Brmanzo/esp-computer-vision/docs/showcase_poster.pdf

## Network Quantization

- Weights start as floating points, then progressive QAT gradually reduces precision as low as ternary (2-bit).
- Learned weights captured as integers and exported to verilog ROM files for simulation and synthesis.
- During training, each neural network layer dynamically learns the optimal clipping range (2b
) and scale (1/(2shift)).
- In hardware, the scale and shifted range are exported as Verilog Parameters for each layer.

Parameterized Clipping Activation (PACT) [2]

Unified Progressive [Weight] Quantization (UPQ) [1]

- Pixels arrive once-per-cycle in row-major-order, streaming into the line buffers.
- The kernel window combines current and past rows, sliding across the input image.
- Low-precision quantization packs multiple parallel channels per BRAM memory.

This project introduces a novel software-hardware codesign environment that interfaces an FPGA with a microcontroller to enable real-time, edge-based computer vision without relying on cloud infrastructure. Within this environment, Convolutional Neural Networks (CNNs) are trained in PyTorch with quantized parameters, and seamlessly transformed into an equivalent Verilog implementation. This parameterized streaming architecture fully utilizes the FPGA's limited compute resources (LCs, DSPs, BRAMs) to perform inference on a binarized live input feed from the microcontroller. Finally, design time is drastically reduced by profiling each module's hardware overhead, generating all valid network topologies, and ranking them based on highly accurate performance predictions.

## Introduction

# FPGA-Based CNN Accelerator

## Bradley Manzo

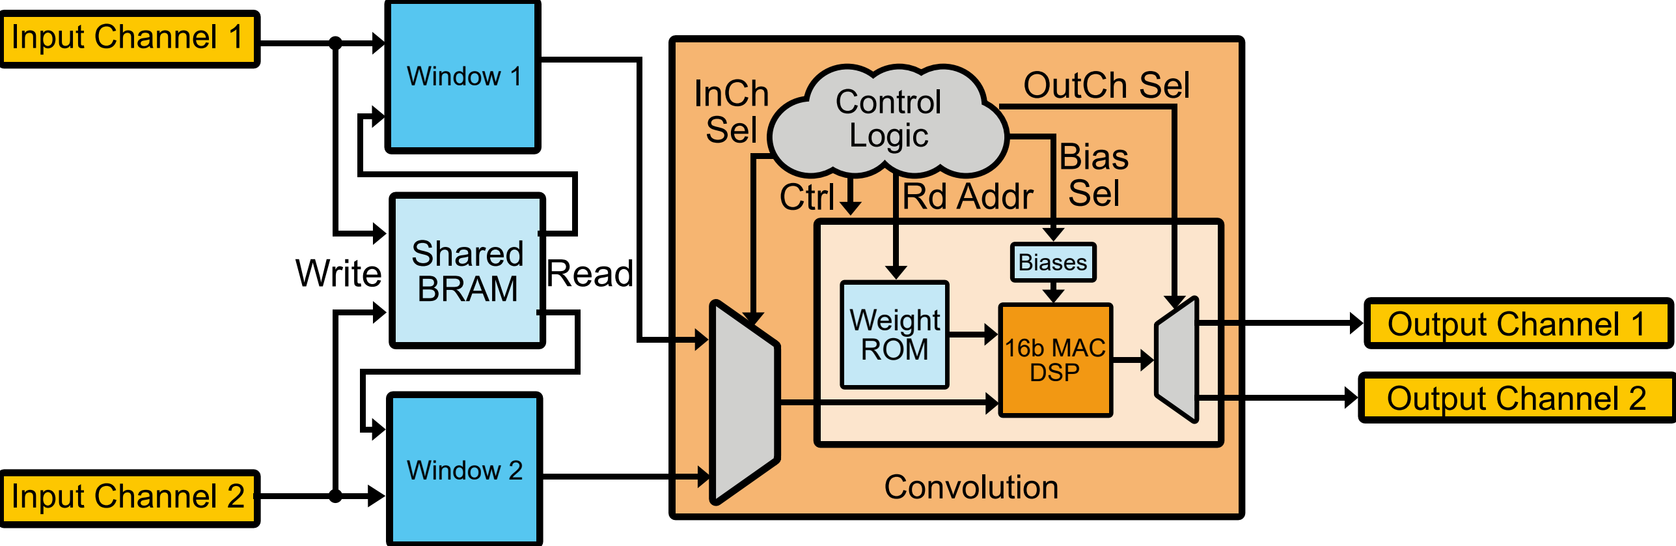
[picture p1: figure]
Convolution; InCh Sel; Biases; Weight; ROM; 16b MAC; DSP; Rd Addr; Bias Sel; OutCh Sel; Ctrl; Control Logic; Output Channel 2; Output Channel 1; Shared BRAM; Window 2; Window 1; Input Channel 2; Write; Read; Input Channel 1

- Convolution layers compute dot products between the sliding window and weights.
- Combinational mode offers single-cycle latency, optimal for lower input bandwidth.
- Sequential mode trades DSP blocks and added latency to save Logic Cells (LC).
- Pooling layer data movement is identical, but performs a max instead of dot product..

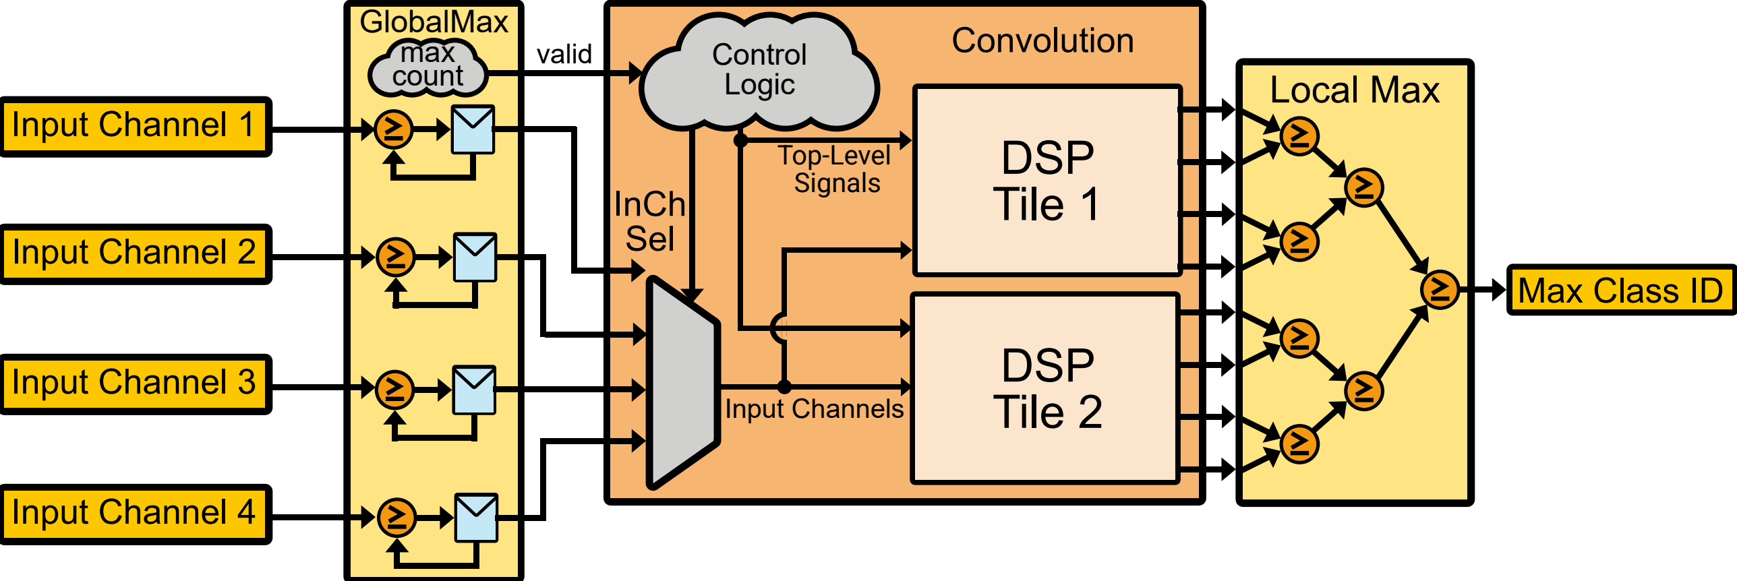
[picture p2: figure]
Convolution; InCh Sel; DSP Tile 2; DSP Tile 1; Top-Level Signals; Input Channels; Control Logic; max count; valid; GlobalMax; Local Max; Max Class ID; Input Channel 4; Input Channel 3; Input Channel 2; Input Channel 1

- Classifier layer connects sequential global max with 1x1 convolution and local max.
- Latency can be reduced by dividing the workload over multiple DSPs.

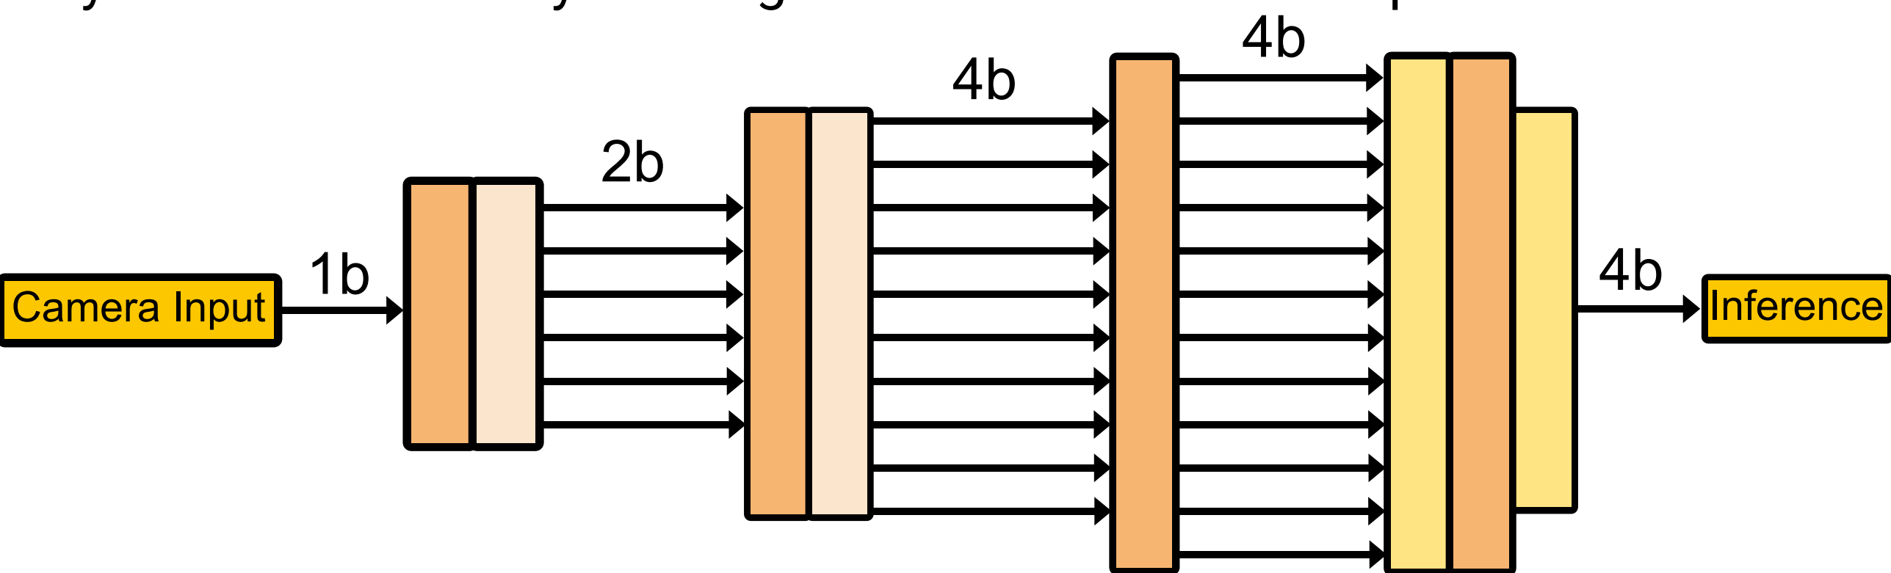
[picture p3: figure]
Camera Input 1b; Inference

- PyTorch network mapped to Verilog, confirming it fits within FPGA hardware budget.
- [1] J. H. Lee et al., "Unifying block-wise PTQ and distillation-based QAT...", arXiv:2506.09104, 2025. [2] J. Choi et al., "PACT: Parameterized Clipping Activation for Quantized Neural Networks", arXiv:1805.06085, 2018.

13 Input Pixel

Kernel Window
1 | 2 | 3
6 | 7 | 8
11 | 12 | 13

1 2 3 4 5
6 7 8 9 10
11 12 13 14 15
16 17 18 19 20
21 22 23 24 25

Input Image

8 | 9 | 10 | 11 12
3 | 4 | 5 | 6 | 7

Line Buffers

## System Architecture

Logic Cells

Layer
301 | 301
1 | 1
0 | 0 | 1 | 0 | 1
5 | 3 | 10 | 1
1
666 | 672 | 1114 | 822 | 4330/4806 21/29 3/8
Block RAMs
DSPs
C0 | P0 | C1 | P1 | C2 | Classifier | Total

## Results

## Design-Space Exploration

Convolution LUT4 and FF Usage vs DSP Allocation

Allocated DSPs

Flip-Flop Utilization

Allocated DSPs
- Synthesized each module over all parameter combinations.
- Trained regression models to predict FF and LUT4 costs.
- Developed a constrained DFS to generate all real networks. .
- Trained resulting networks on the MNIST dataset.
- Architectures that fully utilize logic cells perform better.
- Ternary activations allow for deeper networks, but gradients vanish, with accuracy peaking at networks with three layers.

By integrating this network sweep and accuracy prediction within an automated toolchain, designers can rapidly deploy the globally optimal architecture for accuracy and throughput. Benchmarking using the MNIST dataset yields real quantized accuracy of 95% and 72 fps. This exact accuracy was rigorously verified through cycle-accurate simulations, validated physically on the FPGA, and fully integrated for lowpower edge inference via the ESP32c3 and Arducam frontend.

Network Depth (Layers)

Throughput (FPS)

Natural Log of Accuracy)

Total Logic Cell (LC) Cost

LC Headroom (- 9% error)

Ternary Datapath Percentage

- Regression model then
trained to predict accuracy from network architecture.
- Designers can select from top networks for throughput.
