Brmanzo/esp-computer-vision/nn/sweep/bitstream_results.txt

 idx  pred_lut4  act_lut4  lut4_err  pred_ff  act_ff   ff_err  pred_lc  act_lc   lc_err  status            arch
────────────────────────────────────────────────────────────────────────────────────────────────────────────────────────────────────────────────────────────────────────────────────
   0       1480         —       —        621         —      —       1738         —      —    aborted           [1737 LC  784.9 fps]  conv( 2ch 2b      +p)  →  conv( 4ch 2b w8 d1+p)
   1       1515         —       —        665         —      —       1859         —      —    aborted           [1858 LC  527.8 fps]  conv( 2ch 2b      +p)  →  conv( 6ch 2b w8 d1+p)
   2       1763         —       —        708         —      —       1977         —      —    aborted           [1976 LC  784.9 fps]  conv( 2ch 3b      +p)  →  conv( 4ch 3b w8 d1+p)
   3       1547         —       —        709         —      —       1980         —      —    aborted           [1979 LC  397.6 fps]  conv( 2ch 2b      +p)  →  conv( 8ch 2b w8 d1+p)
   4       1564         —       —        731         —      —       2040         —      —    aborted           [2039 LC  353.9 fps]  conv( 2ch 2b      +p)  →  conv( 9ch 2b w8 d1+p)
   5       1579         —       —        753         —      —       2100         —      —    aborted           [2099 LC  318.9 fps]  conv( 2ch 2b      +p)  →  conv(10ch 2b w8 d1+p)
   6       1776         —       —        754         —      —       2103         —      —    aborted           [2102 LC  273.3 fps]  conv( 4ch 2b      +p)  →  conv( 6ch 2b w8 d1+p)
   7       1832         —       —        766         —      —       2136         —      —    aborted           [2132 LC  527.8 fps]  conv( 2ch 3b      +p)  →  conv( 6ch 3b w8 d1+p)
   8       1907         —       —        787         —      —       2194         —      —    aborted           [2193 LC  784.9 fps]  conv( 2ch 4b      +p)  →  conv( 4ch 4b w8 d1+p)
   9       1614         —       —        797         —      —       2221         —      —    aborted           [2220 LC  266.2 fps]  conv( 2ch 2b      +p)  →  conv(12ch 2b w8 d1+p)
  10       1811         —       —        798         —      —       2224         —      —    aborted           [2223 LC  205.5 fps]  conv( 4ch 2b      +p)  →  conv( 8ch 2b w8 d1+p)
  11       1829         —       —        820         —      —       2284         —      —    aborted           [2283 LC  182.8 fps]  conv( 4ch 2b      +p)  →  conv( 9ch 2b w8 d1+p)
  12       1901      2265    +16.1%      824       964   +14.5%     2295      2266    -1.3%  ok                [2291 LC  397.6 fps]  conv( 2ch 3b      +p)  →  conv( 8ch 3b w8 d1+p)
  13       1846         —       —        842         —      —       2345         —      —    aborted           [2344 LC  164.6 fps]  conv( 4ch 2b      +p)  →  conv(10ch 2b w8 d1+p)
  14       1935      2341    +17.3%      854       993   +14.0%     2377      2342    -1.5%  ok                [2374 LC  353.9 fps]  conv( 2ch 3b      +p)  →  conv( 9ch 3b w8 d1+p)
  15       1989      2409    +17.4%      863      1024   +15.7%     2402      2410    +0.3%  ok                [2401 LC  527.8 fps]  conv( 2ch 4b      +p)  →  conv( 6ch 4b w8 d1+p)
  16       2140      2449    +12.6%      863      1044   +17.3%     2402      2450    +2.0%  ok                [2404 LC  784.9 fps]  conv( 2ch 5b      +p)  →  conv( 4ch 5b w8 d1+p)
  17       1970      2443    +19.4%      883      1019   +13.3%     2457      2444    -0.5%  ok                [2453 LC  318.9 fps]  conv( 2ch 3b      +p)  →  conv(10ch 3b w8 d1+p)
  18       1994         —       —        886         —      —       2465         —      —    aborted           [2464 LC  784.9 fps]  conv( 2ch 2b      +p)  →  conv( 4ch 2b w8 d1+p)  →  conv( 6ch 2b w8 d1+p)
  19       1883         —       —        886         —      —       2465         —      —    aborted           [2464 LC  137.3 fps]  conv( 4ch 2b      +p)  →  conv(12ch 2b w8 d1+p)
  20       2076         —       —        886         —      —       2465         —      —    aborted           [2464 LC  138.5 fps]  conv( 6ch 2b      +p)  →  conv( 8ch 2b w8 d1+p)
  21       2289      2498     +8.4%      893      1086   +17.8%     2484      2499    +0.6%  ok                [2481 LC  273.3 fps]  conv( 4ch 3b      +p)  →  conv( 6ch 3b w8 d1+p)
  22       2096         —       —        908         —      —       2525         —      —    aborted           [2524 LC  123.2 fps]  conv( 6ch 2b      +p)  →  conv( 9ch 2b w8 d1+p)
  23       2029         —       —        930         —      —       2586         —      —    aborted           [2585 LC  784.9 fps]  conv( 2ch 2b      +p)  →  conv( 4ch 2b w8 d1+p)  →  conv( 8ch 2b w8 d1+p)
  24       2113         —       —        930         —      —       2586         —      —    aborted           [2585 LC  110.9 fps]  conv( 6ch 2b      +p)  →  conv(10ch 2b w8 d1+p)
  25       2069      2560    +19.2%      939      1098   +14.5%     2611      2561    -1.9%  ok                [2610 LC  397.6 fps]  conv( 2ch 4b      +p)  →  conv( 8ch 4b w8 d1+p)
  26       2039      2512    +18.8%      941      1074   +12.4%     2616      2513    -4.1%  ok                [2612 LC  266.2 fps]  conv( 2ch 3b      +p)  →  conv(12ch 3b w8 d1+p)
  27       2358      2638    +10.6%      950      1144   +17.0%     2641      2639    -0.0%  ok                [2640 LC  205.5 fps]  conv( 4ch 3b      +p)  →  conv( 8ch 3b w8 d1+p)
  28       2047         —       —        952         —      —       2646         —      —    aborted           [2645 LC  731.0 fps]  conv( 2ch 2b      +p)  →  conv( 4ch 2b w8 d1+p)  →  conv( 9ch 2b w8 d1+p)
  29       2253         —       —        955         —      —       2654         —      —    aborted           [2656 LC  527.8 fps]  conv( 2ch 5b      +p)  →  conv( 6ch 5b w8 d1+p)
  30       2064         —       —        974         —      —       2706         —      —    aborted           [2705 LC  658.3 fps]  conv( 2ch 2b      +p)  →  conv( 4ch 2b w8 d1+p)  →  conv(10ch 2b w8 d1+p)
  31       2153         —       —        974         —      —       2706         —      —    aborted           [2705 LC   92.5 fps]  conv( 6ch 2b      +p)  →  conv(12ch 2b w8 d1+p)
  32       2112      2656    +20.5%      977      1136   +14.0%     2715      2657    -2.2%  ok                [2714 LC  353.9 fps]  conv( 2ch 4b      +p)  →  conv( 9ch 4b w8 d1+p)
  33       2391      2707    +11.7%      980      1171   +16.3%     2723      2708    -0.5%  ok                [2722 LC  182.8 fps]  conv( 4ch 3b      +p)  →  conv( 9ch 3b w8 d1+p)
  34       2362         —       —        997         —      —       2770         —      —    aborted           [2769 LC   92.9 fps]  conv( 8ch 2b      +p)  →  conv( 9ch 2b w8 d1+p)
  35       2426      2771    +12.5%     1009      1198   +15.8%     2802      2772    -1.1%  ok                [2801 LC  164.6 fps]  conv( 4ch 3b      +p)  →  conv(10ch 3b w8 d1+p)
  36       2153      2756    +21.9%     1015      1171   +13.3%     2819      2757    -2.2%  ok                [2818 LC  318.9 fps]  conv( 2ch 4b      +p)  →  conv(10ch 4b w8 d1+p)
  37       2157         —       —       1016         —      —       2822         —      —    aborted           [2821 LC  527.8 fps]  conv( 2ch 2b      +p)  →  conv( 6ch 2b w8 d1+p)  →  conv( 8ch 2b w8 d1+p)
  38       2101         —       —       1018         —      —       2827         —      —    aborted           [2826 LC  549.1 fps]  conv( 2ch 2b      +p)  →  conv( 4ch 2b w8 d1+p)  →  conv(12ch 2b w8 d1+p)
  39       2380         —       —       1019         —      —       2830         —      —    aborted           [2829 LC   83.6 fps]  conv( 8ch 2b      +p)  →  conv(10ch 2b w8 d1+p)
  40       2560         —       —       1027         —      —       2852         —      —    aborted           [2851 LC  273.3 fps]  conv( 4ch 4b      +p)  →  conv( 6ch 4b w8 d1+p)
  41       2177         —       —       1038         —      —       2882         —      —    aborted           [2881 LC  492.8 fps]  conv( 2ch 2b      +p)  →  conv( 6ch 2b w8 d1+p)  →  conv( 9ch 2b w8 d1+p)
  42       2364      2845    +16.9%     1048      1228   +14.7%     2909      2846    -2.2%  ok                [2911 LC  397.6 fps]  conv( 2ch 5b      +p)  →  conv( 8ch 5b w8 d1+p)
  43       2194         —       —       1060         —      —       2942         —      —    aborted           [2941 LC  443.7 fps]  conv( 2ch 2b      +p)  →  conv( 6ch 2b w8 d1+p)  →  conv(10ch 2b w8 d1+p)
  44       2469      3155    +21.7%     1063      1410   +24.6%     2951      3156    +6.5%  ok                [2947 LC  784.9 fps]  conv( 2ch 3b      +p)  →  conv( 4ch 3b w8 d1+p)  →  conv( 6ch 3b w8 d1+p)
  45       2423         —       —       1063         —      —       2951         —      —    aborted           [2950 LC   69.7 fps]  conv( 8ch 2b      +p)  →  conv(12ch 2b w8 d1+p)
  46       2513         —       —       1063         —      —       2951         —      —    aborted           [2950 LC   74.5 fps]  conv( 9ch 2b      +p)  →  conv(10ch 2b w8 d1+p)
  47       2494         —       —       1067         —      —       2962         —      —    aborted           [2961 LC  137.3 fps]  conv( 4ch 3b      +p)  →  conv(12ch 3b w8 d1+p)
  48       2813      2970     +5.3%     1077      1315   +18.1%     2989      2971    -0.6%  ok                [2988 LC  138.5 fps]  conv( 6ch 3b      +p)  →  conv( 8ch 3b w8 d1+p)
  49       2233      2840    +21.4%     1091      1243   +12.2%     3027      2841    -6.5%  ok                [3026 LC  266.2 fps]  conv( 2ch 4b      +p)  →  conv(12ch 4b w8 d1+p)
  50       2419         —       —       1094         —      —       3036         —      —    aborted           [3037 LC  353.9 fps]  conv( 2ch 5b      +p)  →  conv( 9ch 5b w8 d1+p)
  51       2642      3014    +12.3%     1103      1331   +17.1%     3060      3015    -1.5%  ok                [3059 LC  205.5 fps]  conv( 4ch 4b      +p)  →  conv( 8ch 4b w8 d1+p)
  52       2234         —       —       1104         —      —       3063         —      —    aborted           [3062 LC  369.9 fps]  conv( 2ch 2b      +p)  →  conv( 6ch 2b w8 d1+p)  →  conv(12ch 2b w8 d1+p)
  53       2418         —       —       1105         —      —       3066         —      —    aborted           [3065 LC  273.3 fps]  conv( 4ch 2b      +p)  →  conv( 6ch 2b w8 d1+p)  →  conv( 8ch 2b w8 d1+p)
  54       2847      3074     +7.4%     1107      1346   +17.8%     3071      3075    +0.1%  ok                [3070 LC  123.2 fps]  conv( 6ch 3b      +p)  →  conv( 9ch 3b w8 d1+p)
  55       2557         —       —       1107         —      —       3071         —      —    aborted           [3070 LC   62.1 fps]  conv( 9ch 2b      +p)  →  conv(12ch 2b w8 d1+p)
  56       2538         —       —       1120         —      —       3107         —      —    aborted           [3106 LC  784.9 fps]  conv( 2ch 3b      +p)  →  conv( 4ch 3b w8 d1+p)  →  conv( 8ch 3b w8 d1+p)
  57       2304         —       —       1124         —      —       3118         —      —    aborted           [3117 LC  371.6 fps]  conv( 2ch 2b      +p)  →  conv( 8ch 2b w8 d1+p)  →  conv( 9ch 2b w8 d1+p)
  58       2438         —       —       1127         —      —       3126         —      —    aborted           [3125 LC  273.3 fps]  conv( 4ch 2b      +p)  →  conv( 6ch 2b w8 d1+p)  →  conv( 9ch 2b w8 d1+p)
  59       2881      3150     +8.5%     1136      1376   +17.4%     3151      3151    +0.0%  ok                [3150 LC  110.9 fps]  conv( 6ch 3b      +p)  →  conv(10ch 3b w8 d1+p)
  60       2476      3061    +19.1%     1140      1326   +14.0%     3162      3062    -3.2%  ok                [3163 LC  318.9 fps]  conv( 2ch 5b      +p)  →  conv(10ch 5b w8 d1+p)
  61       2686      3165    +15.1%     1141      1371   +16.8%     3164      3166    +0.1%  ok                [3163 LC  182.8 fps]  conv( 4ch 4b      +p)  →  conv( 9ch 4b w8 d1+p)
  62       2322         —       —       1146         —      —       3178         —      —    aborted           [3177 LC  334.6 fps]  conv( 2ch 2b      +p)  →  conv( 8ch 2b w8 d1+p)  →  conv(10ch 2b w8 d1+p)
  63       2455         —       —       1149         —      —       3186         —      —    aborted           [3185 LC  273.3 fps]  conv( 4ch 2b      +p)  →  conv( 6ch 2b w8 d1+p)  →  conv(10ch 2b w8 d1+p)
  64       2571      3168    +18.8%     1150      1405   +18.1%     3189      3169    -0.6%  ok                [3188 LC  731.0 fps]  conv( 2ch 3b      +p)  →  conv( 4ch 3b w8 d1+p)  →  conv( 9ch 3b w8 d1+p)
  65       2691         —       —       1151         —      —       3192         —      —    aborted           [3191 LC   56.0 fps]  conv(10ch 2b      +p)  →  conv(12ch 2b w8 d1+p)
  66       3020      3291     +8.2%     1158      1429   +19.0%     3211      3292    +2.5%  ok                [3213 LC  273.3 fps]  conv( 4ch 5b      +p)  →  conv( 6ch 5b w8 d1+p)
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
 300       3304      4809    +31.3%     1712      2374   +27.9%     4730      4810    +1.7%  ok                [4729 LC  297.9 fps]  conv( 2ch 2b      +p)  →  conv( 9ch 2b w8 d1+p)  →  conv(10ch 2b w8 d1+p)  →  conv(12ch 2b w8 d1+p)
 301       3648      4700    +22.4%     1713      2178   +21.3%     4733      4700    -0.7%  ok                [4732 LC  273.3 fps]  conv( 4ch 4b      +p)  →  conv( 6ch 4b w8 d1+p)  →  conv(10ch 4b w8 d1+p)
 302       3435      4536    +24.3%     1715      2269   +24.4%     4738      4537    -4.4%  ok                [4737 LC  205.5 fps]  conv( 4ch 2b      +p)  →  conv( 8ch 2b w8 d1+p)  →  conv( 9ch 2b w8 d1+p)  →  conv(12ch 2b w8 d1+p)
 303       3758      4919    +23.6%     1719      2301   +25.3%     4749      4920    +3.5%  ok                [4748 LC  182.8 fps]  conv( 4ch 4b      +p)  →  conv( 9ch 4b w8 d1+p)  →  conv(12ch 4b w8 d1  )
 304       3699      4768    +22.4%     1718      2285   +24.8%     4747      4769    +0.5%  ok                [4748 LC  138.5 fps]  conv( 6ch 2b      +p)  →  conv( 8ch 5b w8 d1+p)  →  conv(10ch 5b w8 d1  )
────────────────────────────────────────────────────────────────────────────────────────────────────────────────────────────────────────────────────────────────────────────────────
LC Error Stats:  Min: -9.2%  |  Max: +9.1%  |  Avg: +1.7%  |  StdDev: 3.4%
