Brmanzo/esp-computer-vision/profiling/nn_acc_pred/profiles/results.txt

 idx  float_acc  hw_acc  arch
──────────────────────────────────────────────────────────────────────────────────────────────────────────────
   0    aborted          [1757 LC  805.6 fps]  conv( 2ch 2b w4   +p)  →  conv( 4ch 2b w8 d1+p)
   1    aborted          [1877 LC  527.8 fps]  conv( 2ch 2b w4   +p)  →  conv( 6ch 2b w8 d1+p)
   2     0.2893  0.2400  [1883 LC  805.6 fps]  conv( 2ch 2b w4   +p)  →  conv( 4ch 3b w8 d1+p)
   3    aborted          [1984 LC  805.6 fps]  conv( 2ch 3b w4   +p)  →  conv( 4ch 3b w8 d1+p)
   4    aborted          [1987 LC  805.6 fps]  conv( 2ch 2b w4   +p)  →  conv( 4ch 4b w8 d1+p)
   5    aborted          [1998 LC  402.8 fps]  conv( 2ch 2b w4   +p)  →  conv( 8ch 2b w8 d1+p)
   6     0.3193  0.3000  [2042 LC  527.8 fps]  conv( 2ch 2b w4   +p)  →  conv( 6ch 3b w8 d1+p)
   7    aborted          [2058 LC  356.0 fps]  conv( 2ch 2b w4   +p)  →  conv( 9ch 2b w8 d1+p)
   8    aborted          [2086 LC  805.6 fps]  conv( 2ch 2b w4   +p)  →  conv( 4ch 5b w8 d1+p)
   9    aborted          [2088 LC  805.6 fps]  conv( 2ch 3b w4   +p)  →  conv( 4ch 4b w8 d1+p)
  10    aborted          [2119 LC  318.9 fps]  conv( 2ch 2b w4   +p)  →  conv(10ch 2b w8 d1+p)
  11    aborted          [2119 LC  273.3 fps]  conv( 4ch 2b w4   +p)  →  conv( 6ch 2b w8 d1+p)
  12    aborted          [2143 LC  527.8 fps]  conv( 2ch 3b w4   +p)  →  conv( 6ch 3b w8 d1+p)
  13    aborted          [2187 LC  805.6 fps]  conv( 2ch 3b w4   +p)  →  conv( 4ch 5b w8 d1+p)
  14     0.2538  0.2700  [2193 LC  805.6 fps]  conv( 2ch 4b      +p)  →  conv( 4ch 4b w8 d1+p)
  15    aborted          [2195 LC  527.8 fps]  conv( 2ch 2b w4   +p)  →  conv( 6ch 4b w8 d1+p)
  16    aborted          [2201 LC  402.8 fps]  conv( 2ch 2b w4   +p)  →  conv( 8ch 3b w8 d1+p)
  17    aborted          [2239 LC  268.5 fps]  conv( 2ch 2b w4   +p)  →  conv(12ch 2b w8 d1+p)
  18    aborted          [2239 LC  206.8 fps]  conv( 4ch 2b w4   +p)  →  conv( 8ch 2b w8 d1+p)
  19     0.4610  0.4900  [2283 LC  356.0 fps]  conv( 2ch 2b w4   +p)  →  conv( 9ch 3b w8 d1+p)
  20    aborted          [2283 LC  273.3 fps]  conv( 4ch 2b w4   +p)  →  conv( 6ch 3b w8 d1+p)
  21     0.3829  0.4500  [2291 LC  805.6 fps]  conv( 2ch 4b      +p)  →  conv( 4ch 5b w8 d1+p)
  22    aborted          [2297 LC  527.8 fps]  conv( 2ch 3b w4   +p)  →  conv( 6ch 4b w8 d1+p)
  23    aborted          [2300 LC  184.4 fps]  conv( 4ch 2b w4   +p)  →  conv( 9ch 2b w8 d1+p)
  24     0.4168  0.2600  [2302 LC  402.8 fps]  conv( 2ch 3b w4   +p)  →  conv( 8ch 3b w8 d1+p)
  25    aborted          [2338 LC  527.8 fps]  conv( 2ch 2b w4   +p)  →  conv( 6ch 5b w8 d1+p)
  26    aborted          [2360 LC  164.6 fps]  conv( 4ch 2b w4   +p)  →  conv(10ch 2b w8 d1+p)
  27    aborted          [2363 LC  318.9 fps]  conv( 2ch 2b w4   +p)  →  conv(10ch 3b w8 d1+p)
  28     0.4122  0.2800  [2385 LC  356.0 fps]  conv( 2ch 3b w4   +p)  →  conv( 9ch 3b w8 d1+p)
  29    aborted          [2398 LC  805.6 fps]  conv( 2ch 5b w4   +p)  →  conv( 4ch 5b w8 d1+p)
  30     0.4391  0.4500  [2401 LC  527.8 fps]  conv( 2ch 4b      +p)  →  conv( 6ch 4b w8 d1+p)
  31    aborted          [2404 LC  402.8 fps]  conv( 2ch 2b w4   +p)  →  conv( 8ch 4b w8 d1+p)
  32    aborted          [2437 LC  273.3 fps]  conv( 4ch 2b w4   +p)  →  conv( 6ch 4b w8 d1+p)
  33     0.3642  0.4000  [2439 LC  527.8 fps]  conv( 2ch 3b w4   +p)  →  conv( 6ch 5b w8 d1+p)
  34    aborted          [2442 LC  206.8 fps]  conv( 4ch 2b w4   +p)  →  conv( 8ch 3b w8 d1+p)
  35     0.5342  0.3900  [2464 LC  318.9 fps]  conv( 2ch 3b w4   +p)  →  conv(10ch 3b w8 d1+p)
  36    aborted          [2481 LC  137.9 fps]  conv( 4ch 2b w4   +p)  →  conv(12ch 2b w8 d1+p)
  37    aborted          [2483 LC  805.6 fps]  conv( 2ch 2b w4   +p)  →  conv( 4ch 2b w8 d1+p)  →  conv( 6ch 2b w8 d1+p)
  38    aborted          [2483 LC  139.1 fps]  conv( 6ch 2b w4   +p)  →  conv( 8ch 2b w8 d1+p)
  39    aborted          [2489 LC  273.3 fps]  conv( 4ch 3b w4   +p)  →  conv( 6ch 3b w8 d1+p)
  40    aborted          [2505 LC  402.8 fps]  conv( 2ch 3b w4   +p)  →  conv( 8ch 4b w8 d1+p)
  41     0.4571  0.4400  [2508 LC  356.0 fps]  conv( 2ch 2b w4   +p)  →  conv( 9ch 4b w8 d1+p)
  42     0.4903  0.5200  [2522 LC  268.5 fps]  conv( 2ch 2b w4   +p)  →  conv(12ch 3b w8 d1+p)
  43     0.4840  0.4800  [2524 LC  184.4 fps]  conv( 4ch 2b w4   +p)  →  conv( 9ch 3b w8 d1+p)
  44     0.4470  0.5100  [2544 LC  527.8 fps]  conv( 2ch 4b      +p)  →  conv( 6ch 5b w8 d1+p)
  45    aborted          [2544 LC  123.4 fps]  conv( 6ch 2b w4   +p)  →  conv( 9ch 2b w8 d1+p)
  46     0.4012  0.4500  [2579 LC  273.3 fps]  conv( 4ch 2b w4   +p)  →  conv( 6ch 5b w8 d1+p)
  47    aborted          [2593 LC  402.8 fps]  conv( 2ch 2b w4   +p)  →  conv( 8ch 5b w8 d1+p)
  48    aborted          [2604 LC  805.6 fps]  conv( 2ch 2b w4   +p)  →  conv( 4ch 2b w8 d1+p)  →  conv( 8ch 2b w8 d1+p)
  49    aborted          [2604 LC  164.6 fps]  conv( 4ch 2b w4   +p)  →  conv(10ch 3b w8 d1+p)
  50    aborted          [2604 LC  110.9 fps]  conv( 6ch 2b w4   +p)  →  conv(10ch 2b w8 d1+p)
  51     0.4569  0.3200  [2610 LC  356.0 fps]  conv( 2ch 3b w4   +p)  →  conv( 9ch 4b w8 d1+p)
  52     0.4196  0.2300  [2610 LC  402.8 fps]  conv( 2ch 4b      +p)  →  conv( 8ch 4b w8 d1+p)
  53    aborted          [2612 LC  318.9 fps]  conv( 2ch 2b w4   +p)  →  conv(10ch 4b w8 d1+p)
  54     0.5791  0.3800  [2623 LC  268.5 fps]  conv( 2ch 3b w4   +p)  →  conv(12ch 3b w8 d1+p)
  55     0.4798  0.4900  [2642 LC  273.3 fps]  conv( 4ch 3b w4   +p)  →  conv( 6ch 4b w8 d1+p)
  56     0.4815  0.4100  [2645 LC  206.8 fps]  conv( 4ch 2b w4   +p)  →  conv( 8ch 4b w8 d1+p)
  57     0.4180  0.4600  [2648 LC  805.6 fps]  conv( 2ch 2b w4   +p)  →  conv( 4ch 2b w8 d1+p)  →  conv( 6ch 3b w8 d1+p)
  58     0.5269  0.2100  [2648 LC  206.8 fps]  conv( 4ch 3b w4   +p)  →  conv( 8ch 3b w8 d1+p)
  59    aborted          [2651 LC  527.8 fps]  conv( 2ch 5b w4   +p)  →  conv( 6ch 5b w8 d1+p)
  60    aborted          [2664 LC  765.3 fps]  conv( 2ch 2b w4   +p)  →  conv( 4ch 2b w8 d1+p)  →  conv( 9ch 2b w8 d1+p)
  61     0.4308  0.3600  [2686 LC  139.1 fps]  conv( 6ch 2b w4   +p)  →  conv( 8ch 3b w8 d1+p)
  62    aborted          [2695 LC  402.8 fps]  conv( 2ch 3b w4   +p)  →  conv( 8ch 5b w8 d1+p)
  63    aborted          [2714 LC  318.9 fps]  conv( 2ch 3b w4   +p)  →  conv(10ch 4b w8 d1+p)
  64     0.4616  0.4400  [2714 LC  356.0 fps]  conv( 2ch 4b      +p)  →  conv( 9ch 4b w8 d1+p)
  65     0.3885  0.3400  [2719 LC  356.0 fps]  conv( 2ch 2b w4   +p)  →  conv( 9ch 5b w8 d1+p)
  66    aborted          [2725 LC  665.5 fps]  conv( 2ch 2b w4   +p)  →  conv( 4ch 2b w8 d1+p)  →  conv(10ch 2b w8 d1+p)
  67    aborted          [2725 LC   92.8 fps]  conv( 6ch 2b w4   +p)  →  conv(12ch 2b w8 d1+p)
  68     0.4901  0.4400  [2730 LC  184.4 fps]  conv( 4ch 3b w4   +p)  →  conv( 9ch 3b w8 d1+p)
  69     0.4954  0.4400  [2749 LC  184.4 fps]  conv( 4ch 2b w4   +p)  →  conv( 9ch 4b w8 d1+p)
  70     0.5626  0.5500  [2763 LC  137.9 fps]  conv( 4ch 2b w4   +p)  →  conv(12ch 3b w8 d1+p)
  71     0.5431  0.5900  [2769 LC  123.4 fps]  conv( 6ch 2b w4   +p)  →  conv( 9ch 3b w8 d1+p)
  72     0.4508  0.4000  [2785 LC  273.3 fps]  conv( 4ch 3b w4   +p)  →  conv( 6ch 5b w8 d1+p)
  73    aborted          [2788 LC   93.3 fps]  conv( 8ch 2b w4   +p)  →  conv( 9ch 2b w8 d1+p)
  74     0.4399  0.3800  [2799 LC  402.8 fps]  conv( 2ch 4b      +p)  →  conv( 8ch 5b w8 d1+p)
  75     0.4473  0.4800  [2801 LC  805.6 fps]  conv( 2ch 2b w4   +p)  →  conv( 4ch 2b w8 d1+p)  →  conv( 6ch 4b w8 d1+p)
  76     0.5028  0.4300  [2807 LC  805.6 fps]  conv( 2ch 2b w4   +p)  →  conv( 4ch 2b w8 d1+p)  →  conv( 8ch 3b w8 d1+p)
  77    aborted          [2810 LC  164.6 fps]  conv( 4ch 3b w4   +p)  →  conv(10ch 3b w8 d1+p)
  78     0.5492  0.6300  [2818 LC  318.9 fps]  conv( 2ch 4b      +p)  →  conv(10ch 4b w8 d1+p)
  79     0.4500  0.4900  [2821 LC  268.5 fps]  conv( 2ch 2b w4   +p)  →  conv(12ch 4b w8 d1+p)
  80    aborted          [2821 LC  356.0 fps]  conv( 2ch 3b w4   +p)  →  conv( 9ch 5b w8 d1+p)
  81     0.4018  0.4300  [2834 LC  206.8 fps]  conv( 4ch 2b w4   +p)  →  conv( 8ch 5b w8 d1+p)
  82    aborted          [2840 LC  527.8 fps]  conv( 2ch 2b w4   +p)  →  conv( 6ch 2b w8 d1+p)  →  conv( 8ch 2b w8 d1+p)
  83    aborted          [2845 LC  566.9 fps]  conv( 2ch 2b w4   +p)  →  conv( 4ch 2b w8 d1+p)  →  conv(12ch 2b w8 d1+p)
  84     0.4169  0.4900  [2845 LC  318.9 fps]  conv( 2ch 2b w4   +p)  →  conv(10ch 5b w8 d1+p)
  85    aborted          [2848 LC  110.9 fps]  conv( 6ch 2b w4   +p)  →  conv(10ch 3b w8 d1+p)
  86    aborted          [2848 LC   83.6 fps]  conv( 8ch 2b w4   +p)  →  conv(10ch 2b w8 d1+p)
  87     0.5563  0.5200  [2851 LC  206.8 fps]  conv( 4ch 3b w4   +p)  →  conv( 8ch 4b w8 d1+p)
  88     0.3628  0.4400  [2851 LC  273.3 fps]  conv( 4ch 4b      +p)  →  conv( 6ch 4b w8 d1+p)
  89     0.5027  0.5000  [2854 LC  805.6 fps]  conv( 2ch 2b w4   +p)  →  conv( 4ch 3b w8 d1+p)  →  conv( 6ch 3b w8 d1+p)
  90     0.5438  0.5300  [2854 LC  164.6 fps]  conv( 4ch 2b w4   +p)  →  conv(10ch 4b w8 d1+p)
  91     0.5047  0.5200  [2889 LC  765.3 fps]  conv( 2ch 2b w4   +p)  →  conv( 4ch 2b w8 d1+p)  →  conv( 9ch 3b w8 d1+p)
  92    aborted          [2889 LC  139.1 fps]  conv( 6ch 2b w4   +p)  →  conv( 8ch 4b w8 d1+p)
  93    aborted          [2900 LC  493.7 fps]  conv( 2ch 2b w4   +p)  →  conv( 6ch 2b w8 d1+p)  →  conv( 9ch 2b w8 d1+p)
  94     0.5119  0.1400  [2906 LC  402.8 fps]  conv( 2ch 5b w4   +p)  →  conv( 8ch 5b w8 d1+p)
  95     0.5923  0.4400  [2922 LC  268.5 fps]  conv( 2ch 3b w4   +p)  →  conv(12ch 4b w8 d1+p)
  96    aborted          [2925 LC  356.0 fps]  conv( 2ch 4b      +p)  →  conv( 9ch 5b w8 d1+p)
  97     0.4080  0.4600  [2944 LC  805.6 fps]  conv( 2ch 2b w4   +p)  →  conv( 4ch 2b w8 d1+p)  →  conv( 6ch 5b w8 d1+p)
  98     0.5103  0.5400  [2947 LC  318.9 fps]  conv( 2ch 3b w4   +p)  →  conv(10ch 5b w8 d1+p)
  99     0.5952  0.5200  [2955 LC  805.6 fps]  conv( 2ch 3b w4   +p)  →  conv( 4ch 3b w8 d1+p)  →  conv( 6ch 3b w8 d1+p)
 100     0.6692  0.6000  [2955 LC  184.4 fps]  conv( 4ch 3b w4   +p)  →  conv( 9ch 4b w8 d1+p)
 101    aborted          [2961 LC  450.2 fps]  conv( 2ch 2b w4   +p)  →  conv( 6ch 2b w8 d1+p)  →  conv(10ch 2b w8 d1+p)
 102     0.5177  0.5400  [2961 LC  184.4 fps]  conv( 4ch 2b w4   +p)  →  conv( 9ch 5b w8 d1+p)
 103     0.4947  0.6200  [2969 LC  665.5 fps]  conv( 2ch 2b w4   +p)  →  conv( 4ch 2b w8 d1+p)  →  conv(10ch 3b w8 d1+p)
 104     0.6437  0.5100  [2969 LC  137.9 fps]  conv( 4ch 3b w4   +p)  →  conv(12ch 3b w8 d1+p)
 105    aborted          [2969 LC   69.9 fps]  conv( 8ch 2b w4   +p)  →  conv(12ch 2b w8 d1+p)
 106    aborted          [2969 LC   74.7 fps]  conv( 9ch 2b w4   +p)  →  conv(10ch 2b w8 d1+p)
 107    aborted          [2993 LC  273.3 fps]  conv( 4ch 4b      +p)  →  conv( 6ch 5b w8 d1+p)
 108    aborted          [2993 LC  123.4 fps]  conv( 6ch 2b w4   +p)  →  conv( 9ch 4b w8 d1+p)
 109     0.5585  0.4600  [2996 LC  139.1 fps]  conv( 6ch 3b w4   +p)  →  conv( 8ch 3b w8 d1+p)
 110    aborted          [3007 LC  805.6 fps]  conv( 2ch 2b w4   +p)  →  conv( 4ch 3b w8 d1+p)  →  conv( 6ch 4b w8 d1+p)
 111     0.4866  0.5300  [3007 LC   92.8 fps]  conv( 6ch 2b w4   +p)  →  conv(12ch 3b w8 d1+p)
 112     0.5096  0.5300  [3010 LC  805.6 fps]  conv( 2ch 2b w4   +p)  →  conv( 4ch 2b w8 d1+p)  →  conv( 8ch 4b w8 d1+p)
 113     0.6495  0.5100  [3013 LC  805.6 fps]  conv( 2ch 2b w4   +p)  →  conv( 4ch 3b w8 d1+p)  →  conv( 8ch 3b w8 d1+p)
 114     0.5619  0.6700  [3013 LC   93.3 fps]  conv( 8ch 2b w4   +p)  →  conv( 9ch 3b w8 d1+p)
 115     0.6271  0.5500  [3026 LC  268.5 fps]  conv( 2ch 4b      +p)  →  conv(12ch 4b w8 d1+p)
 116     0.3952  0.3700  [3032 LC  356.0 fps]  conv( 2ch 5b w4   +p)  →  conv( 9ch 5b w8 d1+p)
 117     0.4979  0.5300  [3040 LC  206.8 fps]  conv( 4ch 3b w4   +p)  →  conv( 8ch 5b w8 d1+p)
 118     0.4946  0.5800  [3043 LC  527.8 fps]  conv( 2ch 2b w4   +p)  →  conv( 6ch 2b w8 d1+p)  →  conv( 8ch 3b w8 d1+p)
 119     0.4954  0.4100  [3051 LC  318.9 fps]  conv( 2ch 4b      +p)  →  conv(10ch 5b w8 d1+p)
 120     0.6283  0.6200  [3059 LC  164.6 fps]  conv( 4ch 3b w4   +p)  →  conv(10ch 4b w8 d1+p)
 121     0.4709  0.1400  [3059 LC  206.8 fps]  conv( 4ch 4b      +p)  →  conv( 8ch 4b w8 d1+p)
 122    aborted          [3062 LC  137.9 fps]  conv( 4ch 2b w4   +p)  →  conv(12ch 4b w8 d1+p)
 123     0.5575  0.5400  [3078 LC  139.1 fps]  conv( 6ch 2b w4   +p)  →  conv( 8ch 5b w8 d1+p)
 124     0.5809  0.4200  [3078 LC  123.4 fps]  conv( 6ch 3b w4   +p)  →  conv( 9ch 3b w8 d1+p)
 125    aborted          [3081 LC  373.3 fps]  conv( 2ch 2b w4   +p)  →  conv( 6ch 2b w8 d1+p)  →  conv(12ch 2b w8 d1+p)
 126    aborted          [3081 LC  273.3 fps]  conv( 4ch 2b w4   +p)  →  conv( 6ch 2b w8 d1+p)  →  conv( 8ch 2b w8 d1+p)
 127     0.5886  0.6100  [3087 LC  164.6 fps]  conv( 4ch 2b w4   +p)  →  conv(10ch 5b w8 d1+p)
 128    aborted          [3089 LC   62.2 fps]  conv( 9ch 2b w4   +p)  →  conv(12ch 2b w8 d1+p)
 129     0.5603  0.5700  [3092 LC   83.6 fps]  conv( 8ch 2b w4   +p)  →  conv(10ch 3b w8 d1+p)
 130     0.6613  0.5500  [3095 LC  765.3 fps]  conv( 2ch 2b w4   +p)  →  conv( 4ch 3b w8 d1+p)  →  conv( 9ch 3b w8 d1+p)
 131     0.5081  0.5800  [3098 LC  268.5 fps]  conv( 2ch 2b w4   +p)  →  conv(12ch 5b w8 d1+p)
 132     0.4512  0.4700  [3098 LC  110.9 fps]  conv( 6ch 2b w4   +p)  →  conv(10ch 4b w8 d1+p)
 133     0.6978  0.4400  [3109 LC  805.6 fps]  conv( 2ch 3b w4   +p)  →  conv( 4ch 3b w8 d1+p)  →  conv( 6ch 4b w8 d1+p)
 134     0.5104  0.6000  [3114 LC  765.3 fps]  conv( 2ch 2b w4   +p)  →  conv( 4ch 2b w8 d1+p)  →  conv( 9ch 4b w8 d1+p)
 135     0.6951  0.5500  [3114 LC  805.6 fps]  conv( 2ch 3b w4   +p)  →  conv( 4ch 3b w8 d1+p)  →  conv( 8ch 3b w8 d1+p)
 136     0.5866  0.5500  [3125 LC  493.7 fps]  conv( 2ch 2b w4   +p)  →  conv( 6ch 2b w8 d1+p)  →  conv( 9ch 3b w8 d1+p)
 137     0.5817  0.6200  [3128 LC  566.9 fps]  conv( 2ch 2b w4   +p)  →  conv( 4ch 2b w8 d1+p)  →  conv(12ch 3b w8 d1+p)
 138    aborted          [3136 LC  373.3 fps]  conv( 2ch 2b w4   +p)  →  conv( 8ch 2b w8 d1+p)  →  conv( 9ch 2b w8 d1+p)
 139    aborted          [3141 LC  273.3 fps]  conv( 4ch 2b w4   +p)  →  conv( 6ch 2b w8 d1+p)  →  conv( 9ch 2b w8 d1+p)
 140     0.6446  0.6400  [3150 LC  805.6 fps]  conv( 2ch 2b w4   +p)  →  conv( 4ch 3b w8 d1+p)  →  conv( 6ch 5b w8 d1+p)
 141    aborted          [3158 LC  318.9 fps]  conv( 2ch 5b w4   +p)  →  conv(10ch 5b w8 d1+p)
 142     0.6197  0.5400  [3158 LC  110.9 fps]  conv( 6ch 3b w4   +p)  →  conv(10ch 3b w8 d1+p)
 143     0.6207  0.6100  [3163 LC  184.4 fps]  conv( 4ch 4b      +p)  →  conv( 9ch 4b w8 d1+p)
 144    aborted          [3166 LC  184.4 fps]  conv( 4ch 3b w4   +p)  →  conv( 9ch 5b w8 d1+p)
 145     0.6453  0.6000  [3174 LC  665.5 fps]  conv( 2ch 2b w4   +p)  →  conv( 4ch 3b w8 d1+p)  →  conv(10ch 3b w8 d1+p)
 146    aborted          [3196 LC  340.1 fps]  conv( 2ch 2b w4   +p)  →  conv( 8ch 2b w8 d1+p)  →  conv(10ch 2b w8 d1+p)
 147     0.6252  0.3000  [3196 LC  765.3 fps]  conv( 2ch 3b w4   +p)  →  conv( 4ch 3b w8 d1+p)  →  conv( 9ch 3b w8 d1+p)
 148     0.2104  0.2300  [3199 LC  805.6 fps]  conv( 2ch 2b w4   +p)  →  conv( 4ch 2b w8 d1+p)  →  conv( 8ch 5b w8 d1+p)
 149     0.6218  0.5400  [3199 LC  268.5 fps]  conv( 2ch 3b w4   +p)  →  conv(12ch 5b w8 d1+p)
 150     0.5583  0.5700  [3199 LC  139.1 fps]  conv( 6ch 3b w4   +p)  →  conv( 8ch 4b w8 d1+p)
 151    aborted          [3202 LC  273.3 fps]  conv( 4ch 2b w4   +p)  →  conv( 6ch 2b w8 d1+p)  →  conv(10ch 2b w8 d1+p)
 152     0.6529  0.6800  [3205 LC  450.2 fps]  conv( 2ch 2b w4   +p)  →  conv( 6ch 2b w8 d1+p)  →  conv(10ch 3b w8 d1+p)
 153     0.4963  0.2400  [3205 LC  273.3 fps]  conv( 4ch 5b w4   +p)  →  conv( 6ch 5b w8 d1+p)
 154     0.5837  0.6000  [3205 LC  123.4 fps]  conv( 6ch 2b w4   +p)  →  conv( 9ch 5b w8 d1+p)
 155    aborted          [3210 LC   56.1 fps]  conv(10ch 2b w4   +p)  →  conv(12ch 2b w8 d1+p)
 156     0.4995  0.5800  [3213 LC   74.7 fps]  conv( 9ch 2b w4   +p)  →  conv(10ch 3b w8 d1+p)
 157     0.6193  0.5700  [3216 LC  805.6 fps]  conv( 2ch 2b w4   +p)  →  conv( 4ch 3b w8 d1+p)  →  conv( 8ch 4b w8 d1+p)
 158     0.6060  0.6200  [3216 LC  805.6 fps]  conv( 2ch 2b w4   +p)  →  conv( 4ch 4b w8 d1+p)  →  conv( 6ch 4b w8 d1+p)
 159    aborted          [3218 LC  665.5 fps]  conv( 2ch 2b w4   +p)  →  conv( 4ch 2b w8 d1+p)  →  conv(10ch 4b w8 d1+p)
 160     0.6340  0.6900  [3237 LC   93.3 fps]  conv( 8ch 2b w4   +p)  →  conv( 9ch 4b w8 d1+p)
 161     0.5158  0.5900  [3246 LC  527.8 fps]  conv( 2ch 2b w4   +p)  →  conv( 6ch 2b w8 d1+p)  →  conv( 8ch 4b w8 d1+p)
 162     0.5147  0.3700  [3248 LC  206.8 fps]  conv( 4ch 4b      +p)  →  conv( 8ch 5b w8 d1+p)
 163     0.6223  0.4600  [3251 LC  805.6 fps]  conv( 2ch 3b w4   +p)  →  conv( 4ch 3b w8 d1+p)  →  conv( 6ch 5b w8 d1+p)
 164     0.5010  0.4200  [3251 LC   69.9 fps]  conv( 8ch 2b w4   +p)  →  conv(12ch 3b w8 d1+p)
 165     0.6365  0.4900  [3268 LC  137.9 fps]  conv( 4ch 3b w4   +p)  →  conv(12ch 4b w8 d1+p)
 166     0.6994  0.7000  [3268 LC  164.6 fps]  conv( 4ch 4b      +p)  →  conv(10ch 4b w8 d1+p)
 167     0.7120  0.5700  [3276 LC  665.5 fps]  conv( 2ch 3b w4   +p)  →  conv( 4ch 3b w8 d1+p)  →  conv(10ch 3b w8 d1+p)
 168     0.4693  0.5200  [3284 LC  273.3 fps]  conv( 4ch 2b w4   +p)  →  conv( 6ch 2b w8 d1+p)  →  conv( 8ch 3b w8 d1+p)
 169     0.5738  0.2800  [3292 LC  164.6 fps]  conv( 4ch 3b w4   +p)  →  conv(10ch 5b w8 d1+p)
 170    aborted          [3303 LC  268.5 fps]  conv( 2ch 4b      +p)  →  conv(12ch 5b w8 d1+p)
 171     0.6902  0.7200  [3303 LC  123.4 fps]  conv( 6ch 3b w4   +p)  →  conv( 9ch 4b w8 d1+p)
 172     0.4740  0.4700  [3306 LC   92.8 fps]  conv( 6ch 2b w4   +p)  →  conv(12ch 4b w8 d1+p)
 173    aborted          [3314 LC  300.1 fps]  conv( 2ch 2b w4   +p)  →  conv( 9ch 2b w8 d1+p)  →  conv(10ch 2b w8 d1+p)
 174    aborted          [3317 LC  283.4 fps]  conv( 2ch 2b w4   +p)  →  conv( 8ch 2b w8 d1+p)  →  conv(12ch 2b w8 d1+p)
 175    aborted          [3317 LC  805.6 fps]  conv( 2ch 3b w4   +p)  →  conv( 4ch 3b w8 d1+p)  →  conv( 8ch 4b w8 d1+p)
 176     0.6125  0.4400  [3317 LC  805.6 fps]  conv( 2ch 3b w4   +p)  →  conv( 4ch 4b w8 d1+p)  →  conv( 6ch 4b w8 d1+p)
 177     0.6231  0.4500  [3317 LC   92.8 fps]  conv( 6ch 3b w4   +p)  →  conv(12ch 3b w8 d1+p)
 178     0.6126  0.6500  [3320 LC  765.3 fps]  conv( 2ch 2b w4   +p)  →  conv( 4ch 3b w8 d1+p)  →  conv( 9ch 4b w8 d1+p)
 179    aborted          [3322 LC  273.3 fps]  conv( 4ch 2b w4   +p)  →  conv( 6ch 2b w8 d1+p)  →  conv(12ch 2b w8 d1+p)
 180     0.4624  0.5000  [3325 LC  765.3 fps]  conv( 2ch 2b w4   +p)  →  conv( 4ch 2b w8 d1+p)  →  conv( 9ch 5b w8 d1+p)
 181    aborted          [3331 LC  110.9 fps]  conv( 6ch 2b w4   +p)  →  conv(10ch 5b w8 d1+p)
 182     0.6333  0.5600  [3333 LC  566.9 fps]  conv( 2ch 2b w4   +p)  →  conv( 4ch 3b w8 d1+p)  →  conv(12ch 3b w8 d1+p)
 183     0.4834  0.5100  [3339 LC  137.9 fps]  conv( 4ch 2b w4   +p)  →  conv(12ch 5b w8 d1+p)
 184    aborted          [3342 LC   83.6 fps]  conv( 8ch 2b w4   +p)  →  conv(10ch 4b w8 d1+p)
 185     0.5585  0.6100  [3350 LC  493.7 fps]  conv( 2ch 2b w4   +p)  →  conv( 6ch 2b w8 d1+p)  →  conv( 9ch 4b w8 d1+p)
 186     0.7149  0.6500  [3353 LC  527.8 fps]  conv( 2ch 2b w4   +p)  →  conv( 6ch 3b w8 d1+p)  →  conv( 8ch 3b w8 d1+p)
 187    aborted          [3358 LC  805.6 fps]  conv( 2ch 2b w4   +p)  →  conv( 4ch 4b w8 d1+p)  →  conv( 6ch 5b w8 d1+p)
 188     0.6322  0.6100  [3361 LC  373.3 fps]  conv( 2ch 2b w4   +p)  →  conv( 8ch 2b w8 d1+p)  →  conv( 9ch 3b w8 d1+p)
 189     0.6085  0.5700  [3364 LC  373.3 fps]  conv( 2ch 2b w4   +p)  →  conv( 6ch 2b w8 d1+p)  →  conv(12ch 3b w8 d1+p)
 190     0.5041  0.5600  [3366 LC  273.3 fps]  conv( 4ch 2b w4   +p)  →  conv( 6ch 2b w8 d1+p)  →  conv( 9ch 3b w8 d1+p)
 191     0.5462  0.4600  [3372 LC   62.2 fps]  conv( 9ch 2b w4   +p)  →  conv(12ch 3b w8 d1+p)
 192     0.5381  0.5900  [3375 LC  184.4 fps]  conv( 4ch 4b      +p)  →  conv( 9ch 5b w8 d1+p)
 193    aborted          [3377 LC  206.8 fps]  conv( 4ch 2b w4   +p)  →  conv( 8ch 2b w8 d1+p)  →  conv( 9ch 2b w8 d1+p)
 194     0.5663  0.5400  [3388 LC  139.1 fps]  conv( 6ch 3b w4   +p)  →  conv( 8ch 5b w8 d1+p)
 195     0.6507  0.6100  [3405 LC  805.6 fps]  conv( 2ch 2b w4   +p)  →  conv( 4ch 3b w8 d1+p)  →  conv( 8ch 5b w8 d1+p)
 196     0.6515  0.6100  [3407 LC  110.9 fps]  conv( 6ch 3b w4   +p)  →  conv(10ch 4b w8 d1+p)
 197    aborted          [3410 LC  268.5 fps]  conv( 2ch 5b w4   +p)  →  conv(12ch 5b w8 d1+p)
 198     0.7068  0.6000  [3421 LC  765.3 fps]  conv( 2ch 3b w4   +p)  →  conv( 4ch 3b w8 d1+p)  →  conv( 9ch 4b w8 d1+p)
 199     0.6510  0.6600  [3421 LC  805.6 fps]  conv( 2ch 4b      +p)  →  conv( 4ch 4b w8 d1+p)  →  conv( 6ch 4b w8 d1+p)
 200     0.7789  0.7700  [3424 LC  665.5 fps]  conv( 2ch 2b w4   +p)  →  conv( 4ch 3b w8 d1+p)  →  conv(10ch 4b w8 d1+p)
 201     0.5998  0.6100  [3424 LC  805.6 fps]  conv( 2ch 2b w4   +p)  →  conv( 4ch 4b w8 d1+p)  →  conv( 8ch 4b w8 d1+p)
 202     0.6000  0.6400  [3427 LC  566.9 fps]  conv( 2ch 2b w4   +p)  →  conv( 4ch 2b w8 d1+p)  →  conv(12ch 4b w8 d1+p)
 203     0.6036  0.4200  [3427 LC   93.3 fps]  conv( 8ch 3b w4   +p)  →  conv( 9ch 3b w8 d1+p)
 204     0.6236  0.6700  [3435 LC  527.8 fps]  conv( 2ch 2b w4   +p)  →  conv( 6ch 2b w8 d1+p)  →  conv( 8ch 5b w8 d1+p)
 205     0.7129  0.7000  [3435 LC  493.7 fps]  conv( 2ch 2b w4   +p)  →  conv( 6ch 3b w8 d1+p)  →  conv( 9ch 3b w8 d1+p)
 206    aborted          [3435 LC  250.9 fps]  conv( 2ch 2b w4   +p)  →  conv( 9ch 2b w8 d1+p)  →  conv(12ch 2b w8 d1+p)
 207     0.7207  0.6900  [3435 LC  566.9 fps]  conv( 2ch 3b w4   +p)  →  conv( 4ch 3b w8 d1+p)  →  conv(12ch 3b w8 d1+p)
 208    aborted          [3438 LC  206.8 fps]  conv( 4ch 2b w4   +p)  →  conv( 8ch 2b w8 d1+p)  →  conv(10ch 2b w8 d1+p)
 209     0.6442  0.6400  [3440 LC  340.1 fps]  conv( 2ch 2b w4   +p)  →  conv( 8ch 2b w8 d1+p)  →  conv(10ch 3b w8 d1+p)
 210    aborted          [3446 LC  805.6 fps]  conv( 2ch 2b w4   +p)  →  conv( 4ch 2b w8 d1+p)  →  conv( 6ch 2b w8 d1+p)  →  conv( 8ch 2b w8 d1+p)
 211     0.6410  0.6300  [3446 LC  273.3 fps]  conv( 4ch 2b w4   +p)  →  conv( 6ch 2b w8 d1+p)  →  conv(10ch 3b w8 d1+p)
 212     0.5106  0.5400  [3449 LC   93.3 fps]  conv( 8ch 2b w4   +p)  →  conv( 9ch 5b w8 d1+p)
 213     0.5433  0.5600  [3451 LC  665.5 fps]  conv( 2ch 2b w4   +p)  →  conv( 4ch 2b w8 d1+p)  →  conv(10ch 5b w8 d1+p)
 214     0.5334  0.5200  [3454 LC  450.2 fps]  conv( 2ch 2b w4   +p)  →  conv( 6ch 2b w8 d1+p)  →  conv(10ch 4b w8 d1+p)
 215     0.7514  0.5600  [3454 LC  527.8 fps]  conv( 2ch 3b w4   +p)  →  conv( 6ch 3b w8 d1+p)  →  conv( 8ch 3b w8 d1+p)
 216    aborted          [3460 LC  805.6 fps]  conv( 2ch 3b w4   +p)  →  conv( 4ch 4b w8 d1+p)  →  conv( 6ch 5b w8 d1+p)
 217     0.4671  0.4500  [3460 LC  206.8 fps]  conv( 4ch 5b w4   +p)  →  conv( 8ch 5b w8 d1+p)
 218     0.4920  0.5400  [3462 LC   74.7 fps]  conv( 9ch 2b w4   +p)  →  conv(10ch 4b w8 d1+p)
 219     0.6820  0.6200  [3476 LC  137.9 fps]  conv( 4ch 4b      +p)  →  conv(12ch 4b w8 d1+p)
 220     0.6098  0.7100  [3487 LC  273.3 fps]  conv( 4ch 2b w4   +p)  →  conv( 6ch 2b w8 d1+p)  →  conv( 8ch 4b w8 d1+p)
 221     0.5284  0.5400  [3492 LC   56.1 fps]  conv(10ch 2b w4   +p)  →  conv(12ch 3b w8 d1+p)
 222     0.6154  0.6100  [3501 LC  164.6 fps]  conv( 4ch 4b      +p)  →  conv(10ch 5b w8 d1+p)
 223     0.3982  0.3300  [3506 LC  805.6 fps]  conv( 2ch 2b w4   +p)  →  conv( 4ch 2b w8 d1+p)  →  conv( 6ch 2b w8 d1+p)  →  conv( 9ch 2b w8 d1+p)
 224     0.6459  0.6700  [3506 LC  805.6 fps]  conv( 2ch 3b w4   +p)  →  conv( 4ch 3b w8 d1+p)  →  conv( 8ch 5b w8 d1+p)
 225     0.6076  0.6200  [3506 LC   83.6 fps]  conv( 8ch 3b w4   +p)  →  conv(10ch 3b w8 d1+p)
 226     0.5860  0.5800  [3512 LC  139.1 fps]  conv( 6ch 4b      +p)  →  conv( 8ch 4b w8 d1+p)
 227     0.7507  0.7800  [3514 LC  450.2 fps]  conv( 2ch 2b w4   +p)  →  conv( 6ch 3b w8 d1+p)  →  conv(10ch 3b w8 d1+p)
 228     0.7376  0.6300  [3514 LC  123.4 fps]  conv( 6ch 3b w4   +p)  →  conv( 9ch 5b w8 d1+p)
 229     0.7616  0.6500  [3525 LC  665.5 fps]  conv( 2ch 3b w4   +p)  →  conv( 4ch 3b w8 d1+p)  →  conv(10ch 4b w8 d1+p)
 230     0.7125  0.6700  [3525 LC  805.6 fps]  conv( 2ch 3b w4   +p)  →  conv( 4ch 4b w8 d1+p)  →  conv( 8ch 4b w8 d1+p)
 231     0.6454  0.7700  [3528 LC  765.3 fps]  conv( 2ch 2b w4   +p)  →  conv( 4ch 4b w8 d1+p)  →  conv( 9ch 4b w8 d1+p)
 232     0.6996  0.6000  [3531 LC  765.3 fps]  conv( 2ch 2b w4   +p)  →  conv( 4ch 3b w8 d1+p)  →  conv( 9ch 5b w8 d1+p)
 233     0.7237  0.3900  [3536 LC  493.7 fps]  conv( 2ch 3b w4   +p)  →  conv( 6ch 3b w8 d1+p)  →  conv( 9ch 3b w8 d1+p)
 234     0.7018  0.5400  [3545 LC  137.9 fps]  conv( 4ch 3b w4   +p)  →  conv(12ch 5b w8 d1+p)
 235    aborted          [3550 LC   69.9 fps]  conv( 8ch 2b w4   +p)  →  conv(12ch 4b w8 d1+p)
 236    aborted          [3553 LC  225.1 fps]  conv( 2ch 2b w4   +p)  →  conv(10ch 2b w8 d1+p)  →  conv(12ch 2b w8 d1+p)
 237     0.6871  0.6800  [3556 LC  527.8 fps]  conv( 2ch 2b w4   +p)  →  conv( 6ch 3b w8 d1+p)  →  conv( 8ch 4b w8 d1+p)
 238    aborted          [3556 LC  184.4 fps]  conv( 4ch 2b w4   +p)  →  conv( 9ch 2b w8 d1+p)  →  conv(10ch 2b w8 d1+p)
 239     0.6232  0.6500  [3558 LC  300.1 fps]  conv( 2ch 2b w4   +p)  →  conv( 9ch 2b w8 d1+p)  →  conv(10ch 3b w8 d1+p)
 240    aborted          [3558 LC  206.8 fps]  conv( 4ch 2b w4   +p)  →  conv( 8ch 2b w8 d1+p)  →  conv(12ch 2b w8 d1+p)
 241     0.5469  0.6500  [3561 LC  493.7 fps]  conv( 2ch 2b w4   +p)  →  conv( 6ch 2b w8 d1+p)  →  conv( 9ch 5b w8 d1+p)
 242     0.5132  0.4800  [3564 LC  805.6 fps]  conv( 2ch 4b      +p)  →  conv( 4ch 4b w8 d1+p)  →  conv( 6ch 5b w8 d1+p)
 243    aborted          [3567 LC  805.6 fps]  conv( 2ch 2b w4   +p)  →  conv( 4ch 2b w8 d1+p)  →  conv( 6ch 2b w8 d1+p)  →  conv(10ch 2b w8 d1+p)
 244     0.6157  0.6400  [3569 LC  805.6 fps]  conv( 2ch 2b w4   +p)  →  conv( 4ch 5b w8 d1+p)  →  conv( 6ch 5b w8 d1+p)
 245     0.4929  0.4500  [3575 LC   83.6 fps]  conv( 8ch 2b w4   +p)  →  conv(10ch 5b w8 d1+p)
 246     0.6021  0.6100  [3583 LC   92.8 fps]  conv( 6ch 2b w4   +p)  →  conv(12ch 5b w8 d1+p)
 247     0.6260  0.6200  [3586 LC  373.3 fps]  conv( 2ch 2b w4   +p)  →  conv( 8ch 2b w8 d1+p)  →  conv( 9ch 4b w8 d1+p)
 248     0.5204  0.5500  [3586 LC  184.4 fps]  conv( 4ch 5b w4   +p)  →  conv( 9ch 5b w8 d1+p)
 249     0.5259  0.5900  [3591 LC  273.3 fps]  conv( 4ch 2b w4   +p)  →  conv( 6ch 2b w8 d1+p)  →  conv( 9ch 4b w8 d1+p)
 250     0.7032  0.6600  [3594 LC  273.3 fps]  conv( 4ch 2b w4   +p)  →  conv( 6ch 3b w8 d1+p)  →  conv( 8ch 3b w8 d1+p)
 251     0.6892  0.7200  [3599 LC  283.4 fps]  conv( 2ch 2b w4   +p)  →  conv( 8ch 2b w8 d1+p)  →  conv(12ch 3b w8 d1+p)
 252     0.6555  0.7300  [3602 LC  206.8 fps]  conv( 4ch 2b w4   +p)  →  conv( 8ch 2b w8 d1+p)  →  conv( 9ch 3b w8 d1+p)
 253     0.6943  0.7600  [3605 LC  273.3 fps]  conv( 4ch 2b w4   +p)  →  conv( 6ch 2b w8 d1+p)  →  conv(12ch 3b w8 d1+p)
 254     0.5749  0.5600  [3613 LC  805.6 fps]  conv( 2ch 2b w4   +p)  →  conv( 4ch 4b w8 d1+p)  →  conv( 8ch 5b w8 d1+p)
 255     0.7749  0.5800  [3616 LC  450.2 fps]  conv( 2ch 3b w4   +p)  →  conv( 6ch 3b w8 d1+p)  →  conv(10ch 3b w8 d1+p)
 256     0.6701  0.6600  [3616 LC   92.8 fps]  conv( 6ch 3b w4   +p)  →  conv(12ch 4b w8 d1+p)
 257     0.5890  0.6000  [3616 LC  123.4 fps]  conv( 6ch 4b      +p)  →  conv( 9ch 4b w8 d1+p)
 258    aborted          [3621 LC  139.1 fps]  conv( 6ch 2b w4   +p)  →  conv( 8ch 2b w8 d1+p)  →  conv( 9ch 2b w8 d1+p)
 259     0.6818  0.5700  [3630 LC  765.3 fps]  conv( 2ch 3b w4   +p)  →  conv( 4ch 4b w8 d1+p)  →  conv( 9ch 4b w8 d1+p)
 260     0.6972  0.5900  [3630 LC  805.6 fps]  conv( 2ch 4b      +p)  →  conv( 4ch 4b w8 d1+p)  →  conv( 8ch 4b w8 d1+p)
 261     0.6984  0.6500  [3632 LC  566.9 fps]  conv( 2ch 2b w4   +p)  →  conv( 4ch 3b w8 d1+p)  →  conv(12ch 4b w8 d1+p)
 262     0.7484  0.7500  [3632 LC  665.5 fps]  conv( 2ch 2b w4   +p)  →  conv( 4ch 4b w8 d1+p)  →  conv(10ch 4b w8 d1+p)
 263     0.6208  0.5200  [3632 LC  765.3 fps]  conv( 2ch 3b w4   +p)  →  conv( 4ch 3b w8 d1+p)  →  conv( 9ch 5b w8 d1+p)
 264     0.6362  0.6600  [3641 LC  110.9 fps]  conv( 6ch 3b w4   +p)  →  conv(10ch 5b w8 d1+p)
 265     0.4140  0.4700  [3649 LC  805.6 fps]  conv( 2ch 2b w4   +p)  →  conv( 4ch 2b w8 d1+p)  →  conv( 6ch 2b w8 d1+p)  →  conv( 8ch 3b w8 d1+p)
 266     0.7126  0.6600  [3652 LC   93.3 fps]  conv( 8ch 3b w4   +p)  →  conv( 9ch 4b w8 d1+p)
 267     0.6835  0.7000  [3657 LC  665.5 fps]  conv( 2ch 2b w4   +p)  →  conv( 4ch 3b w8 d1+p)  →  conv(10ch 5b w8 d1+p)
 268     0.6827  0.6300  [3657 LC  527.8 fps]  conv( 2ch 3b w4   +p)  →  conv( 6ch 3b w8 d1+p)  →  conv( 8ch 4b w8 d1+p)
 269     0.6529  0.6000  [3660 LC  493.7 fps]  conv( 2ch 2b w4   +p)  →  conv( 6ch 3b w8 d1+p)  →  conv( 9ch 4b w8 d1+p)
 270     0.6619  0.7100  [3663 LC  373.3 fps]  conv( 2ch 2b w4   +p)  →  conv( 6ch 2b w8 d1+p)  →  conv(12ch 4b w8 d1+p)
 271     0.7264  0.6100  [3665 LC   69.9 fps]  conv( 8ch 3b w4   +p)  →  conv(12ch 3b w8 d1+p)
 272     0.6479  0.5800  [3671 LC  805.6 fps]  conv( 2ch 3b w4   +p)  →  conv( 4ch 5b w8 d1+p)  →  conv( 6ch 5b w8 d1+p)
 273     0.6598  0.7300  [3671 LC   62.2 fps]  conv( 9ch 2b w4   +p)  →  conv(12ch 4b w8 d1+p)
 274     0.7462  0.6500  [3673 LC  373.3 fps]  conv( 2ch 2b w4   +p)  →  conv( 6ch 3b w8 d1+p)  →  conv(12ch 3b w8 d1+p)
 275     0.5723  0.5700  [3676 LC  273.3 fps]  conv( 4ch 2b w4   +p)  →  conv( 6ch 2b w8 d1+p)  →  conv( 8ch 5b w8 d1+p)
 276     0.7260  0.7700  [3676 LC  273.3 fps]  conv( 4ch 2b w4   +p)  →  conv( 6ch 3b w8 d1+p)  →  conv( 9ch 3b w8 d1+p)
 277    aborted          [3676 LC  184.4 fps]  conv( 4ch 2b w4   +p)  →  conv( 9ch 2b w8 d1+p)  →  conv(12ch 2b w8 d1+p)
 278     0.6112  0.4800  [3679 LC   74.7 fps]  conv( 9ch 3b w4   +p)  →  conv(10ch 3b w8 d1+p)
 279     0.6736  0.6800  [3682 LC  206.8 fps]  conv( 4ch 2b w4   +p)  →  conv( 8ch 2b w8 d1+p)  →  conv(10ch 3b w8 d1+p)
 280    aborted          [3682 LC  139.1 fps]  conv( 6ch 2b w4   +p)  →  conv( 8ch 2b w8 d1+p)  →  conv(10ch 2b w8 d1+p)
 281    aborted          [3687 LC  805.6 fps]  conv( 2ch 2b w4   +p)  →  conv( 4ch 2b w8 d1+p)  →  conv( 6ch 2b w8 d1+p)  →  conv(12ch 2b w8 d1+p)
 282     0.6104  0.7000  [3687 LC  450.2 fps]  conv( 2ch 2b w4   +p)  →  conv( 6ch 2b w8 d1+p)  →  conv(10ch 5b w8 d1+p)
 283     0.6887  0.7000  [3690 LC  340.1 fps]  conv( 2ch 2b w4   +p)  →  conv( 8ch 2b w8 d1+p)  →  conv(10ch 4b w8 d1+p)
 284     0.7227  0.7700  [3695 LC  273.3 fps]  conv( 4ch 2b w4   +p)  →  conv( 6ch 2b w8 d1+p)  →  conv(10ch 4b w8 d1+p)
 285     0.5472  0.5500  [3695 LC   74.7 fps]  conv( 9ch 2b w4   +p)  →  conv(10ch 5b w8 d1+p)
 286     0.6439  0.7500  [3701 LC  139.1 fps]  conv( 6ch 4b      +p)  →  conv( 8ch 5b w8 d1+p)
 287     0.5478  0.5600  [3704 LC  566.9 fps]  conv( 2ch 2b w4   +p)  →  conv( 4ch 2b w8 d1+p)  →  conv(12ch 5b w8 d1+p)
 288     0.6114  0.1400  [3712 LC  164.6 fps]  conv( 4ch 5b w4   +p)  →  conv(10ch 5b w8 d1+p)
 289     0.5140  0.3700  [3715 LC  805.6 fps]  conv( 2ch 3b w4   +p)  →  conv( 4ch 4b w8 d1+p)  →  conv( 8ch 5b w8 d1+p)
 290     0.6434  0.6800  [3717 LC  250.9 fps]  conv( 2ch 2b w4   +p)  →  conv( 9ch 2b w8 d1+p)  →  conv(12ch 3b w8 d1+p)
 291     0.6028  0.6800  [3720 LC  110.9 fps]  conv( 6ch 4b      +p)  →  conv(10ch 4b w8 d1+p)
 292     0.5104  0.5500  [3731 LC  805.6 fps]  conv( 2ch 2b w4   +p)  →  conv( 4ch 2b w8 d1+p)  →  conv( 6ch 2b w8 d1+p)  →  conv( 9ch 3b w8 d1+p)
 293     0.7573  0.7500  [3734 LC  566.9 fps]  conv( 2ch 3b w4   +p)  →  conv( 4ch 3b w8 d1+p)  →  conv(12ch 4b w8 d1+p)
 294     0.7228  0.6600  [3734 LC  665.5 fps]  conv( 2ch 3b w4   +p)  →  conv( 4ch 4b w8 d1+p)  →  conv(10ch 4b w8 d1+p)
 295    aborted          [3734 LC  765.3 fps]  conv( 2ch 4b      +p)  →  conv( 4ch 4b w8 d1+p)  →  conv( 9ch 4b w8 d1+p)
 296     0.6794  0.7700  [3739 LC  765.3 fps]  conv( 2ch 2b w4   +p)  →  conv( 4ch 4b w8 d1+p)  →  conv( 9ch 5b w8 d1+p)
 297     0.4240  0.4100  [3742 LC  805.6 fps]  conv( 2ch 2b w4   +p)  →  conv( 4ch 2b w8 d1+p)  →  conv( 8ch 2b w8 d1+p)  →  conv( 9ch 2b w8 d1+p)
 298     0.7170  0.6800  [3745 LC  527.8 fps]  conv( 2ch 2b w4   +p)  →  conv( 6ch 3b w8 d1+p)  →  conv( 8ch 5b w8 d1+p)
 299     0.6261  0.6100  [3753 LC  137.9 fps]  conv( 4ch 4b      +p)  →  conv(12ch 5b w8 d1+p)
 300     0.8076  0.8100  [3756 LC  273.3 fps]  conv( 4ch 2b w4   +p)  →  conv( 6ch 3b w8 d1+p)  →  conv(10ch 3b w8 d1+p)
 301     0.6414  0.4500  [3756 LC   83.6 fps]  conv( 8ch 3b w4   +p)  →  conv(10ch 4b w8 d1+p)
 302     0.7516  0.6000  [3758 LC  665.5 fps]  conv( 2ch 3b w4   +p)  →  conv( 4ch 3b w8 d1+p)  →  conv(10ch 5b w8 d1+p)
 303     0.7425  0.4500  [3761 LC  493.7 fps]  conv( 2ch 3b w4   +p)  →  conv( 6ch 3b w8 d1+p)  →  conv( 9ch 4b w8 d1+p)
 304     0.5526  0.5200  [3764 LC  450.2 fps]  conv( 2ch 2b w4   +p)  →  conv( 6ch 3b w8 d1+p)  →  conv(10ch 4b w8 d1+p)
 305     0.7400  0.7600  [3775 LC  373.3 fps]  conv( 2ch 2b w4   +p)  →  conv( 8ch 3b w8 d1+p)  →  conv( 9ch 3b w8 d1+p)
 306     0.8282  0.7400  [3775 LC  373.3 fps]  conv( 2ch 3b w4   +p)  →  conv( 6ch 3b w8 d1+p)  →  conv(12ch 3b w8 d1+p)
 307     0.5944  0.6500  [3775 LC  805.6 fps]  conv( 2ch 4b      +p)  →  conv( 4ch 5b w8 d1+p)  →  conv( 6ch 5b w8 d1+p)
 308     0.6155  0.6200  [3791 LC   56.1 fps]  conv(10ch 2b w4   +p)  →  conv(12ch 4b w8 d1+p)
 309    aborted          [3794 LC  164.6 fps]  conv( 4ch 2b w4   +p)  →  conv(10ch 2b w8 d1+p)  →  conv(12ch 2b w8 d1+p)
 310     0.6647  0.7200  [3797 LC  373.3 fps]  conv( 2ch 2b w4   +p)  →  conv( 8ch 2b w8 d1+p)  →  conv( 9ch 5b w8 d1+p)
 311     0.7063  0.6400  [3797 LC  273.3 fps]  conv( 4ch 2b w4   +p)  →  conv( 6ch 3b w8 d1+p)  →  conv( 8ch 4b w8 d1+p)
 312     0.6952  0.7500  [3800 LC  184.4 fps]  conv( 4ch 2b w4   +p)  →  conv( 9ch 2b w8 d1+p)  →  conv(10ch 3b w8 d1+p)
 313     0.7390  0.6000  [3800 LC  273.3 fps]  conv( 4ch 3b w4   +p)  →  conv( 6ch 3b w8 d1+p)  →  conv( 8ch 3b w8 d1+p)
 314    aborted          [3800 LC  123.4 fps]  conv( 6ch 2b w4   +p)  →  conv( 9ch 2b w8 d1+p)  →  conv(10ch 2b w8 d1+p)
 315    aborted          [3802 LC  805.6 fps]  conv( 2ch 2b w4   +p)  →  conv( 4ch 2b w8 d1+p)  →  conv( 8ch 2b w8 d1+p)  →  conv(10ch 2b w8 d1+p)
 316     0.5339  0.5400  [3802 LC  273.3 fps]  conv( 4ch 2b w4   +p)  →  conv( 6ch 2b w8 d1+p)  →  conv( 9ch 5b w8 d1+p)
 317    aborted          [3802 LC  139.1 fps]  conv( 6ch 2b w4   +p)  →  conv( 8ch 2b w8 d1+p)  →  conv(12ch 2b w8 d1+p)
 318     0.6846  0.6700  [3808 LC  300.1 fps]  conv( 2ch 2b w4   +p)  →  conv( 9ch 2b w8 d1+p)  →  conv(10ch 4b w8 d1+p)
 319     0.5095  0.4700  [3811 LC  805.6 fps]  conv( 2ch 2b w4   +p)  →  conv( 4ch 2b w8 d1+p)  →  conv( 6ch 2b w8 d1+p)  →  conv(10ch 3b w8 d1+p)
 320     0.6912  0.6800  [3819 LC  805.6 fps]  conv( 2ch 4b      +p)  →  conv( 4ch 4b w8 d1+p)  →  conv( 8ch 5b w8 d1+p)
 321     0.6411  0.6500  [3824 LC  805.6 fps]  conv( 2ch 2b w4   +p)  →  conv( 4ch 5b w8 d1+p)  →  conv( 8ch 5b w8 d1+p)
 322     0.6059  0.7400  [3827 LC  206.8 fps]  conv( 4ch 2b w4   +p)  →  conv( 8ch 2b w8 d1+p)  →  conv( 9ch 4b w8 d1+p)
 323     0.6505  0.7200  [3827 LC  123.4 fps]  conv( 6ch 4b      +p)  →  conv( 9ch 5b w8 d1+p)
 324     0.6527  0.7200  [3827 LC   69.9 fps]  conv( 8ch 2b w4   +p)  →  conv(12ch 5b w8 d1+p)
 325     0.7241  0.7500  [3835 LC  225.1 fps]  conv( 2ch 2b w4   +p)  →  conv(10ch 2b w8 d1+p)  →  conv(12ch 3b w8 d1+p)
 326     0.7191  0.7300  [3838 LC  665.5 fps]  conv( 2ch 4b      +p)  →  conv( 4ch 4b w8 d1+p)  →  conv(10ch 4b w8 d1+p)
 327     0.6666  0.5400  [3838 LC   62.2 fps]  conv( 9ch 3b w4   +p)  →  conv(12ch 3b w8 d1+p)
 328     0.7347  0.7900  [3841 LC  566.9 fps]  conv( 2ch 2b w4   +p)  →  conv( 4ch 4b w8 d1+p)  →  conv(12ch 4b w8 d1+p)
 329     0.7288  0.7200  [3841 LC  765.3 fps]  conv( 2ch 3b w4   +p)  →  conv( 4ch 4b w8 d1+p)  →  conv( 9ch 5b w8 d1+p)
 330     0.6653  0.6900  [3841 LC  206.8 fps]  conv( 4ch 2b w4   +p)  →  conv( 8ch 2b w8 d1+p)  →  conv(12ch 3b w8 d1+p)
 331     0.7713  0.6800  [3846 LC  527.8 fps]  conv( 2ch 3b w4   +p)  →  conv( 6ch 3b w8 d1+p)  →  conv( 8ch 5b w8 d1+p)
 332     0.6073  0.6300  [3846 LC  139.1 fps]  conv( 6ch 2b w4   +p)  →  conv( 8ch 2b w8 d1+p)  →  conv( 9ch 3b w8 d1+p)
 333     0.4869  0.5300  [3852 LC  805.6 fps]  conv( 2ch 2b w4   +p)  →  conv( 4ch 2b w8 d1+p)  →  conv( 6ch 2b w8 d1+p)  →  conv( 8ch 4b w8 d1+p)
 334     0.7659  0.7100  [3854 LC  340.1 fps]  conv( 2ch 2b w4   +p)  →  conv( 8ch 3b w8 d1+p)  →  conv(10ch 3b w8 d1+p)
 335     0.6727  0.6100  [3863 LC   93.3 fps]  conv( 8ch 3b w4   +p)  →  conv( 9ch 5b w8 d1+p)
 336     0.6647  0.6600  [3865 LC  665.5 fps]  conv( 2ch 2b w4   +p)  →  conv( 4ch 4b w8 d1+p)  →  conv(10ch 5b w8 d1+p)
 337     0.7896  0.7600  [3865 LC  450.2 fps]  conv( 2ch 3b w4   +p)  →  conv( 6ch 3b w8 d1+p)  →  conv(10ch 4b w8 d1+p)
 338     0.6792  0.7300  [3868 LC  527.8 fps]  conv( 2ch 2b w4   +p)  →  conv( 6ch 4b w8 d1+p)  →  conv( 8ch 4b w8 d1+p)
 339     0.6807  0.6900  [3871 LC  493.7 fps]  conv( 2ch 2b w4   +p)  →  conv( 6ch 3b w8 d1+p)  →  conv( 9ch 5b w8 d1+p)
 340     0.6987  0.5700  [3876 LC  373.3 fps]  conv( 2ch 3b w4   +p)  →  conv( 8ch 3b w8 d1+p)  →  conv( 9ch 3b w8 d1+p)
 341     0.6186  0.6300  [3882 LC  805.6 fps]  conv( 2ch 5b w4   +p)  →  conv( 4ch 5b w8 d1+p)  →  conv( 6ch 5b w8 d1+p)
 342     0.7906  0.6200  [3882 LC  273.3 fps]  conv( 4ch 3b w4   +p)  →  conv( 6ch 3b w8 d1+p)  →  conv( 9ch 3b w8 d1+p)
 343     0.6422  0.5900  [3893 LC   92.8 fps]  conv( 6ch 3b w4   +p)  →  conv(12ch 5b w8 d1+p)
 344     0.7022  0.7100  [3898 LC  283.4 fps]  conv( 2ch 2b w4   +p)  →  conv( 8ch 2b w8 d1+p)  →  conv(12ch 4b w8 d1+p)
 345     0.7127  0.6700  [3901 LC  273.3 fps]  conv( 4ch 2b w4   +p)  →  conv( 6ch 3b w8 d1+p)  →  conv( 9ch 4b w8 d1+p)
 346     0.5123  0.5600  [3904 LC  273.3 fps]  conv( 4ch 2b w4   +p)  →  conv( 6ch 2b w8 d1+p)  →  conv(12ch 4b w8 d1+p)
 347    aborted          [3909 LC  566.9 fps]  conv( 2ch 2b w4   +p)  →  conv( 4ch 3b w8 d1+p)  →  conv(12ch 5b w8 d1+p)
 348     0.8215  0.8800  [3915 LC  273.3 fps]  conv( 4ch 2b w4   +p)  →  conv( 6ch 3b w8 d1+p)  →  conv(12ch 3b w8 d1+p)
 349     0.4327  0.4700  [3920 LC  765.3 fps]  conv( 2ch 2b w4   +p)  →  conv( 4ch 2b w8 d1+p)  →  conv( 9ch 2b w8 d1+p)  →  conv(10ch 2b w8 d1+p)
 350    aborted          [3920 LC  123.4 fps]  conv( 6ch 2b w4   +p)  →  conv( 9ch 2b w8 d1+p)  →  conv(12ch 2b w8 d1+p)
 351     0.5129  0.3800  [3923 LC  805.6 fps]  conv( 2ch 2b w4   +p)  →  conv( 4ch 2b w8 d1+p)  →  conv( 8ch 2b w8 d1+p)  →  conv(12ch 2b w8 d1+p)
 352     0.6145  0.5900  [3923 LC  340.1 fps]  conv( 2ch 2b w4   +p)  →  conv( 8ch 2b w8 d1+p)  →  conv(10ch 5b w8 d1+p)
 353    aborted          [3926 LC  805.6 fps]  conv( 2ch 3b w4   +p)  →  conv( 4ch 5b w8 d1+p)  →  conv( 8ch 5b w8 d1+p)
 354     0.6569  0.6400  [3926 LC  139.1 fps]  conv( 6ch 2b w4   +p)  →  conv( 8ch 2b w8 d1+p)  →  conv(10ch 3b w8 d1+p)
 355     0.5850  0.6700  [3929 LC  273.3 fps]  conv( 4ch 2b w4   +p)  →  conv( 6ch 2b w8 d1+p)  →  conv(10ch 5b w8 d1+p)
 356     0.6763  0.6900  [3929 LC   92.8 fps]  conv( 6ch 4b      +p)  →  conv(12ch 4b w8 d1+p)
 357     0.7096  0.5500  [3929 LC   74.7 fps]  conv( 9ch 3b w4   +p)  →  conv(10ch 4b w8 d1+p)
 358     0.6551  0.6600  [3931 LC  206.8 fps]  conv( 4ch 2b w4   +p)  →  conv( 8ch 2b w8 d1+p)  →  conv(10ch 4b w8 d1+p)
 359     0.6910  0.6900  [3939 LC  373.3 fps]  conv( 2ch 2b w4   +p)  →  conv( 6ch 2b w8 d1+p)  →  conv(12ch 5b w8 d1+p)
 360     0.7683  0.7200  [3942 LC  566.9 fps]  conv( 2ch 3b w4   +p)  →  conv( 4ch 4b w8 d1+p)  →  conv(12ch 4b w8 d1+p)
 361     0.6823  0.6900  [3945 LC  765.3 fps]  conv( 2ch 4b      +p)  →  conv( 4ch 4b w8 d1+p)  →  conv( 9ch 5b w8 d1+p)
 362     0.6134  0.6900  [3948 LC   62.2 fps]  conv( 9ch 2b w4   +p)  →  conv(12ch 5b w8 d1+p)
 363     0.6647  0.7000  [3950 LC  765.3 fps]  conv( 2ch 2b w4   +p)  →  conv( 4ch 5b w8 d1+p)  →  conv( 9ch 5b w8 d1+p)
 364     0.6750  0.6100  [3953 LC  110.9 fps]  conv( 6ch 4b      +p)  →  conv(10ch 5b w8 d1+p)
 365     0.5099  0.5200  [3956 LC  805.6 fps]  conv( 2ch 2b w4   +p)  →  conv( 4ch 2b w8 d1+p)  →  conv( 6ch 2b w8 d1+p)  →  conv( 9ch 4b w8 d1+p)
 366     0.7904  0.7900  [3956 LC  340.1 fps]  conv( 2ch 3b w4   +p)  →  conv( 8ch 3b w8 d1+p)  →  conv(10ch 3b w8 d1+p)
 367    aborted          [3959 LC  805.6 fps]  conv( 2ch 2b w4   +p)  →  conv( 4ch 2b w8 d1+p)  →  conv( 6ch 3b w8 d1+p)  →  conv( 8ch 3b w8 d1+p)
 368     0.7197  0.8200  [3959 LC  184.4 fps]  conv( 4ch 2b w4   +p)  →  conv( 9ch 2b w8 d1+p)  →  conv(12ch 3b w8 d1+p)
 369     0.7740  0.5800  [3961 LC  273.3 fps]  conv( 4ch 3b w4   +p)  →  conv( 6ch 3b w8 d1+p)  →  conv(10ch 3b w8 d1+p)
 370     0.6235  0.6500  [3964 LC  137.9 fps]  conv( 4ch 5b w4   +p)  →  conv(12ch 5b w8 d1+p)
 371     0.7285  0.6200  [3964 LC   69.9 fps]  conv( 8ch 3b w4   +p)  →  conv(12ch 4b w8 d1+p)
 372     0.6218  0.6000  [3967 LC  805.6 fps]  conv( 2ch 2b w4   +p)  →  conv( 4ch 2b w8 d1+p)  →  conv( 8ch 2b w8 d1+p)  →  conv( 9ch 3b w8 d1+p)
 373     0.7646  0.6100  [3967 LC  665.5 fps]  conv( 2ch 3b w4   +p)  →  conv( 4ch 4b w8 d1+p)  →  conv(10ch 5b w8 d1+p)
 374     0.4842  0.5700  [3970 LC  805.6 fps]  conv( 2ch 2b w4   +p)  →  conv( 4ch 2b w8 d1+p)  →  conv( 6ch 2b w8 d1+p)  →  conv(12ch 3b w8 d1+p)
 375     0.7156  0.7700  [3970 LC  527.8 fps]  conv( 2ch 3b w4   +p)  →  conv( 6ch 4b w8 d1+p)  →  conv( 8ch 4b w8 d1+p)
 376     0.7587  0.8000  [3972 LC  373.3 fps]  conv( 2ch 2b w4   +p)  →  conv( 6ch 3b w8 d1+p)  →  conv(12ch 4b w8 d1+p)
 377     0.7707  0.7200  [3972 LC  493.7 fps]  conv( 2ch 2b w4   +p)  →  conv( 6ch 4b w8 d1+p)  →  conv( 9ch 4b w8 d1+p)
 378     0.7818  0.7000  [3972 LC  493.7 fps]  conv( 2ch 3b w4   +p)  →  conv( 6ch 3b w8 d1+p)  →  conv( 9ch 5b w8 d1+p)
 379    aborted          [3978 LC  527.8 fps]  conv( 2ch 2b w4   +p)  →  conv( 6ch 2b w8 d1+p)  →  conv( 8ch 2b w8 d1+p)  →  conv( 9ch 2b w8 d1+p)
 380     0.7128  0.7800  [3986 LC  273.3 fps]  conv( 4ch 2b w4   +p)  →  conv( 6ch 3b w8 d1+p)  →  conv( 8ch 5b w8 d1+p)
 381     0.6800  0.5300  [3989 LC   83.6 fps]  conv( 8ch 3b w4   +p)  →  conv(10ch 5b w8 d1+p)
 382     0.8168  0.8000  [3997 LC  450.2 fps]  conv( 2ch 2b w4   +p)  →  conv( 6ch 3b w8 d1+p)  →  conv(10ch 5b w8 d1+p)
 383    aborted          [4000 LC  373.3 fps]  conv( 2ch 2b w4   +p)  →  conv( 8ch 3b w8 d1+p)  →  conv( 9ch 4b w8 d1+p)
 384     0.7384  0.5500  [4003 LC  273.3 fps]  conv( 4ch 3b w4   +p)  →  conv( 6ch 3b w8 d1+p)  →  conv( 8ch 4b w8 d1+p)
 385     0.7669  0.8000  [4005 LC  273.3 fps]  conv( 4ch 2b w4   +p)  →  conv( 6ch 3b w8 d1+p)  →  conv(10ch 4b w8 d1+p)
 386     0.8196  0.7400  [4011 LC  566.9 fps]  conv( 2ch 3b w4   +p)  →  conv( 4ch 3b w8 d1+p)  →  conv(12ch 5b w8 d1+p)
 387     0.7692  0.6600  [4011 LC   56.1 fps]  conv(10ch 3b w4   +p)  →  conv(12ch 3b w8 d1+p)
 388     0.7681  0.7000  [4014 LC  283.4 fps]  conv( 2ch 2b w4   +p)  →  conv( 8ch 3b w8 d1+p)  →  conv(12ch 3b w8 d1+p)
 389     0.7195  0.7500  [4016 LC  250.9 fps]  conv( 2ch 2b w4   +p)  →  conv( 9ch 2b w8 d1+p)  →  conv(12ch 4b w8 d1+p)
 390     0.7549  0.6900  [4016 LC  206.8 fps]  conv( 4ch 2b w4   +p)  →  conv( 8ch 3b w8 d1+p)  →  conv( 9ch 3b w8 d1+p)
 391     0.5764  0.1400  [4016 LC  139.1 fps]  conv( 6ch 5b w4   +p)  →  conv( 8ch 5b w8 d1+p)
 392     0.6874  0.7000  [4024 LC  300.1 fps]  conv( 2ch 2b w4   +p)  →  conv( 9ch 3b w8 d1+p)  →  conv(10ch 3b w8 d1+p)
 393     0.7663  0.8400  [4030 LC  805.6 fps]  conv( 2ch 4b      +p)  →  conv( 4ch 5b w8 d1+p)  →  conv( 8ch 5b w8 d1+p)
 394    aborted          [4038 LC  527.8 fps]  conv( 2ch 2b w4   +p)  →  conv( 6ch 2b w8 d1+p)  →  conv( 8ch 2b w8 d1+p)  →  conv(10ch 2b w8 d1+p)
 395     0.6574  0.6600  [4038 LC  206.8 fps]  conv( 4ch 2b w4   +p)  →  conv( 8ch 2b w8 d1+p)  →  conv( 9ch 5b w8 d1+p)
 396    aborted          [4038 LC  110.9 fps]  conv( 6ch 2b w4   +p)  →  conv(10ch 2b w8 d1+p)  →  conv(12ch 2b w8 d1+p)
 397     0.5169  0.6000  [4041 LC  805.6 fps]  conv( 2ch 2b w4   +p)  →  conv( 4ch 2b w8 d1+p)  →  conv( 6ch 2b w8 d1+p)  →  conv( 8ch 5b w8 d1+p)
 398     0.6705  0.7100  [4041 LC  805.6 fps]  conv( 2ch 2b w4   +p)  →  conv( 4ch 2b w8 d1+p)  →  conv( 6ch 3b w8 d1+p)  →  conv( 9ch 3b w8 d1+p)
 399     0.4659  0.4000  [4041 LC  765.3 fps]  conv( 2ch 2b w4   +p)  →  conv( 4ch 2b w8 d1+p)  →  conv( 9ch 2b w8 d1+p)  →  conv(12ch 2b w8 d1+p)
 400     0.6721  0.6100  [4041 LC  300.1 fps]  conv( 2ch 2b w4   +p)  →  conv( 9ch 2b w8 d1+p)  →  conv(10ch 5b w8 d1+p)
 401     0.6796  0.6900  [4044 LC  123.4 fps]  conv( 6ch 2b w4   +p)  →  conv( 9ch 2b w8 d1+p)  →  conv(10ch 3b w8 d1+p)
 402    aborted          [4044 LC   93.3 fps]  conv( 8ch 2b w4   +p)  →  conv( 9ch 2b w8 d1+p)  →  conv(10ch 2b w8 d1+p)
 403     0.6076  0.6700  [4046 LC  805.6 fps]  conv( 2ch 2b w4   +p)  →  conv( 4ch 2b w8 d1+p)  →  conv( 8ch 2b w8 d1+p)  →  conv(10ch 3b w8 d1+p)
 404     0.7873  0.6600  [4046 LC  566.9 fps]  conv( 2ch 4b      +p)  →  conv( 4ch 4b w8 d1+p)  →  conv(12ch 4b w8 d1+p)
 405     0.6133  0.6200  [4049 LC  184.4 fps]  conv( 4ch 2b w4   +p)  →  conv( 9ch 2b w8 d1+p)  →  conv(10ch 4b w8 d1+p)
 406     0.7359  0.6900  [4052 LC  765.3 fps]  conv( 2ch 3b w4   +p)  →  conv( 4ch 5b w8 d1+p)  →  conv( 9ch 5b w8 d1+p)
 407     0.7420  0.7000  [4057 LC  527.8 fps]  conv( 2ch 2b w4   +p)  →  conv( 6ch 4b w8 d1+p)  →  conv( 8ch 5b w8 d1+p)
 408     0.5323  0.6200  [4060 LC  805.6 fps]  conv( 2ch 2b w4   +p)  →  conv( 4ch 2b w8 d1+p)  →  conv( 6ch 2b w8 d1+p)  →  conv(10ch 4b w8 d1+p)
 409     0.6285  0.6000  [4068 LC   93.3 fps]  conv( 8ch 4b      +p)  →  conv( 9ch 4b w8 d1+p)
 410     0.6281  0.6900  [4068 LC   56.1 fps]  conv(10ch 2b w4   +p)  →  conv(12ch 5b w8 d1+p)
 411     0.7410  0.7500  [4071 LC  665.5 fps]  conv( 2ch 4b      +p)  →  conv( 4ch 4b w8 d1+p)  →  conv(10ch 5b w8 d1+p)
 412     0.6329  0.6000  [4071 LC  139.1 fps]  conv( 6ch 2b w4   +p)  →  conv( 8ch 2b w8 d1+p)  →  conv( 9ch 4b w8 d1+p)
 413     0.8319  0.6900  [4074 LC  373.3 fps]  conv( 2ch 3b w4   +p)  →  conv( 6ch 3b w8 d1+p)  →  conv(12ch 4b w8 d1+p)
 414     0.7731  0.7000  [4074 LC  493.7 fps]  conv( 2ch 3b w4   +p)  →  conv( 6ch 4b w8 d1+p)  →  conv( 9ch 4b w8 d1+p)
 415     0.6737  0.6500  [4074 LC  527.8 fps]  conv( 2ch 4b      +p)  →  conv( 6ch 4b w8 d1+p)  →  conv( 8ch 4b w8 d1+p)
 416     0.6852  0.6700  [4077 LC  665.5 fps]  conv( 2ch 2b w4   +p)  →  conv( 4ch 5b w8 d1+p)  →  conv(10ch 5b w8 d1+p)
 417     0.7868  0.7900  [4077 LC  450.2 fps]  conv( 2ch 2b w4   +p)  →  conv( 6ch 4b w8 d1+p)  →  conv(10ch 4b w8 d1+p)
 418     0.5170  0.4800  [4077 LC  164.6 fps]  conv( 4ch 2b w4   +p)  →  conv(10ch 2b w8 d1+p)  →  conv(12ch 3b w8 d1+p)
 419     0.6760  0.6300  [4085 LC  139.1 fps]  conv( 6ch 2b w4   +p)  →  conv( 8ch 2b w8 d1+p)  →  conv(12ch 3b w8 d1+p)
 420     0.7636  0.6800  [4096 LC  206.8 fps]  conv( 4ch 2b w4   +p)  →  conv( 8ch 3b w8 d1+p)  →  conv(10ch 3b w8 d1+p)
 421     0.7712  0.6600  [4099 LC  450.2 fps]  conv( 2ch 3b w4   +p)  →  conv( 6ch 3b w8 d1+p)  →  conv(10ch 5b w8 d1+p)
 422     0.7018  0.6800  [4101 LC  373.3 fps]  conv( 2ch 3b w4   +p)  →  conv( 8ch 3b w8 d1+p)  →  conv( 9ch 4b w8 d1+p)
 423     0.7703  0.7000  [4104 LC  340.1 fps]  conv( 2ch 2b w4   +p)  →  conv( 8ch 3b w8 d1+p)  →  conv(10ch 4b w8 d1+p)
 424     0.8054  0.6900  [4107 LC  273.3 fps]  conv( 4ch 3b w4   +p)  →  conv( 6ch 3b w8 d1+p)  →  conv( 9ch 4b w8 d1+p)
 425     0.7739  0.7400  [4109 LC  273.3 fps]  conv( 4ch 2b w4   +p)  →  conv( 6ch 4b w8 d1+p)  →  conv( 8ch 4b w8 d1+p)
 426     0.7328  0.7600  [4112 LC  273.3 fps]  conv( 4ch 2b w4   +p)  →  conv( 6ch 3b w8 d1+p)  →  conv( 9ch 5b w8 d1+p)
 427     0.8263  0.6700  [4115 LC  283.4 fps]  conv( 2ch 3b w4   +p)  →  conv( 8ch 3b w8 d1+p)  →  conv(12ch 3b w8 d1+p)
 428     0.6972  0.6600  [4118 LC  566.9 fps]  conv( 2ch 2b w4   +p)  →  conv( 4ch 4b w8 d1+p)  →  conv(12ch 5b w8 d1+p)
 429     0.6358  0.6700  [4120 LC  805.6 fps]  conv( 2ch 2b w4   +p)  →  conv( 4ch 2b w8 d1+p)  →  conv( 6ch 3b w8 d1+p)  →  conv(10ch 3b w8 d1+p)
 430     0.8164  0.6200  [4120 LC  273.3 fps]  conv( 4ch 3b w4   +p)  →  conv( 6ch 3b w8 d1+p)  →  conv(12ch 3b w8 d1+p)
 431     0.6714  0.5200  [4126 LC  300.1 fps]  conv( 2ch 3b w4   +p)  →  conv( 9ch 3b w8 d1+p)  →  conv(10ch 3b w8 d1+p)
 432     0.7014  0.7400  [4134 LC  225.1 fps]  conv( 2ch 2b w4   +p)  →  conv(10ch 2b w8 d1+p)  →  conv(12ch 4b w8 d1+p)
 433     0.7036  0.2600  [4137 LC  805.6 fps]  conv( 2ch 5b w4   +p)  →  conv( 4ch 5b w8 d1+p)  →  conv( 8ch 5b w8 d1+p)
 434     0.7260  0.5200  [4137 LC   62.2 fps]  conv( 9ch 3b w4   +p)  →  conv(12ch 4b w8 d1+p)
 435     0.6147  0.6000  [4140 LC  206.8 fps]  conv( 4ch 2b w4   +p)  →  conv( 8ch 2b w8 d1+p)  →  conv(12ch 4b w8 d1+p)
 436     0.6627  0.2600  [4142 LC  123.4 fps]  conv( 6ch 5b w4   +p)  →  conv( 9ch 5b w8 d1+p)
 437    aborted          [4156 LC  493.7 fps]  conv( 2ch 2b w4   +p)  →  conv( 6ch 2b w8 d1+p)  →  conv( 9ch 2b w8 d1+p)  →  conv(10ch 2b w8 d1+p)
 438     0.7548  0.7300  [4156 LC  765.3 fps]  conv( 2ch 4b      +p)  →  conv( 4ch 5b w8 d1+p)  →  conv( 9ch 5b w8 d1+p)
 439     0.4818  0.3700  [4159 LC  665.5 fps]  conv( 2ch 2b w4   +p)  →  conv( 4ch 2b w8 d1+p)  →  conv(10ch 2b w8 d1+p)  →  conv(12ch 2b w8 d1+p)
 440    aborted          [4159 LC  527.8 fps]  conv( 2ch 2b w4   +p)  →  conv( 6ch 2b w8 d1+p)  →  conv( 8ch 2b w8 d1+p)  →  conv(12ch 2b w8 d1+p)
 441     0.7443  0.6600  [4159 LC  527.8 fps]  conv( 2ch 3b w4   +p)  →  conv( 6ch 4b w8 d1+p)  →  conv( 8ch 5b w8 d1+p)
 442     0.6277  0.6900  [4162 LC  805.6 fps]  conv( 2ch 2b w4   +p)  →  conv( 4ch 2b w8 d1+p)  →  conv( 6ch 3b w8 d1+p)  →  conv( 8ch 4b w8 d1+p)
 443     0.6561  0.6300  [4162 LC   74.7 fps]  conv( 9ch 3b w4   +p)  →  conv(10ch 5b w8 d1+p)
 444     0.5784  0.6400  [4164 LC  765.3 fps]  conv( 2ch 2b w4   +p)  →  conv( 4ch 2b w8 d1+p)  →  conv( 9ch 2b w8 d1+p)  →  conv(10ch 3b w8 d1+p)
 445     0.6787  0.5700  [4164 LC  805.6 fps]  conv( 2ch 2b w4   +p)  →  conv( 4ch 3b w8 d1+p)  →  conv( 6ch 3b w8 d1+p)  →  conv( 8ch 3b w8 d1+p)
 446     0.6521  0.7100  [4164 LC  206.8 fps]  conv( 4ch 2b w4   +p)  →  conv( 8ch 2b w8 d1+p)  →  conv(10ch 5b w8 d1+p)
 447    aborted          [4164 LC   93.3 fps]  conv( 8ch 2b w4   +p)  →  conv( 9ch 2b w8 d1+p)  →  conv(12ch 2b w8 d1+p)
 448     0.5443  0.5000  [4167 LC  805.6 fps]  conv( 2ch 2b w4   +p)  →  conv( 4ch 2b w8 d1+p)  →  conv( 6ch 2b w8 d1+p)  →  conv( 9ch 5b w8 d1+p)
 449     0.6178  0.5700  [4173 LC   83.6 fps]  conv( 8ch 4b      +p)  →  conv(10ch 4b w8 d1+p)
 450     0.6670  0.6900  [4175 LC  283.4 fps]  conv( 2ch 2b w4   +p)  →  conv( 8ch 2b w8 d1+p)  →  conv(12ch 5b w8 d1+p)
 451     0.6216  0.6900  [4175 LC  139.1 fps]  conv( 6ch 2b w4   +p)  →  conv( 8ch 2b w8 d1+p)  →  conv(10ch 4b w8 d1+p)
 452     0.7346  0.6500  [4178 LC  665.5 fps]  conv( 2ch 3b w4   +p)  →  conv( 4ch 5b w8 d1+p)  →  conv(10ch 5b w8 d1+p)
 453     0.7885  0.8300  [4178 LC  450.2 fps]  conv( 2ch 3b w4   +p)  →  conv( 6ch 4b w8 d1+p)  →  conv(10ch 4b w8 d1+p)
 454     0.6660  0.6600  [4178 LC  493.7 fps]  conv( 2ch 4b      +p)  →  conv( 6ch 4b w8 d1+p)  →  conv( 9ch 4b w8 d1+p)
 455    aborted          [4181 LC  273.3 fps]  conv( 4ch 2b w4   +p)  →  conv( 6ch 2b w8 d1+p)  →  conv(12ch 5b w8 d1+p)
 456     0.7222  0.7000  [4184 LC  493.7 fps]  conv( 2ch 2b w4   +p)  →  conv( 6ch 4b w8 d1+p)  →  conv( 9ch 5b w8 d1+p)
 457     0.7897  0.8700  [4184 LC  250.9 fps]  conv( 2ch 2b w4   +p)  →  conv( 9ch 3b w8 d1+p)  →  conv(12ch 3b w8 d1+p)
 458     0.5499  0.6200  [4192 LC  805.6 fps]  conv( 2ch 2b w4   +p)  →  conv( 4ch 2b w8 d1+p)  →  conv( 8ch 2b w8 d1+p)  →  conv( 9ch 4b w8 d1+p)
 459     0.7883  0.7500  [4192 LC  273.3 fps]  conv( 4ch 3b w4   +p)  →  conv( 6ch 3b w8 d1+p)  →  conv( 8ch 5b w8 d1+p)
 460     0.6180  0.6400  [4203 LC  527.8 fps]  conv( 2ch 2b w4   +p)  →  conv( 6ch 2b w8 d1+p)  →  conv( 8ch 2b w8 d1+p)  →  conv( 9ch 3b w8 d1+p)
 461     0.7281  0.7200  [4203 LC  123.4 fps]  conv( 6ch 2b w4   +p)  →  conv( 9ch 2b w8 d1+p)  →  conv(12ch 3b w8 d1+p)
 462     0.5666  0.6200  [4205 LC  805.6 fps]  conv( 2ch 2b w4   +p)  →  conv( 4ch 2b w8 d1+p)  →  conv( 8ch 2b w8 d1+p)  →  conv(12ch 3b w8 d1+p)
 463     0.8044  0.6500  [4205 LC  340.1 fps]  conv( 2ch 3b w4   +p)  →  conv( 8ch 3b w8 d1+p)  →  conv(10ch 4b w8 d1+p)
 464     0.7562  0.7900  [4205 LC   92.8 fps]  conv( 6ch 4b      +p)  →  conv(12ch 5b w8 d1+p)
 465     0.7406  0.7400  [4211 LC  373.3 fps]  conv( 2ch 2b w4   +p)  →  conv( 8ch 3b w8 d1+p)  →  conv( 9ch 5b w8 d1+p)
 466     0.7896  0.7600  [4211 LC  273.3 fps]  conv( 4ch 3b w4   +p)  →  conv( 6ch 3b w8 d1+p)  →  conv(10ch 4b w8 d1+p)
 467     0.7840  0.7600  [4214 LC  273.3 fps]  conv( 4ch 2b w4   +p)  →  conv( 6ch 3b w8 d1+p)  →  conv(12ch 4b w8 d1+p)
 468     0.7343  0.6800  [4214 LC  273.3 fps]  conv( 4ch 2b w4   +p)  →  conv( 6ch 4b w8 d1+p)  →  conv( 9ch 4b w8 d1+p)
 469    aborted          [4219 LC  805.6 fps]  conv( 2ch 2b w4   +p)  →  conv( 4ch 2b w8 d1+p)  →  conv( 6ch 2b w8 d1+p)  →  conv( 8ch 2b w8 d1+p)  →  conv( 9ch 2b w8 d1  )
 470     0.7523  0.8200  [4219 LC  566.9 fps]  conv( 2ch 3b w4   +p)  →  conv( 4ch 4b w8 d1+p)  →  conv(12ch 5b w8 d1+p)
 471    aborted          [4219 LC  273.3 fps]  conv( 4ch 2b w4   +p)  →  conv( 6ch 2b w8 d1+p)  →  conv( 8ch 2b w8 d1+p)  →  conv( 9ch 2b w8 d1+p)
 472     0.7790  0.5600  [4222 LC  206.8 fps]  conv( 4ch 3b w4   +p)  →  conv( 8ch 3b w8 d1+p)  →  conv( 9ch 3b w8 d1+p)
 473     0.7347  0.7400  [4238 LC  273.3 fps]  conv( 4ch 2b w4   +p)  →  conv( 6ch 3b w8 d1+p)  →  conv(10ch 5b w8 d1+p)
 474     0.7630  0.7900  [4241 LC  206.8 fps]  conv( 4ch 2b w4   +p)  →  conv( 8ch 3b w8 d1+p)  →  conv( 9ch 4b w8 d1+p)
 475     0.7127  0.5600  [4241 LC   69.9 fps]  conv( 8ch 3b w4   +p)  →  conv(12ch 5b w8 d1+p)
 476     0.3432  0.3800  [4247 LC  805.6 fps]  conv( 2ch 2b w4   +p)  →  conv( 4ch 2b w8 d1+p)  →  conv( 6ch 2b w8 d1+p)  →  conv( 8ch 2b w8 d1+p)  →  conv(10ch 2b w8 d1  )
 477     0.7757  0.7200  [4247 LC  805.6 fps]  conv( 2ch 2b w4   +p)  →  conv( 4ch 3b w8 d1+p)  →  conv( 6ch 3b w8 d1+p)  →  conv( 9ch 3b w8 d1+p)
 478     0.8174  0.8300  [4249 LC  373.3 fps]  conv( 2ch 2b w4   +p)  →  conv( 6ch 3b w8 d1+p)  →  conv(12ch 5b w8 d1+p)
 479     0.8550  0.8700  [4255 LC  206.8 fps]  conv( 4ch 2b w4   +p)  →  conv( 8ch 3b w8 d1+p)  →  conv(12ch 3b w8 d1+p)
 480     0.5426  0.5700  [4258 LC  184.4 fps]  conv( 4ch 2b w4   +p)  →  conv( 9ch 2b w8 d1+p)  →  conv(12ch 4b w8 d1+p)
 481     0.7747  0.8200  [4260 LC  139.1 fps]  conv( 6ch 2b w4   +p)  →  conv( 8ch 3b w8 d1+p)  →  conv( 9ch 3b w8 d1+p)
 482     0.7180  0.6900  [4263 LC  527.8 fps]  conv( 2ch 4b      +p)  →  conv( 6ch 4b w8 d1+p)  →  conv( 8ch 5b w8 d1+p)
 483     0.7801  0.8000  [4263 LC  765.3 fps]  conv( 2ch 5b w4   +p)  →  conv( 4ch 5b w8 d1+p)  →  conv( 9ch 5b w8 d1+p)
 484     0.6442  0.6600  [4266 LC  805.6 fps]  conv( 2ch 2b w4   +p)  →  conv( 4ch 2b w8 d1+p)  →  conv( 6ch 3b w8 d1+p)  →  conv( 9ch 4b w8 d1+p)
 485     0.7292  0.3100  [4266 LC  805.6 fps]  conv( 2ch 3b w4   +p)  →  conv( 4ch 3b w8 d1+p)  →  conv( 6ch 3b w8 d1+p)  →  conv( 8ch 3b w8 d1+p)
 486     0.8018  0.7600  [4266 LC  184.4 fps]  conv( 4ch 2b w4   +p)  →  conv( 9ch 3b w8 d1+p)  →  conv(10ch 3b w8 d1+p)
 487     0.6315  0.6400  [4269 LC  805.6 fps]  conv( 2ch 2b w4   +p)  →  conv( 4ch 2b w8 d1+p)  →  conv( 6ch 2b w8 d1+p)  →  conv(12ch 4b w8 d1+p)
 488     0.8499  0.7600  [4269 LC  273.3 fps]  conv( 4ch 3b w4   +p)  →  conv( 6ch 5b w8 d1+p)  →  conv(12ch 5b w8 d1  )
 489     0.6730  0.2300  [4269 LC  110.9 fps]  conv( 6ch 5b w4   +p)  →  conv(10ch 5b w8 d1+p)
 490     0.7880  0.7600  [4274 LC  300.1 fps]  conv( 2ch 2b w4   +p)  →  conv( 9ch 3b w8 d1+p)  →  conv(10ch 4b w8 d1+p)
 491     0.7466  0.7400  [4274 LC  250.9 fps]  conv( 2ch 3b w4   +p)  →  conv( 9ch 4b w8 d1+p)  →  conv(12ch 5b w8 d1  )
 492    aborted          [4277 LC  493.7 fps]  conv( 2ch 2b w4   +p)  →  conv( 6ch 2b w8 d1+p)  →  conv( 9ch 2b w8 d1+p)  →  conv(12ch 2b w8 d1+p)
 493     0.6985  0.7200  [4280 LC  805.6 fps]  conv( 2ch 2b w4   +p)  →  conv( 4ch 2b w8 d1+p)  →  conv( 6ch 3b w8 d1+p)  →  conv(12ch 3b w8 d1+p)
 494     0.4224  0.3300  [4280 LC  273.3 fps]  conv( 4ch 2b w4   +p)  →  conv( 6ch 2b w8 d1+p)  →  conv( 8ch 2b w8 d1+p)  →  conv(10ch 2b w8 d1+p)
 495     0.6478  0.6200  [4280 LC   93.3 fps]  conv( 8ch 4b      +p)  →  conv( 9ch 5b w8 d1+p)
 496     0.5606  0.6200  [4282 LC  527.8 fps]  conv( 2ch 2b w4   +p)  →  conv( 6ch 2b w8 d1+p)  →  conv( 8ch 2b w8 d1+p)  →  conv(10ch 3b w8 d1+p)
 497     0.6988  0.7100  [4282 LC  665.5 fps]  conv( 2ch 4b      +p)  →  conv( 4ch 5b w8 d1+p)  →  conv(10ch 5b w8 d1+p)
 498     0.7968  0.6800  [4282 LC  450.2 fps]  conv( 2ch 4b      +p)  →  conv( 6ch 4b w8 d1+p)  →  conv(10ch 4b w8 d1+p)
 499     0.6282  0.5600  [4282 LC  184.4 fps]  conv( 4ch 2b w4   +p)  →  conv( 9ch 2b w8 d1+p)  →  conv(10ch 5b w8 d1+p)
 500     0.6238  0.6100  [4282 LC  139.1 fps]  conv( 6ch 2b w4   +p)  →  conv( 8ch 2b w8 d1+p)  →  conv( 9ch 5b w8 d1+p)
 501    aborted          [4282 LC   83.6 fps]  conv( 8ch 2b w4   +p)  →  conv(10ch 2b w8 d1+p)  →  conv(12ch 2b w8 d1+p)
 502     0.7348  0.7300  [4285 LC  373.3 fps]  conv( 2ch 2b w4   +p)  →  conv( 6ch 4b w8 d1+p)  →  conv(12ch 4b w8 d1+p)
 503     0.7841  0.8300  [4285 LC  493.7 fps]  conv( 2ch 3b w4   +p)  →  conv( 6ch 4b w8 d1+p)  →  conv( 9ch 5b w8 d1+p)
 504     0.8258  0.6400  [4285 LC  250.9 fps]  conv( 2ch 3b w4   +p)  →  conv( 9ch 3b w8 d1+p)  →  conv(12ch 3b w8 d1+p)
 505     0.6547  0.6700  [4288 LC   93.3 fps]  conv( 8ch 2b w4   +p)  →  conv( 9ch 2b w8 d1+p)  →  conv(10ch 3b w8 d1+p)
 506     0.5684  0.6200  [4293 LC  805.6 fps]  conv( 2ch 2b w4   +p)  →  conv( 4ch 2b w8 d1+p)  →  conv( 6ch 2b w8 d1+p)  →  conv(10ch 5b w8 d1+p)
 507     0.6743  0.8000  [4293 LC  250.9 fps]  conv( 2ch 2b w4   +p)  →  conv( 9ch 2b w8 d1+p)  →  conv(12ch 5b w8 d1+p)
 508     0.6816  0.7500  [4293 LC  123.4 fps]  conv( 6ch 2b w4   +p)  →  conv( 9ch 2b w8 d1+p)  →  conv(10ch 4b w8 d1+p)
 509    aborted          [4296 LC  805.6 fps]  conv( 2ch 2b w4   +p)  →  conv( 4ch 2b w8 d1+p)  →  conv( 6ch 2b w8 d1+p)  →  conv( 8ch 2b w8 d1+p)  →  conv( 9ch 3b w8 d1  )
 510     0.5833  0.6200  [4296 LC  805.6 fps]  conv( 2ch 2b w4   +p)  →  conv( 4ch 2b w8 d1+p)  →  conv( 8ch 2b w8 d1+p)  →  conv(10ch 4b w8 d1+p)
 511     0.7020  0.7300  [4299 LC  273.3 fps]  conv( 4ch 2b w4   +p)  →  conv( 6ch 4b w8 d1+p)  →  conv( 8ch 5b w8 d1+p)
 512     0.7294  0.1400  [4299 LC   62.2 fps]  conv( 9ch 5b w4   +p)  →  conv(12ch 5b w8 d1  )
 513    aborted          [4301 LC  805.6 fps]  conv( 2ch 2b w4   +p)  →  conv( 4ch 2b w8 d1+p)  →  conv( 6ch 2b w8 d1+p)  →  conv( 8ch 2b w8 d1+p)  →  conv(12ch 2b w8 d1  )
 514     0.8185  0.6800  [4301 LC  206.8 fps]  conv( 4ch 3b w4   +p)  →  conv( 8ch 3b w8 d1+p)  →  conv(10ch 3b w8 d1+p)
 515     0.7807  0.7700  [4310 LC  765.3 fps]  conv( 2ch 2b w4   +p)  →  conv( 4ch 2b w8 d1+p)  →  conv( 9ch 3b w8 d1+p)  →  conv(12ch 5b w8 d1  )
 516     0.7528  0.7600  [4310 LC  450.2 fps]  conv( 2ch 2b w4   +p)  →  conv( 6ch 4b w8 d1+p)  →  conv(10ch 5b w8 d1+p)
 517     0.6221  0.6400  [4310 LC   56.1 fps]  conv(10ch 3b w4   +p)  →  conv(12ch 4b w8 d1+p)
 518     0.7505  0.7600  [4312 LC  283.4 fps]  conv( 2ch 2b w4   +p)  →  conv( 8ch 3b w8 d1+p)  →  conv(12ch 4b w8 d1+p)
 519     0.7627  0.5300  [4312 LC  373.3 fps]  conv( 2ch 3b w4   +p)  →  conv( 8ch 3b w8 d1+p)  →  conv( 9ch 5b w8 d1+p)
 520     0.6104  0.6400  [4315 LC  373.3 fps]  conv( 2ch 2b w4   +p)  →  conv( 8ch 2b w8 d1+p)  →  conv( 9ch 2b w8 d1+p)  →  conv(12ch 5b w8 d1  )
 521     0.7956  0.7200  [4315 LC  273.3 fps]  conv( 4ch 3b w4   +p)  →  conv( 6ch 4b w8 d1+p)  →  conv( 8ch 4b w8 d1+p)
 522     0.8443  0.6700  [4318 LC  805.6 fps]  conv( 2ch 2b w4   +p)  →  conv( 4ch 3b w8 d1+p)  →  conv( 6ch 4b w8 d1+p)  →  conv(12ch 5b w8 d1  )
 523     0.7025  0.7000  [4318 LC  273.3 fps]  conv( 4ch 2b w4   +p)  →  conv( 6ch 4b w8 d1+p)  →  conv(10ch 4b w8 d1+p)
 524     0.7273  0.7200  [4318 LC  273.3 fps]  conv( 4ch 3b w4   +p)  →  conv( 6ch 3b w8 d1+p)  →  conv( 9ch 5b w8 d1+p)
 525     0.6296  0.7100  [4321 LC  273.3 fps]  conv( 4ch 2b w4   +p)  →  conv( 6ch 2b w8 d1+p)  →  conv( 9ch 2b w8 d1+p)  →  conv(12ch 5b w8 d1  )
 526     0.8857  0.8500  [4321 LC  164.6 fps]  conv( 4ch 3b w4   +p)  →  conv(10ch 3b w8 d1+p)  →  conv(12ch 5b w8 d1  )
 527     0.7170  0.7700  [4321 LC  110.9 fps]  conv( 6ch 2b w4   +p)  →  conv(10ch 2b w8 d1+p)  →  conv(12ch 3b w8 d1+p)
 528     0.6103  0.6100  [4323 LC  765.3 fps]  conv( 2ch 2b w4   +p)  →  conv( 4ch 2b w8 d1+p)  →  conv( 9ch 2b w8 d1+p)  →  conv(12ch 3b w8 d1+p)
 529     0.8283  0.7900  [4323 LC  566.9 fps]  conv( 2ch 4b      +p)  →  conv( 4ch 4b w8 d1+p)  →  conv(12ch 5b w8 d1+p)
 530    aborted          [4326 LC  805.6 fps]  conv( 2ch 2b w4   +p)  →  conv( 4ch 2b w8 d1+p)  →  conv( 6ch 2b w8 d1+p)  →  conv( 8ch 2b w8 d1+p)  →  conv(10ch 3b w8 d1  )
 531     0.7392  0.6600  [4326 LC  805.6 fps]  conv( 2ch 2b w4   +p)  →  conv( 4ch 3b w8 d1+p)  →  conv( 6ch 3b w8 d1+p)  →  conv(10ch 3b w8 d1+p)
 532     0.7023  0.6800  [4329 LC  566.9 fps]  conv( 2ch 2b w4   +p)  →  conv( 4ch 5b w8 d1+p)  →  conv(12ch 5b w8 d1+p)
 533     0.8488  0.7600  [4329 LC  139.1 fps]  conv( 6ch 3b w4   +p)  →  conv( 8ch 3b w8 d1+p)  →  conv(12ch 5b w8 d1  )
 534     0.7094  0.7000  [4337 LC  340.1 fps]  conv( 2ch 2b w4   +p)  →  conv( 8ch 3b w8 d1+p)  →  conv(10ch 5b w8 d1+p)
 535     0.7757  0.7200  [4340 LC  139.1 fps]  conv( 6ch 2b w4   +p)  →  conv( 8ch 3b w8 d1+p)  →  conv(10ch 3b w8 d1+p)
 536     0.8452  0.7700  [4345 LC  805.6 fps]  conv( 2ch 2b w4   +p)  →  conv( 4ch 3b w8 d1+p)  →  conv( 8ch 3b w8 d1+p)  →  conv(12ch 5b w8 d1  )
 537     0.7959  0.7900  [4345 LC  206.8 fps]  conv( 4ch 2b w4   +p)  →  conv( 8ch 3b w8 d1+p)  →  conv(10ch 4b w8 d1+p)
 538     0.7619  0.4100  [4348 LC  805.6 fps]  conv( 2ch 3b w4   +p)  →  conv( 4ch 3b w8 d1+p)  →  conv( 6ch 3b w8 d1+p)  →  conv( 9ch 3b w8 d1+p)
 539     0.6297  0.6300  [4351 LC  805.6 fps]  conv( 2ch 2b w4   +p)  →  conv( 4ch 2b w8 d1+p)  →  conv( 6ch 3b w8 d1+p)  →  conv( 8ch 5b w8 d1+p)
 540     0.7984  0.7300  [4351 LC  373.3 fps]  conv( 2ch 3b w4   +p)  →  conv( 6ch 3b w8 d1+p)  →  conv(12ch 5b w8 d1+p)
 541     0.8352  0.8600  [4354 LC  225.1 fps]  conv( 2ch 2b w4   +p)  →  conv(10ch 3b w8 d1+p)  →  conv(12ch 3b w8 d1+p)
 542     0.8382  0.8200  [4359 LC  110.9 fps]  conv( 6ch 2b w4   +p)  →  conv(10ch 3b w8 d1+p)  →  conv(12ch 5b w8 d1  )
 543    aborted          [4365 LC  805.6 fps]  conv( 2ch 2b w4   +p)  →  conv( 4ch 2b w8 d1+p)  →  conv( 6ch 2b w8 d1+p)  →  conv( 9ch 2b w8 d1+p)  →  conv(10ch 2b w8 d1  )
 544     0.6787  0.5200  [4367 LC  805.6 fps]  conv( 2ch 2b w4   +p)  →  conv( 4ch 3b w8 d1+p)  →  conv( 6ch 3b w8 d1+p)  →  conv( 8ch 4b w8 d1+p)
 545     0.7000  0.7300  [4370 LC  805.6 fps]  conv( 2ch 2b w4   +p)  →  conv( 4ch 2b w8 d1+p)  →  conv( 6ch 3b w8 d1+p)  →  conv(10ch 4b w8 d1+p)
 546     0.8341  0.8800  [4370 LC  283.4 fps]  conv( 2ch 2b w4   +p)  →  conv( 8ch 5b w8 d1+p)  →  conv(12ch 5b w8 d1  )
 547    aborted          [4373 LC  805.6 fps]  conv( 2ch 2b w4   +p)  →  conv( 4ch 2b w8 d1+p)  →  conv( 6ch 2b w8 d1+p)  →  conv( 8ch 2b w8 d1+p)  →  conv( 9ch 4b w8 d1  )
 548     0.6983  0.7900  [4373 LC  527.8 fps]  conv( 2ch 2b w4   +p)  →  conv( 6ch 5b w8 d1+p)  →  conv( 8ch 5b w8 d1+p)
 549     0.7775  0.8100  [4375 LC  527.8 fps]  conv( 2ch 2b w4   +p)  →  conv( 6ch 2b w8 d1+p)  →  conv( 8ch 3b w8 d1+p)  →  conv(12ch 5b w8 d1  )
 550     0.8355  0.8000  [4375 LC  300.1 fps]  conv( 2ch 3b w4   +p)  →  conv( 9ch 3b w8 d1+p)  →  conv(10ch 4b w8 d1+p)
 551     0.7489  0.7300  [4375 LC  164.6 fps]  conv( 4ch 2b w4   +p)  →  conv(10ch 2b w8 d1+p)  →  conv(12ch 4b w8 d1+p)
 552     0.8724  0.8800  [4378 LC  250.9 fps]  conv( 2ch 4b      +p)  →  conv( 9ch 4b w8 d1+p)  →  conv(12ch 5b w8 d1  )
 553     0.6745  0.6600  [4381 LC  805.6 fps]  conv( 2ch 2b w4   +p)  →  conv( 4ch 2b w8 d1+p)  →  conv( 8ch 3b w8 d1+p)  →  conv( 9ch 3b w8 d1+p)
 554     0.6841  0.6600  [4381 LC   69.9 fps]  conv( 8ch 4b      +p)  →  conv(12ch 4b w8 d1+p)
 555     0.6877  0.7700  [4384 LC  139.1 fps]  conv( 6ch 2b w4   +p)  →  conv( 8ch 2b w8 d1+p)  →  conv(12ch 4b w8 d1+p)
 556     0.3151  0.3700  [4386 LC  805.6 fps]  conv( 2ch 2b w4   +p)  →  conv( 4ch 2b w8 d1+p)  →  conv( 6ch 2b w8 d1+p)  →  conv( 8ch 2b w8 d1+p)  →  conv(12ch 3b w8 d1  )
 557     0.8536  0.7600  [4386 LC  373.3 fps]  conv( 2ch 3b w4   +p)  →  conv( 6ch 4b w8 d1+p)  →  conv(12ch 4b w8 d1+p)
 558     0.8205  0.7500  [4389 LC  493.7 fps]  conv( 2ch 4b      +p)  →  conv( 6ch 4b w8 d1+p)  →  conv( 9ch 5b w8 d1+p)
 559     0.7650  0.7500  [4389 LC  665.5 fps]  conv( 2ch 5b w4   +p)  →  conv( 4ch 5b w8 d1+p)  →  conv(10ch 5b w8 d1+p)
 560     0.8622  0.8300  [4389 LC  273.3 fps]  conv( 4ch 4b      +p)  →  conv( 6ch 5b w8 d1+p)  →  conv(10ch 5b w8 d1  )
 561     0.4572  0.2100  [4392 LC  373.3 fps]  conv( 2ch 2b w4   +p)  →  conv( 8ch 2b w8 d1+p)  →  conv( 9ch 2b w8 d1+p)  →  conv(10ch 2b w8 d1+p)
 562     0.4649  0.4100  [4395 LC  450.2 fps]  conv( 2ch 2b w4   +p)  →  conv( 6ch 2b w8 d1+p)  →  conv(10ch 2b w8 d1+p)  →  conv(12ch 2b w8 d1+p)
 563     0.7843  0.7900  [4395 LC  225.1 fps]  conv( 2ch 2b w4   +p)  →  conv(10ch 4b w8 d1+p)  →  conv(12ch 5b w8 d1  )
 564    aborted          [4397 LC  273.3 fps]  conv( 4ch 2b w4   +p)  →  conv( 6ch 2b w8 d1+p)  →  conv( 9ch 2b w8 d1+p)  →  conv(10ch 2b w8 d1+p)
 565     0.8488  0.7800  [4397 LC  206.8 fps]  conv( 4ch 3b w4   +p)  →  conv( 8ch 4b w8 d1+p)  →  conv(12ch 5b w8 d1  )
 566     0.7348  0.7300  [4397 LC   74.7 fps]  conv( 9ch 4b      +p)  →  conv(10ch 4b w8 d1+p)
 567     0.5390  0.5400  [4400 LC  493.7 fps]  conv( 2ch 2b w4   +p)  →  conv( 6ch 2b w8 d1+p)  →  conv( 9ch 2b w8 d1+p)  →  conv(10ch 3b w8 d1+p)
 568     0.4356  0.3100  [4400 LC  273.3 fps]  conv( 4ch 2b w4   +p)  →  conv( 6ch 2b w8 d1+p)  →  conv( 8ch 2b w8 d1+p)  →  conv(12ch 2b w8 d1+p)
 569     0.5377  0.5900  [4403 LC  805.6 fps]  conv( 2ch 2b w4   +p)  →  conv( 4ch 2b w8 d1+p)  →  conv( 8ch 2b w8 d1+p)  →  conv( 9ch 5b w8 d1+p)
 570    aborted          [4403 LC   74.7 fps]  conv( 9ch 2b w4   +p)  →  conv(10ch 2b w8 d1+p)  →  conv(12ch 2b w8 d1+p)
 571     0.6525  0.7100  [4406 LC   83.6 fps]  conv( 8ch 4b      +p)  →  conv(10ch 5b w8 d1+p)
 572     0.6879  0.7200  [4408 LC  139.1 fps]  conv( 6ch 2b w4   +p)  →  conv( 8ch 2b w8 d1+p)  →  conv(10ch 5b w8 d1+p)
 573    aborted          [4411 LC  805.6 fps]  conv( 2ch 2b w4   +p)  →  conv( 4ch 2b w8 d1+p)  →  conv( 6ch 2b w8 d1+p)  →  conv( 8ch 2b w8 d1+p)  →  conv(10ch 4b w8 d1  )
 574     0.6663  0.7300  [4411 LC  225.1 fps]  conv( 2ch 2b w4   +p)  →  conv(10ch 2b w8 d1+p)  →  conv(12ch 5b w8 d1+p)
 575     0.7262  0.7200  [4411 LC  450.2 fps]  conv( 2ch 3b w4   +p)  →  conv( 6ch 4b w8 d1+p)  →  conv(10ch 5b w8 d1+p)
 576     0.8579  0.7100  [4411 LC  123.4 fps]  conv( 6ch 3b w4   +p)  →  conv( 9ch 3b w8 d1+p)  →  conv(10ch 5b w8 d1  )
 577     0.5988  0.6200  [4414 LC  765.3 fps]  conv( 2ch 2b w4   +p)  →  conv( 4ch 2b w8 d1+p)  →  conv( 9ch 2b w8 d1+p)  →  conv(10ch 4b w8 d1+p)
 578     0.8546  0.7400  [4414 LC  283.4 fps]  conv( 2ch 3b w4   +p)  →  conv( 8ch 3b w8 d1+p)  →  conv(12ch 4b w8 d1+p)
 579     0.8651  0.9100  [4414 LC  184.4 fps]  conv( 4ch 2b w4   +p)  →  conv( 9ch 4b w8 d1+p)  →  conv(12ch 5b w8 d1  )
 580     0.6817  0.6100  [4414 LC   62.2 fps]  conv( 9ch 3b w4   +p)  →  conv(12ch 5b w8 d1+p)
 581     0.7807  0.7900  [4417 LC  373.3 fps]  conv( 2ch 2b w4   +p)  →  conv( 8ch 4b w8 d1+p)  →  conv( 9ch 4b w8 d1+p)
 582     0.6848  0.7000  [4417 LC  206.8 fps]  conv( 4ch 2b w4   +p)  →  conv( 8ch 2b w8 d1+p)  →  conv(12ch 5b w8 d1+p)
 583    aborted          [4419 LC  805.6 fps]  conv( 2ch 2b w4   +p)  →  conv( 4ch 2b w8 d1+p)  →  conv( 6ch 2b w8 d1+p)  →  conv( 9ch 2b w8 d1+p)  →  conv(12ch 2b w8 d1  )
 584     0.8817  0.7900  [4419 LC  805.6 fps]  conv( 2ch 3b w4   +p)  →  conv( 4ch 3b w8 d1+p)  →  conv( 6ch 4b w8 d1+p)  →  conv(12ch 5b w8 d1  )
 585     0.8330  0.6300  [4419 LC  273.3 fps]  conv( 4ch 3b w4   +p)  →  conv( 6ch 3b w8 d1+p)  →  conv(12ch 4b w8 d1+p)
 586     0.8141  0.7700  [4419 LC  273.3 fps]  conv( 4ch 3b w4   +p)  →  conv( 6ch 4b w8 d1+p)  →  conv( 9ch 4b w8 d1+p)
 587     0.7739  0.8200  [4425 LC  273.3 fps]  conv( 4ch 2b w4   +p)  →  conv( 6ch 4b w8 d1+p)  →  conv( 9ch 5b w8 d1+p)
 588     0.8517  0.8600  [4425 LC  184.4 fps]  conv( 4ch 2b w4   +p)  →  conv( 9ch 3b w8 d1+p)  →  conv(12ch 3b w8 d1+p)
 589     0.7875  0.7900  [4428 LC  805.6 fps]  conv( 2ch 2b w4   +p)  →  conv( 4ch 2b w8 d1+p)  →  conv( 6ch 5b w8 d1+p)  →  conv(12ch 5b w8 d1  )
 590     0.8096  0.7600  [4428 LC  765.3 fps]  conv( 2ch 2b w4   +p)  →  conv( 4ch 3b w8 d1+p)  →  conv( 9ch 3b w8 d1+p)  →  conv(10ch 5b w8 d1  )
 591     0.6079  0.6600  [4428 LC  527.8 fps]  conv( 2ch 2b w4   +p)  →  conv( 6ch 2b w8 d1+p)  →  conv( 8ch 2b w8 d1+p)  →  conv( 9ch 4b w8 d1+p)
 592     0.8220  0.4400  [4428 LC  805.6 fps]  conv( 2ch 3b w4   +p)  →  conv( 4ch 3b w8 d1+p)  →  conv( 6ch 3b w8 d1+p)  →  conv(10ch 3b w8 d1+p)
 593     0.7611  0.7900  [4430 LC  566.9 fps]  conv( 2ch 3b w4   +p)  →  conv( 4ch 5b w8 d1+p)  →  conv(12ch 5b w8 d1+p)
 594     0.6855  0.7000  [4433 LC  340.1 fps]  conv( 2ch 2b w4   +p)  →  conv( 8ch 2b w8 d1+p)  →  conv(10ch 2b w8 d1+p)  →  conv(12ch 5b w8 d1  )
 595     0.8759  0.8900  [4433 LC   93.3 fps]  conv( 8ch 2b w4   +p)  →  conv( 9ch 3b w8 d1+p)  →  conv(12ch 5b w8 d1  )
 596     0.3622  0.4300  [4436 LC  805.6 fps]  conv( 2ch 2b w4   +p)  →  conv( 4ch 2b w8 d1+p)  →  conv( 6ch 2b w8 d1+p)  →  conv( 8ch 2b w8 d1+p)  →  conv( 9ch 5b w8 d1  )
 597     0.8283  0.7600  [4436 LC  765.3 fps]  conv( 2ch 2b w4   +p)  →  conv( 4ch 3b w8 d1+p)  →  conv( 9ch 3b w8 d1+p)  →  conv(12ch 4b w8 d1  )
 598     0.8708  0.8500  [4436 LC  139.1 fps]  conv( 6ch 2b w4   +p)  →  conv( 8ch 4b w8 d1+p)  →  conv(12ch 5b w8 d1  )
 599     0.8203  0.8600  [4439 LC  805.6 fps]  conv( 2ch 2b w4   +p)  →  conv( 4ch 4b w8 d1+p)  →  conv( 6ch 4b w8 d1+p)  →  conv(10ch 5b w8 d1  )
 600     0.8113  0.6800  [4439 LC  340.1 fps]  conv( 2ch 3b w4   +p)  →  conv( 8ch 3b w8 d1+p)  →  conv(10ch 5b w8 d1+p)
 601     0.6007  0.6100  [4439 LC  273.3 fps]  conv( 4ch 2b w4   +p)  →  conv( 6ch 2b w8 d1+p)  →  conv(10ch 2b w8 d1+p)  →  conv(12ch 5b w8 d1  )
 602     0.5753  0.6500  [4441 LC  665.5 fps]  conv( 2ch 2b w4   +p)  →  conv( 4ch 2b w8 d1+p)  →  conv(10ch 2b w8 d1+p)  →  conv(12ch 3b w8 d1+p)
 603     0.6383  0.6600  [4441 LC  527.8 fps]  conv( 2ch 2b w4   +p)  →  conv( 6ch 2b w8 d1+p)  →  conv( 8ch 2b w8 d1+p)  →  conv(12ch 3b w8 d1+p)
 604    aborted          [4444 LC  805.6 fps]  conv( 2ch 2b w4   +p)  →  conv( 4ch 2b w8 d1+p)  →  conv( 6ch 2b w8 d1+p)  →  conv( 9ch 2b w8 d1+p)  →  conv(10ch 3b w8 d1  )
 605     0.5946  0.6400  [4444 LC  273.3 fps]  conv( 4ch 2b w4   +p)  →  conv( 6ch 2b w8 d1+p)  →  conv( 8ch 2b w8 d1+p)  →  conv( 9ch 3b w8 d1+p)
 606     0.8329  0.5700  [4444 LC  273.3 fps]  conv( 4ch 3b w4   +p)  →  conv( 6ch 3b w8 d1+p)  →  conv(10ch 5b w8 d1+p)
 607     0.8004  0.7600  [4447 LC  805.6 fps]  conv( 2ch 2b w4   +p)  →  conv( 4ch 4b w8 d1+p)  →  conv( 6ch 4b w8 d1+p)  →  conv(12ch 4b w8 d1  )
 608     0.8310  0.7300  [4447 LC  805.6 fps]  conv( 2ch 3b w4   +p)  →  conv( 4ch 3b w8 d1+p)  →  conv( 8ch 3b w8 d1+p)  →  conv(12ch 5b w8 d1  )
 609     0.8185  0.7100  [4447 LC  206.8 fps]  conv( 4ch 3b w4   +p)  →  conv( 8ch 3b w8 d1+p)  →  conv( 9ch 4b w8 d1+p)
 610     0.7045  0.8000  [4447 LC   93.3 fps]  conv( 8ch 2b w4   +p)  →  conv( 9ch 2b w8 d1+p)  →  conv(12ch 3b w8 d1+p)
 611     0.7768  0.7600  [4452 LC  206.8 fps]  conv( 4ch 2b w4   +p)  →  conv( 8ch 3b w8 d1+p)  →  conv( 9ch 5b w8 d1+p)
 612     0.8436  0.7600  [4455 LC  225.1 fps]  conv( 2ch 3b w4   +p)  →  conv(10ch 3b w8 d1+p)  →  conv(12ch 3b w8 d1+p)
 613     0.7594  0.7600  [4458 LC  493.7 fps]  conv( 2ch 2b w4   +p)  →  conv( 6ch 2b w8 d1+p)  →  conv( 9ch 3b w8 d1+p)  →  conv(10ch 5b w8 d1  )
 614     0.6629  0.7100  [4460 LC  805.6 fps]  conv( 2ch 2b w4   +p)  →  conv( 4ch 2b w8 d1+p)  →  conv( 8ch 3b w8 d1+p)  →  conv(10ch 3b w8 d1+p)
 615     0.8831  0.7600  [4460 LC  206.8 fps]  conv( 4ch 3b w4   +p)  →  conv( 8ch 3b w8 d1+p)  →  conv(12ch 3b w8 d1+p)
 616     0.7495  0.7500  [4466 LC  493.7 fps]  conv( 2ch 2b w4   +p)  →  conv( 6ch 2b w8 d1+p)  →  conv( 9ch 3b w8 d1+p)  →  conv(12ch 4b w8 d1  )
 617     0.7463  0.7600  [4469 LC  805.6 fps]  conv( 2ch 2b w4   +p)  →  conv( 4ch 2b w8 d1+p)  →  conv( 8ch 4b w8 d1+p)  →  conv(10ch 5b w8 d1  )
 618     0.7603  0.4700  [4469 LC  805.6 fps]  conv( 2ch 3b w4   +p)  →  conv( 4ch 3b w8 d1+p)  →  conv( 6ch 3b w8 d1+p)  →  conv( 8ch 4b w8 d1+p)
 619     0.6320  0.6600  [4469 LC  206.8 fps]  conv( 4ch 2b w4   +p)  →  conv( 8ch 2b w8 d1+p)  →  conv( 9ch 2b w8 d1+p)  →  conv(10ch 5b w8 d1  )
 620     0.7632  0.6900  [4471 LC  805.6 fps]  conv( 2ch 2b w4   +p)  →  conv( 4ch 3b w8 d1+p)  →  conv( 6ch 3b w8 d1+p)  →  conv( 9ch 4b w8 d1+p)
 621     0.7200  0.8100  [4471 LC  300.1 fps]  conv( 2ch 2b w4   +p)  →  conv( 9ch 2b w8 d1+p)  →  conv(10ch 2b w8 d1+p)  →  conv(12ch 4b w8 d1  )
 622     0.8540  0.8100  [4471 LC  283.4 fps]  conv( 2ch 3b w4   +p)  →  conv( 8ch 5b w8 d1+p)  →  conv(12ch 5b w8 d1  )
 623     0.8301  0.6600  [4471 LC  184.4 fps]  conv( 4ch 3b w4   +p)  →  conv( 9ch 3b w8 d1+p)  →  conv(10ch 3b w8 d1+p)
 624     0.6650  0.6600  [4474 LC  805.6 fps]  conv( 2ch 2b w4   +p)  →  conv( 4ch 2b w8 d1+p)  →  conv( 6ch 4b w8 d1+p)  →  conv( 8ch 4b w8 d1+p)
 625     0.7742  0.8500  [4474 LC  527.8 fps]  conv( 2ch 3b w4   +p)  →  conv( 6ch 5b w8 d1+p)  →  conv( 8ch 5b w8 d1+p)
 626     0.8296  0.7700  [4474 LC  206.8 fps]  conv( 4ch 4b      +p)  →  conv( 8ch 4b w8 d1+p)  →  conv( 9ch 5b w8 d1  )
 627     0.6547  0.6900  [4477 LC  805.6 fps]  conv( 2ch 2b w4   +p)  →  conv( 4ch 2b w8 d1+p)  →  conv( 6ch 3b w8 d1+p)  →  conv( 9ch 5b w8 d1+p)
 628     0.7279  0.8200  [4477 LC  805.6 fps]  conv( 2ch 2b w4   +p)  →  conv( 4ch 2b w8 d1+p)  →  conv( 8ch 4b w8 d1+p)  →  conv(12ch 4b w8 d1  )
 629     0.7091  0.7600  [4477 LC  206.8 fps]  conv( 4ch 2b w4   +p)  →  conv( 8ch 2b w8 d1+p)  →  conv( 9ch 2b w8 d1+p)  →  conv(12ch 4b w8 d1  )
 630     0.8254  0.7700  [4477 LC  273.3 fps]  conv( 4ch 4b      +p)  →  conv( 6ch 5b w8 d1+p)  →  conv(12ch 5b w8 d1  )
 631    aborted          [4480 LC  805.6 fps]  conv( 2ch 2b w4   +p)  →  conv( 4ch 2b w8 d1+p)  →  conv( 6ch 2b w8 d1+p)  →  conv( 8ch 2b w8 d1+p)  →  conv(10ch 5b w8 d1  )
 632     0.7666  0.7900  [4480 LC  665.5 fps]  conv( 2ch 2b w4   +p)  →  conv( 4ch 2b w8 d1+p)  →  conv(10ch 3b w8 d1+p)  →  conv(12ch 5b w8 d1  )
 633     0.7888  0.7900  [4480 LC  206.8 fps]  conv( 4ch 2b w4   +p)  →  conv( 8ch 5b w8 d1+p)  →  conv( 9ch 5b w8 d1  )
 634     0.7876  0.7800  [4482 LC  250.9 fps]  conv( 2ch 2b w4   +p)  →  conv( 9ch 3b w8 d1+p)  →  conv(12ch 4b w8 d1+p)
 635     0.8275  0.7400  [4485 LC  805.6 fps]  conv( 2ch 2b w4   +p)  →  conv( 4ch 3b w8 d1+p)  →  conv( 6ch 3b w8 d1+p)  →  conv(12ch 3b w8 d1+p)
 636     0.7676  0.7600  [4485 LC  273.3 fps]  conv( 4ch 2b w4   +p)  →  conv( 6ch 2b w8 d1+p)  →  conv( 8ch 3b w8 d1+p)  →  conv( 9ch 5b w8 d1  )
 637     0.7810  0.7900  [4485 LC  139.1 fps]  conv( 6ch 2b w4   +p)  →  conv( 8ch 3b w8 d1+p)  →  conv( 9ch 4b w8 d1+p)
 638    aborted          [4488 LC  805.6 fps]  conv( 2ch 2b w4   +p)  →  conv( 4ch 2b w8 d1+p)  →  conv( 6ch 2b w8 d1+p)  →  conv( 8ch 2b w8 d1+p)  →  conv(12ch 4b w8 d1  )
 639     0.7651  0.8100  [4488 LC  340.1 fps]  conv( 2ch 4b      +p)  →  conv( 8ch 5b w8 d1+p)  →  conv(10ch 5b w8 d1  )
 640     0.8503  0.8500  [4491 LC  373.3 fps]  conv( 2ch 4b      +p)  →  conv( 6ch 4b w8 d1+p)  →  conv(12ch 4b w8 d1+p)
 641     0.8151  0.8100  [4491 LC  273.3 fps]  conv( 4ch 2b w4   +p)  →  conv( 6ch 3b w8 d1+p)  →  conv(12ch 5b w8 d1+p)
 642     0.8646  0.8000  [4496 LC  805.6 fps]  conv( 2ch 3b w4   +p)  →  conv( 4ch 4b w8 d1+p)  →  conv( 6ch 4b w8 d1+p)  →  conv( 9ch 5b w8 d1  )
 643     0.8470  0.7300  [4496 LC  225.1 fps]  conv( 2ch 3b w4   +p)  →  conv(10ch 4b w8 d1+p)  →  conv(12ch 5b w8 d1  )
 644     0.6371  0.6100  [4499 LC  493.7 fps]  conv( 2ch 2b w4   +p)  →  conv( 6ch 5b w8 d1+p)  →  conv( 9ch 5b w8 d1+p)
 645     0.8188  0.8200  [4499 LC  139.1 fps]  conv( 6ch 2b w4   +p)  →  conv( 8ch 3b w8 d1+p)  →  conv(12ch 3b w8 d1+p)
 646     0.8779  0.7600  [4499 LC  123.4 fps]  conv( 6ch 3b w4   +p)  →  conv( 9ch 3b w8 d1+p)  →  conv(12ch 5b w8 d1  )
 647     0.8267  0.8000  [4502 LC  805.6 fps]  conv( 2ch 2b w4   +p)  →  conv( 4ch 3b w8 d1+p)  →  conv( 6ch 5b w8 d1+p)  →  conv( 9ch 5b w8 d1  )
 648     0.6201  0.6100  [4502 LC  123.4 fps]  conv( 6ch 2b w4   +p)  →  conv( 9ch 2b w8 d1+p)  →  conv(12ch 4b w8 d1+p)
 649    aborted          [4504 LC  805.6 fps]  conv( 2ch 2b w4   +p)  →  conv( 4ch 2b w8 d1+p)  →  conv( 6ch 2b w8 d1+p)  →  conv( 9ch 2b w8 d1+p)  →  conv(12ch 3b w8 d1  )
 650     0.6489  0.6900  [4504 LC  805.6 fps]  conv( 2ch 2b w4   +p)  →  conv( 4ch 2b w8 d1+p)  →  conv( 8ch 2b w8 d1+p)  →  conv(12ch 4b w8 d1+p)
 651     0.7350  0.6400  [4504 LC  273.3 fps]  conv( 4ch 3b w4   +p)  →  conv( 6ch 4b w8 d1+p)  →  conv( 8ch 5b w8 d1+p)
 652     0.6892  0.7300  [4507 LC  300.1 fps]  conv( 2ch 2b w4   +p)  →  conv( 9ch 3b w8 d1+p)  →  conv(10ch 5b w8 d1+p)
 653     0.8152  0.7500  [4510 LC  123.4 fps]  conv( 6ch 2b w4   +p)  →  conv( 9ch 3b w8 d1+p)  →  conv(10ch 3b w8 d1+p)
 654     0.4594  0.3800  [4513 LC  373.3 fps]  conv( 2ch 2b w4   +p)  →  conv( 8ch 2b w8 d1+p)  →  conv( 9ch 2b w8 d1+p)  →  conv(12ch 2b w8 d1+p)
 655     0.8838  0.8000  [4515 LC  765.3 fps]  conv( 2ch 2b w4   +p)  →  conv( 4ch 3b w8 d1+p)  →  conv( 9ch 3b w8 d1+p)  →  conv(12ch 5b w8 d1  )
 656     0.8103  0.8300  [4515 LC  450.2 fps]  conv( 2ch 4b      +p)  →  conv( 6ch 4b w8 d1+p)  →  conv(10ch 5b w8 d1+p)
 657     0.8255  0.7700  [4515 LC  184.4 fps]  conv( 4ch 2b w4   +p)  →  conv( 9ch 3b w8 d1+p)  →  conv(10ch 4b w8 d1+p)
 658     0.8150  0.7900  [4518 LC  373.3 fps]  conv( 2ch 3b w4   +p)  →  conv( 8ch 4b w8 d1+p)  →  conv( 9ch 4b w8 d1+p)
 659     0.4935  0.4300  [4518 LC  273.3 fps]  conv( 4ch 2b w4   +p)  →  conv( 6ch 2b w8 d1+p)  →  conv( 9ch 2b w8 d1+p)  →  conv(12ch 2b w8 d1+p)
 660     0.8558  0.7700  [4518 LC  206.8 fps]  conv( 4ch 4b      +p)  →  conv( 8ch 4b w8 d1+p)  →  conv(10ch 5b w8 d1  )
 661     0.7202  0.7700  [4521 LC  340.1 fps]  conv( 2ch 2b w4   +p)  →  conv( 8ch 4b w8 d1+p)  →  conv(10ch 4b w8 d1+p)
 662     0.8876  0.8800  [4521 LC  225.1 fps]  conv( 2ch 4b      +p)  →  conv(10ch 4b w8 d1+p)  →  conv(12ch 4b w8 d1  )
 663     0.7094  0.7500  [4521 LC   92.8 fps]  conv( 6ch 5b w4   +p)  →  conv(12ch 5b w8 d1+p)
 664     0.5896  0.6800  [4524 LC  273.3 fps]  conv( 4ch 2b w4   +p)  →  conv( 6ch 2b w8 d1+p)  →  conv( 8ch 2b w8 d1+p)  →  conv(10ch 3b w8 d1+p)
 665    aborted          [4524 LC  206.8 fps]  conv( 4ch 2b w4   +p)  →  conv( 8ch 5b w8 d1+p)  →  conv(10ch 5b w8 d1  )
 666     0.7971  0.5000  [4524 LC  273.3 fps]  conv( 4ch 3b w4   +p)  →  conv( 6ch 4b w8 d1+p)  →  conv(10ch 4b w8 d1+p)
 667     0.6520  0.6100  [4524 LC  273.3 fps]  conv( 4ch 4b      +p)  →  conv( 6ch 4b w8 d1+p)  →  conv( 8ch 4b w8 d1+p)
 668     0.8765  0.8800  [4524 LC   83.6 fps]  conv( 8ch 2b w4   +p)  →  conv(10ch 3b w8 d1+p)  →  conv(12ch 4b w8 d1  )
 669     0.7824  0.7600  [4526 LC  805.6 fps]  conv( 2ch 2b w4   +p)  →  conv( 4ch 4b w8 d1+p)  →  conv( 6ch 4b w8 d1+p)  →  conv(12ch 5b w8 d1  )
 670     0.8045  0.8600  [4526 LC  273.3 fps]  conv( 4ch 2b w4   +p)  →  conv( 6ch 4b w8 d1+p)  →  conv(12ch 4b w8 d1+p)
 671     0.8977  0.9200  [4526 LC  206.8 fps]  conv( 4ch 4b      +p)  →  conv( 8ch 4b w8 d1+p)  →  conv(12ch 4b w8 d1  )
 672     0.6595  0.6600  [4526 LC  123.4 fps]  conv( 6ch 2b w4   +p)  →  conv( 9ch 2b w8 d1+p)  →  conv(10ch 5b w8 d1+p)
 673     0.3770  0.3900  [4529 LC  805.6 fps]  conv( 2ch 2b w4   +p)  →  conv( 4ch 2b w8 d1+p)  →  conv( 6ch 2b w8 d1+p)  →  conv( 9ch 2b w8 d1+p)  →  conv(10ch 4b w8 d1  )
 674     0.4831  0.4900  [4529 LC  805.6 fps]  conv( 2ch 2b w4   +p)  →  conv( 4ch 2b w8 d1+p)  →  conv( 8ch 2b w8 d1+p)  →  conv(10ch 5b w8 d1+p)
 675     0.8848  0.8400  [4529 LC  765.3 fps]  conv( 2ch 3b w4   +p)  →  conv( 4ch 3b w8 d1+p)  →  conv( 9ch 3b w8 d1+p)  →  conv(10ch 5b w8 d1  )
 676     0.7430  0.7900  [4529 LC  273.3 fps]  conv( 4ch 2b w4   +p)  →  conv( 6ch 2b w8 d1+p)  →  conv( 8ch 3b w8 d1+p)  →  conv(10ch 5b w8 d1  )
 677     0.5649  0.5800  [4532 LC  527.8 fps]  conv( 2ch 2b w4   +p)  →  conv( 6ch 2b w8 d1+p)  →  conv( 8ch 2b w8 d1+p)  →  conv(10ch 4b w8 d1+p)
 678     0.8766  0.5900  [4532 LC  184.4 fps]  conv( 4ch 3b w4   +p)  →  conv( 9ch 4b w8 d1+p)  →  conv(10ch 5b w8 d1  )
 679     0.8093  0.8200  [4535 LC  566.9 fps]  conv( 2ch 4b      +p)  →  conv( 4ch 5b w8 d1+p)  →  conv(12ch 5b w8 d1+p)
 680     0.6416  0.7200  [4535 LC  184.4 fps]  conv( 4ch 2b w4   +p)  →  conv( 9ch 2b w8 d1+p)  →  conv(12ch 5b w8 d1+p)
 681     0.4050  0.3500  [4537 LC  805.6 fps]  conv( 2ch 2b w4   +p)  →  conv( 4ch 2b w8 d1+p)  →  conv( 6ch 2b w8 d1+p)  →  conv(10ch 2b w8 d1+p)  →  conv(12ch 2b w8 d1  )
 682     0.8516  0.5000  [4537 LC  765.3 fps]  conv( 2ch 3b w4   +p)  →  conv( 4ch 3b w8 d1+p)  →  conv( 9ch 3b w8 d1+p)  →  conv(12ch 4b w8 d1  )
 683     0.8291  0.7900  [4537 LC  273.3 fps]  conv( 4ch 2b w4   +p)  →  conv( 6ch 2b w8 d1+p)  →  conv( 8ch 3b w8 d1+p)  →  conv(12ch 4b w8 d1  )
 684     0.7378  0.8200  [4537 LC   93.3 fps]  conv( 8ch 2b w4   +p)  →  conv( 9ch 2b w8 d1+p)  →  conv(10ch 4b w8 d1+p)
 685     0.8410  0.7700  [4540 LC  805.6 fps]  conv( 2ch 3b w4   +p)  →  conv( 4ch 4b w8 d1+p)  →  conv( 6ch 4b w8 d1+p)  →  conv(10ch 5b w8 d1  )
 686     0.8872  0.8600  [4540 LC  184.4 fps]  conv( 4ch 3b w4   +p)  →  conv( 9ch 4b w8 d1+p)  →  conv(12ch 4b w8 d1  )
 687     0.5295  0.6300  [4546 LC  805.6 fps]  conv( 2ch 2b w4   +p)  →  conv( 4ch 2b w8 d1+p)  →  conv( 6ch 2b w8 d1+p)  →  conv(12ch 5b w8 d1+p)
 688     0.8758  0.8600  [4546 LC  805.6 fps]  conv( 2ch 2b w4   +p)  →  conv( 4ch 3b w8 d1+p)  →  conv( 6ch 5b w8 d1+p)  →  conv(10ch 5b w8 d1  )
 689     0.7865  0.8400  [4546 LC  493.7 fps]  conv( 2ch 2b w4   +p)  →  conv( 6ch 2b w8 d1+p)  →  conv( 9ch 3b w8 d1+p)  →  conv(12ch 5b w8 d1  )
 690     0.8667  0.7400  [4548 LC  805.6 fps]  conv( 2ch 3b w4   +p)  →  conv( 4ch 4b w8 d1+p)  →  conv( 6ch 4b w8 d1+p)  →  conv(12ch 4b w8 d1  )
 691     0.6497  0.6900  [4551 LC  300.1 fps]  conv( 2ch 2b w4   +p)  →  conv( 9ch 2b w8 d1+p)  →  conv(10ch 2b w8 d1+p)  →  conv(12ch 5b w8 d1  )
 692     0.7928  0.7900  [4551 LC  373.3 fps]  conv( 2ch 5b w4   +p)  →  conv( 8ch 5b w8 d1+p)  →  conv( 9ch 5b w8 d1  )
 693     0.7219  0.7400  [4551 LC  273.3 fps]  conv( 4ch 2b w4   +p)  →  conv( 6ch 4b w8 d1+p)  →  conv(10ch 5b w8 d1+p)
 694     0.8205  0.7400  [4551 LC  206.8 fps]  conv( 4ch 3b w4   +p)  →  conv( 8ch 3b w8 d1+p)  →  conv(10ch 4b w8 d1+p)
 695     0.8372  0.8200  [4554 LC  527.8 fps]  conv( 2ch 2b w4   +p)  →  conv( 6ch 3b w8 d1+p)  →  conv( 8ch 3b w8 d1+p)  →  conv( 9ch 5b w8 d1  )
 696     0.8140  0.7700  [4554 LC  206.8 fps]  conv( 4ch 2b w4   +p)  →  conv( 8ch 3b w8 d1+p)  →  conv(12ch 4b w8 d1+p)
 697     0.7653  0.8600  [4556 LC  805.6 fps]  conv( 2ch 2b w4   +p)  →  conv( 4ch 2b w8 d1+p)  →  conv( 8ch 4b w8 d1+p)  →  conv(12ch 5b w8 d1  )
 698     0.7203  0.7100  [4556 LC  805.6 fps]  conv( 2ch 2b w4   +p)  →  conv( 4ch 3b w8 d1+p)  →  conv( 6ch 3b w8 d1+p)  →  conv( 8ch 5b w8 d1+p)
 699     0.7816  0.7700  [4556 LC  300.1 fps]  conv( 2ch 2b w4   +p)  →  conv( 9ch 5b w8 d1+p)  →  conv(10ch 5b w8 d1  )
 700     0.8394  0.8000  [4556 LC  805.6 fps]  conv( 2ch 4b      +p)  →  conv( 4ch 4b w8 d1+p)  →  conv( 6ch 4b w8 d1+p)  →  conv( 8ch 5b w8 d1  )
 701     0.6566  0.7200  [4556 LC  206.8 fps]  conv( 4ch 2b w4   +p)  →  conv( 8ch 2b w8 d1+p)  →  conv( 9ch 2b w8 d1+p)  →  conv(12ch 5b w8 d1  )
 702     0.8173  0.8100  [4556 LC  164.6 fps]  conv( 4ch 2b w4   +p)  →  conv(10ch 4b w8 d1+p)  →  conv(12ch 4b w8 d1  )
 703     0.7653  0.1500  [4556 LC  273.3 fps]  conv( 4ch 5b w4   +p)  →  conv( 6ch 5b w8 d1+p)  →  conv( 9ch 5b w8 d1  )
 704     0.6302  0.7100  [4559 LC  493.7 fps]  conv( 2ch 2b w4   +p)  →  conv( 6ch 2b w8 d1+p)  →  conv( 9ch 2b w8 d1+p)  →  conv(12ch 3b w8 d1+p)
 705     0.7636  0.5900  [4559 LC  805.6 fps]  conv( 2ch 3b w4   +p)  →  conv( 4ch 3b w8 d1+p)  →  conv( 6ch 5b w8 d1+p)  →  conv( 8ch 5b w8 d1  )
 706     0.8044  0.8400  [4562 LC  373.3 fps]  conv( 2ch 2b w4   +p)  →  conv( 6ch 4b w8 d1+p)  →  conv(12ch 5b w8 d1+p)
 707     0.7100  0.7400  [4565 LC   83.6 fps]  conv( 8ch 2b w4   +p)  →  conv(10ch 2b w8 d1+p)  →  conv(12ch 3b w8 d1+p)
 708     0.2968  0.3800  [4567 LC  805.6 fps]  conv( 2ch 2b w4   +p)  →  conv( 4ch 2b w8 d1+p)  →  conv( 6ch 2b w8 d1+p)  →  conv( 8ch 2b w8 d1+p)  →  conv(12ch 5b w8 d1  )
 709     0.8441  0.8600  [4570 LC  123.4 fps]  conv( 6ch 2b w4   +p)  →  conv( 9ch 4b w8 d1+p)  →  conv(10ch 5b w8 d1  )
 710     0.7915  0.5600  [4570 LC  139.1 fps]  conv( 6ch 3b w4   +p)  →  conv( 8ch 3b w8 d1+p)  →  conv( 9ch 3b w8 d1+p)
 711     0.7986  0.5600  [4573 LC  805.6 fps]  conv( 2ch 3b w4   +p)  →  conv( 4ch 3b w8 d1+p)  →  conv( 6ch 3b w8 d1+p)  →  conv( 9ch 4b w8 d1+p)
 712     0.8049  0.8500  [4576 LC  805.6 fps]  conv( 2ch 2b w4   +p)  →  conv( 4ch 3b w8 d1+p)  →  conv( 6ch 3b w8 d1+p)  →  conv(10ch 4b w8 d1+p)
 713     0.8566  0.8600  [4576 LC  805.6 fps]  conv( 2ch 4b      +p)  →  conv( 4ch 4b w8 d1+p)  →  conv( 6ch 4b w8 d1+p)  →  conv(10ch 4b w8 d1  )
 714     0.8751  0.8800  [4576 LC  283.4 fps]  conv( 2ch 4b      +p)  →  conv( 8ch 5b w8 d1+p)  →  conv(12ch 5b w8 d1  )
 715     0.7249  0.1500  [4576 LC   56.1 fps]  conv(10ch 5b w4   +p)  →  conv(12ch 5b w8 d1  )
 716     0.6684  0.8200  [4578 LC  805.6 fps]  conv( 2ch 2b w4   +p)  →  conv( 4ch 2b w8 d1+p)  →  conv( 6ch 3b w8 d1+p)  →  conv(12ch 4b w8 d1+p)
 717     0.6808  0.7000  [4578 LC  805.6 fps]  conv( 2ch 2b w4   +p)  →  conv( 4ch 2b w8 d1+p)  →  conv( 6ch 4b w8 d1+p)  →  conv( 9ch 4b w8 d1+p)
 718     0.7436  0.7200  [4578 LC  527.8 fps]  conv( 2ch 4b      +p)  →  conv( 6ch 5b w8 d1+p)  →  conv( 8ch 5b w8 d1+p)
 719     0.7646  0.7800  [4578 LC  206.8 fps]  conv( 4ch 2b w4   +p)  →  conv( 8ch 3b w8 d1+p)  →  conv(10ch 5b w8 d1+p)
 720     0.8714  0.8900  [4578 LC  123.4 fps]  conv( 6ch 2b w4   +p)  →  conv( 9ch 4b w8 d1+p)  →  conv(12ch 4b w8 d1  )
 721     0.8723  0.8600  [4584 LC  250.9 fps]  conv( 2ch 3b w4   +p)  →  conv( 9ch 3b w8 d1+p)  →  conv(12ch 4b w8 d1+p)
 722     0.7208  0.7200  [4587 LC  805.6 fps]  conv( 2ch 2b w4   +p)  →  conv( 4ch 3b w8 d1+p)  →  conv( 8ch 3b w8 d1+p)  →  conv( 9ch 3b w8 d1+p)
 723     0.8329  0.7300  [4587 LC  805.6 fps]  conv( 2ch 3b w4   +p)  →  conv( 4ch 3b w8 d1+p)  →  conv( 6ch 3b w8 d1+p)  →  conv(12ch 3b w8 d1+p)
 724     0.6913  0.7100  [4587 LC   56.1 fps]  conv(10ch 3b w4   +p)  →  conv(12ch 5b w8 d1+p)
 725     0.7858  0.8200  [4589 LC  283.4 fps]  conv( 2ch 2b w4   +p)  →  conv( 8ch 3b w8 d1+p)  →  conv(12ch 5b w8 d1+p)
 726     0.7992  0.8600  [4589 LC  139.1 fps]  conv( 6ch 2b w4   +p)  →  conv( 8ch 3b w8 d1+p)  →  conv(10ch 4b w8 d1+p)
 727     0.8777  0.8300  [4589 LC  139.1 fps]  conv( 6ch 3b w4   +p)  →  conv( 8ch 4b w8 d1+p)  →  conv(10ch 4b w8 d1  )
 728     0.8818  0.6200  [4589 LC  110.9 fps]  conv( 6ch 3b w4   +p)  →  conv(10ch 3b w8 d1+p)  →  conv(12ch 4b w8 d1  )
 729     0.8138  0.8400  [4595 LC  340.1 fps]  conv( 2ch 5b w4   +p)  →  conv( 8ch 5b w8 d1+p)  →  conv(10ch 5b w8 d1  )
 730     0.6175  0.6600  [4595 LC  206.8 fps]  conv( 4ch 2b w4   +p)  →  conv( 8ch 2b w8 d1+p)  →  conv(10ch 2b w8 d1+p)  →  conv(12ch 4b w8 d1  )
 731     0.8409  0.8400  [4595 LC  164.6 fps]  conv( 4ch 2b w4   +p)  →  conv(10ch 3b w8 d1+p)  →  conv(12ch 3b w8 d1+p)
 732     0.3454  0.3600  [4598 LC  805.6 fps]  conv( 2ch 2b w4   +p)  →  conv( 4ch 2b w8 d1+p)  →  conv( 6ch 2b w8 d1+p)  →  conv( 9ch 2b w8 d1+p)  →  conv(10ch 5b w8 d1  )
 733     0.8627  0.8100  [4598 LC  527.8 fps]  conv( 2ch 2b w4   +p)  →  conv( 6ch 3b w8 d1+p)  →  conv( 8ch 3b w8 d1+p)  →  conv(10ch 5b w8 d1  )
 734     0.3472  0.2600  [4600 LC  805.6 fps]  conv( 2ch 2b w4   +p)  →  conv( 4ch 2b w8 d1+p)  →  conv( 8ch 2b w8 d1+p)  →  conv( 9ch 2b w8 d1+p)  →  conv(10ch 2b w8 d1  )
 735     0.8188  0.8600  [4600 LC  493.7 fps]  conv( 2ch 3b w4   +p)  →  conv( 6ch 5b w8 d1+p)  →  conv( 9ch 5b w8 d1+p)
 736     0.8095  0.7600  [4600 LC  805.6 fps]  conv( 2ch 4b      +p)  →  conv( 4ch 4b w8 d1+p)  →  conv( 6ch 4b w8 d1+p)  →  conv( 9ch 5b w8 d1  )
 737     0.8694  0.8900  [4600 LC  225.1 fps]  conv( 2ch 4b      +p)  →  conv(10ch 4b w8 d1+p)  →  conv(12ch 5b w8 d1  )
 738     0.8309  0.1500  [4600 LC  273.3 fps]  conv( 4ch 5b w4   +p)  →  conv( 6ch 5b w8 d1+p)  →  conv(10ch 5b w8 d1  )
 739     0.6807  0.6800  [4603 LC  805.6 fps]  conv( 2ch 2b w4   +p)  →  conv( 4ch 2b w8 d1+p)  →  conv( 6ch 3b w8 d1+p)  →  conv(10ch 5b w8 d1+p)
 740     0.8466  0.7700  [4603 LC  805.6 fps]  conv( 2ch 3b w4   +p)  →  conv( 4ch 3b w8 d1+p)  →  conv( 6ch 5b w8 d1+p)  →  conv( 9ch 5b w8 d1  )
 741     0.8537  0.8500  [4603 LC   83.6 fps]  conv( 8ch 2b w4   +p)  →  conv(10ch 3b w8 d1+p)  →  conv(12ch 5b w8 d1  )
 742    aborted          [4606 LC  805.6 fps]  conv( 2ch 2b w4   +p)  →  conv( 4ch 2b w8 d1+p)  →  conv( 6ch 2b w8 d1+p)  →  conv( 9ch 2b w8 d1+p)  →  conv(12ch 4b w8 d1  )
 743     0.7023  0.8000  [4606 LC  805.6 fps]  conv( 2ch 2b w4   +p)  →  conv( 4ch 2b w8 d1+p)  →  conv( 8ch 3b w8 d1+p)  →  conv( 9ch 4b w8 d1+p)
 744     0.8227  0.6900  [4606 LC  805.6 fps]  conv( 2ch 2b w4   +p)  →  conv( 4ch 3b w8 d1+p)  →  conv( 8ch 4b w8 d1+p)  →  conv(10ch 4b w8 d1  )
 745     0.8422  0.7800  [4606 LC  665.5 fps]  conv( 2ch 2b w4   +p)  →  conv( 4ch 3b w8 d1+p)  →  conv(10ch 3b w8 d1+p)  →  conv(12ch 4b w8 d1  )
 746     0.8486  0.7100  [4606 LC  527.8 fps]  conv( 2ch 2b w4   +p)  →  conv( 6ch 3b w8 d1+p)  →  conv( 8ch 3b w8 d1+p)  →  conv(12ch 4b w8 d1  )
 747     0.8770  0.8400  [4606 LC  206.8 fps]  conv( 4ch 4b      +p)  →  conv( 8ch 4b w8 d1+p)  →  conv(12ch 5b w8 d1  )
 748     0.7391  0.7600  [4606 LC   62.2 fps]  conv( 9ch 4b      +p)  →  conv(12ch 4b w8 d1+p)
 749     0.8246  0.6200  [4609 LC  300.1 fps]  conv( 2ch 3b w4   +p)  →  conv( 9ch 3b w8 d1+p)  →  conv(10ch 5b w8 d1+p)
 750     0.8667  0.8500  [4611 LC  206.8 fps]  conv( 4ch 2b w4   +p)  →  conv( 8ch 5b w8 d1+p)  →  conv(12ch 5b w8 d1  )
 751     0.7209  0.7300  [4614 LC  273.3 fps]  conv( 4ch 2b w4   +p)  →  conv( 6ch 5b w8 d1+p)  →  conv( 8ch 5b w8 d1+p)
 752     0.8121  0.4700  [4614 LC  139.1 fps]  conv( 6ch 3b w4   +p)  →  conv( 8ch 4b w8 d1+p)  →  conv( 9ch 5b w8 d1  )
 753     0.6626  0.7200  [4617 LC  527.8 fps]  conv( 2ch 2b w4   +p)  →  conv( 6ch 2b w8 d1+p)  →  conv( 8ch 3b w8 d1+p)  →  conv( 9ch 3b w8 d1+p)
 754     0.8839  0.8500  [4617 LC  765.3 fps]  conv( 2ch 3b w4   +p)  →  conv( 4ch 3b w8 d1+p)  →  conv( 9ch 3b w8 d1+p)  →  conv(12ch 5b w8 d1  )
 755     0.8111  0.8300  [4617 LC  273.3 fps]  conv( 4ch 2b w4   +p)  →  conv( 6ch 2b w8 d1+p)  →  conv( 8ch 3b w8 d1+p)  →  conv(12ch 5b w8 d1  )
 756     0.6474  0.6500  [4620 LC  805.6 fps]  conv( 2ch 2b w4   +p)  →  conv( 4ch 2b w8 d1+p)  →  conv( 8ch 3b w8 d1+p)  →  conv(12ch 3b w8 d1+p)
 757     0.8956  0.8600  [4620 LC  184.4 fps]  conv( 4ch 3b w4   +p)  →  conv( 9ch 4b w8 d1+p)  →  conv(12ch 5b w8 d1  )
 758     0.6938  0.7200  [4620 LC  139.1 fps]  conv( 6ch 2b w4   +p)  →  conv( 8ch 2b w8 d1+p)  →  conv( 9ch 2b w8 d1+p)  →  conv(12ch 3b w8 d1  )
 759     0.7619  0.7300  [4620 LC  110.9 fps]  conv( 6ch 2b w4   +p)  →  conv(10ch 2b w8 d1+p)  →  conv(12ch 4b w8 d1+p)
 760    aborted          [4622 LC  805.6 fps]  conv( 2ch 2b w4   +p)  →  conv( 4ch 2b w8 d1+p)  →  conv( 6ch 2b w8 d1+p)  →  conv(10ch 2b w8 d1+p)  →  conv(12ch 3b w8 d1  )
 761     0.5728  0.5500  [4622 LC  765.3 fps]  conv( 2ch 2b w4   +p)  →  conv( 4ch 2b w8 d1+p)  →  conv( 9ch 2b w8 d1+p)  →  conv(12ch 4b w8 d1+p)
 762     0.7227  0.7700  [4622 LC  765.3 fps]  conv( 2ch 2b w4   +p)  →  conv( 4ch 2b w8 d1+p)  →  conv( 9ch 4b w8 d1+p)  →  conv(10ch 4b w8 d1  )
 763     0.8179  0.8100  [4622 LC  340.1 fps]  conv( 2ch 3b w4   +p)  →  conv( 8ch 4b w8 d1+p)  →  conv(10ch 4b w8 d1+p)
 764     0.8489  0.8700  [4622 LC  373.3 fps]  conv( 2ch 4b      +p)  →  conv( 8ch 4b w8 d1+p)  →  conv( 9ch 4b w8 d1+p)
 765     0.7781  0.7500  [4625 LC  450.2 fps]  conv( 2ch 2b w4   +p)  →  conv( 6ch 5b w8 d1+p)  →  conv(10ch 5b w8 d1+p)
 766     0.7636  0.8300  [4625 LC  373.3 fps]  conv( 2ch 2b w4   +p)  →  conv( 8ch 2b w8 d1+p)  →  conv( 9ch 3b w8 d1+p)  →  conv(10ch 4b w8 d1  )
 767     0.7515  0.8400  [4628 LC  373.3 fps]  conv( 2ch 2b w4   +p)  →  conv( 8ch 4b w8 d1+p)  →  conv( 9ch 5b w8 d1+p)
 768     0.8803  0.8300  [4628 LC  805.6 fps]  conv( 2ch 3b w4   +p)  →  conv( 4ch 4b w8 d1+p)  →  conv( 6ch 4b w8 d1+p)  →  conv(12ch 5b w8 d1  )
 769     0.8207  0.8100  [4628 LC  273.3 fps]  conv( 4ch 4b      +p)  →  conv( 6ch 4b w8 d1+p)  →  conv( 9ch 4b w8 d1+p)
 770     0.7138  0.7600  [4631 LC  765.3 fps]  conv( 2ch 2b w4   +p)  →  conv( 4ch 2b w8 d1+p)  →  conv( 9ch 3b w8 d1+p)  →  conv(10ch 3b w8 d1+p)
 771     0.8378  0.7900  [4631 LC  805.6 fps]  conv( 2ch 2b w4   +p)  →  conv( 4ch 3b w8 d1+p)  →  conv( 8ch 4b w8 d1+p)  →  conv( 9ch 5b w8 d1  )
 772     0.5126  0.5200  [4631 LC  340.1 fps]  conv( 2ch 2b w4   +p)  →  conv( 8ch 2b w8 d1+p)  →  conv(10ch 2b w8 d1+p)  →  conv(12ch 2b w8 d1+p)
 773     0.8702  0.6600  [4631 LC  527.8 fps]  conv( 2ch 3b w4   +p)  →  conv( 6ch 3b w8 d1+p)  →  conv( 8ch 3b w8 d1+p)  →  conv(10ch 4b w8 d1  )
 774     0.7582  0.8200  [4631 LC  273.3 fps]  conv( 4ch 2b w4   +p)  →  conv( 6ch 2b w8 d1+p)  →  conv( 9ch 3b w8 d1+p)  →  conv(10ch 4b w8 d1  )
 775     0.8106  0.7200  [4631 LC  273.3 fps]  conv( 4ch 3b w4   +p)  →  conv( 6ch 4b w8 d1+p)  →  conv( 9ch 5b w8 d1+p)
 776     0.8782  0.7700  [4631 LC  184.4 fps]  conv( 4ch 3b w4   +p)  →  conv( 9ch 3b w8 d1+p)  →  conv(12ch 3b w8 d1+p)
 777     0.6277  0.5900  [4631 LC   74.7 fps]  conv( 9ch 4b      +p)  →  conv(10ch 5b w8 d1+p)
 778     0.8056  0.7400  [4633 LC  805.6 fps]  conv( 2ch 2b w4   +p)  →  conv( 4ch 3b w8 d1+p)  →  conv( 6ch 5b w8 d1+p)  →  conv(12ch 5b w8 d1  )
 779    aborted          [4633 LC  206.8 fps]  conv( 4ch 2b w4   +p)  →  conv( 8ch 2b w8 d1+p)  →  conv( 9ch 2b w8 d1+p)  →  conv(10ch 2b w8 d1+p)
 780     0.7002  0.7000  [4636 LC  527.8 fps]  conv( 2ch 2b w4   +p)  →  conv( 6ch 2b w8 d1+p)  →  conv( 8ch 4b w8 d1+p)  →  conv(10ch 4b w8 d1  )
 781     0.7967  0.8400  [4636 LC  450.2 fps]  conv( 2ch 2b w4   +p)  →  conv( 6ch 2b w8 d1+p)  →  conv(10ch 3b w8 d1+p)  →  conv(12ch 4b w8 d1  )
 782     0.6415  0.6800  [4636 LC  373.3 fps]  conv( 2ch 2b w4   +p)  →  conv( 8ch 2b w8 d1+p)  →  conv( 9ch 2b w8 d1+p)  →  conv(10ch 3b w8 d1+p)
 783     0.5162  0.3900  [4636 LC  273.3 fps]  conv( 4ch 2b w4   +p)  →  conv( 6ch 2b w8 d1+p)  →  conv(10ch 2b w8 d1+p)  →  conv(12ch 2b w8 d1+p)
 784     0.8570  0.8800  [4636 LC  164.6 fps]  conv( 4ch 2b w4   +p)  →  conv(10ch 4b w8 d1+p)  →  conv(12ch 5b w8 d1  )
 785     0.5689  0.6100  [4639 LC  527.8 fps]  conv( 2ch 2b w4   +p)  →  conv( 6ch 2b w8 d1+p)  →  conv( 8ch 2b w8 d1+p)  →  conv( 9ch 5b w8 d1+p)
 786     0.8052  0.8600  [4641 LC  566.9 fps]  conv( 2ch 5b w4   +p)  →  conv( 4ch 5b w8 d1+p)  →  conv(12ch 5b w8 d1+p)
 787     0.5461  0.5300  [4641 LC  273.3 fps]  conv( 4ch 2b w4   +p)  →  conv( 6ch 2b w8 d1+p)  →  conv( 9ch 2b w8 d1+p)  →  conv(10ch 3b w8 d1+p)
 788     0.8514  0.8900  [4644 LC  250.9 fps]  conv( 2ch 2b w4   +p)  →  conv( 9ch 5b w8 d1+p)  →  conv(12ch 5b w8 d1  )
 789     0.8642  0.8000  [4644 LC  805.6 fps]  conv( 2ch 4b      +p)  →  conv( 4ch 4b w8 d1+p)  →  conv( 6ch 4b w8 d1+p)  →  conv(10ch 5b w8 d1  )
 790     0.6287  0.6400  [4644 LC  139.1 fps]  conv( 6ch 2b w4   +p)  →  conv( 8ch 2b w8 d1+p)  →  conv( 9ch 2b w8 d1+p)  →  conv(10ch 4b w8 d1  )
 791     0.8831  0.8500  [4644 LC   74.7 fps]  conv( 9ch 2b w4   +p)  →  conv(10ch 3b w8 d1+p)  →  conv(12ch 4b w8 d1  )
 792     0.5689  0.6600  [4647 LC  765.3 fps]  conv( 2ch 2b w4   +p)  →  conv( 4ch 2b w8 d1+p)  →  conv( 9ch 2b w8 d1+p)  →  conv(10ch 5b w8 d1+p)
 793     0.8449  0.6700  [4647 LC  805.6 fps]  conv( 2ch 3b w4   +p)  →  conv( 4ch 3b w8 d1+p)  →  conv( 6ch 5b w8 d1+p)  →  conv(10ch 5b w8 d1  )
 794     0.5968  0.6700  [4650 LC  493.7 fps]  conv( 2ch 2b w4   +p)  →  conv( 6ch 2b w8 d1+p)  →  conv( 9ch 2b w8 d1+p)  →  conv(10ch 4b w8 d1+p)
 795     0.7875  0.6800  [4650 LC  139.1 fps]  conv( 6ch 3b w4   +p)  →  conv( 8ch 3b w8 d1+p)  →  conv(10ch 3b w8 d1+p)
 796     0.7938  0.8100  [4652 LC  225.1 fps]  conv( 2ch 2b w4   +p)  →  conv(10ch 3b w8 d1+p)  →  conv(12ch 4b w8 d1+p)
 797     0.9074  0.7900  [4652 LC  805.6 fps]  conv( 2ch 4b      +p)  →  conv( 4ch 4b w8 d1+p)  →  conv( 6ch 4b w8 d1+p)  →  conv(12ch 4b w8 d1  )
 798     0.7311  0.7800  [4652 LC  164.6 fps]  conv( 4ch 2b w4   +p)  →  conv(10ch 2b w8 d1+p)  →  conv(12ch 5b w8 d1+p)
 799    aborted          [4655 LC  805.6 fps]  conv( 2ch 2b w4   +p)  →  conv( 4ch 2b w8 d1+p)  →  conv( 8ch 2b w8 d1+p)  →  conv( 9ch 2b w8 d1+p)  →  conv(12ch 2b w8 d1  )
 800     0.8641  0.4600  [4655 LC  527.8 fps]  conv( 2ch 3b w4   +p)  →  conv( 6ch 3b w8 d1+p)  →  conv( 8ch 3b w8 d1+p)  →  conv( 9ch 5b w8 d1  )
 801     0.7570  0.5000  [4658 LC  805.6 fps]  conv( 2ch 3b w4   +p)  →  conv( 4ch 3b w8 d1+p)  →  conv( 6ch 3b w8 d1+p)  →  conv( 8ch 5b w8 d1+p)
 802     0.8160  0.5900  [4658 LC  300.1 fps]  conv( 2ch 3b w4   +p)  →  conv( 9ch 5b w8 d1+p)  →  conv(10ch 5b w8 d1  )
 803     0.7987  0.7800  [4658 LC  206.8 fps]  conv( 4ch 2b w4   +p)  →  conv( 8ch 4b w8 d1+p)  →  conv( 9ch 4b w8 d1+p)
 804     0.8167  0.7200  [4658 LC  206.8 fps]  conv( 4ch 3b w4   +p)  →  conv( 8ch 3b w8 d1+p)  →  conv( 9ch 5b w8 d1+p)
 805    aborted          [4658 LC  123.4 fps]  conv( 6ch 2b w4   +p)  →  conv( 9ch 4b w8 d1+p)  →  conv(12ch 5b w8 d1  )
 806     0.8822  0.8500  [4658 LC  139.1 fps]  conv( 6ch 3b w4   +p)  →  conv( 8ch 4b w8 d1+p)  →  conv(10ch 5b w8 d1  )
 807     0.7552  0.7800  [4658 LC   69.9 fps]  conv( 8ch 4b      +p)  →  conv(12ch 5b w8 d1+p)
 808     0.7346  0.7200  [4661 LC  527.8 fps]  conv( 2ch 2b w4   +p)  →  conv( 6ch 2b w8 d1+p)  →  conv( 8ch 4b w8 d1+p)  →  conv( 9ch 5b w8 d1  )
 809    aborted          [4661 LC  139.1 fps]  conv( 6ch 2b w4   +p)  →  conv( 8ch 2b w8 d1+p)  →  conv(12ch 5b w8 d1+p)
 810     0.6825  0.7200  [4663 LC  805.6 fps]  conv( 2ch 2b w4   +p)  →  conv( 4ch 2b w8 d1+p)  →  conv( 6ch 4b w8 d1+p)  →  conv( 8ch 5b w8 d1+p)
 811     0.8260  0.7700  [4663 LC  373.3 fps]  conv( 2ch 3b w4   +p)  →  conv( 6ch 4b w8 d1+p)  →  conv(12ch 5b w8 d1+p)
 812     0.8114  0.8000  [4666 LC  805.6 fps]  conv( 2ch 2b w4   +p)  →  conv( 4ch 3b w8 d1+p)  →  conv( 8ch 3b w8 d1+p)  →  conv(10ch 3b w8 d1+p)
 813     0.8288  0.8100  [4666 LC  805.6 fps]  conv( 2ch 2b w4   +p)  →  conv( 4ch 4b w8 d1+p)  →  conv( 6ch 5b w8 d1+p)  →  conv( 8ch 5b w8 d1  )
 814     0.8986  0.7200  [4666 LC  139.1 fps]  conv( 6ch 3b w4   +p)  →  conv( 8ch 4b w8 d1+p)  →  conv(12ch 4b w8 d1  )
 815     0.8925  0.8400  [4666 LC   93.3 fps]  conv( 8ch 3b w4   +p)  →  conv( 9ch 3b w8 d1+p)  →  conv(12ch 3b w8 d1  )
 816     0.8342  0.7100  [4669 LC  805.6 fps]  conv( 2ch 3b w4   +p)  →  conv( 4ch 3b w8 d1+p)  →  conv( 8ch 4b w8 d1+p)  →  conv( 9ch 4b w8 d1  )
 817    aborted          [4669 LC  273.3 fps]  conv( 4ch 2b w4   +p)  →  conv( 6ch 2b w8 d1+p)  →  conv( 8ch 2b w8 d1+p)  →  conv( 9ch 4b w8 d1+p)
 818     0.8224  0.8400  [4669 LC  123.4 fps]  conv( 6ch 2b w4   +p)  →  conv( 9ch 3b w8 d1+p)  →  conv(12ch 3b w8 d1+p)
 819     0.9109  0.8600  [4669 LC  110.9 fps]  conv( 6ch 3b w4   +p)  →  conv(10ch 3b w8 d1+p)  →  conv(12ch 5b w8 d1  )
 820     0.8784  0.8600  [4672 LC  184.4 fps]  conv( 4ch 4b      +p)  →  conv( 9ch 4b w8 d1+p)  →  conv(10ch 4b w8 d1  )
 821     0.8280  0.8200  [4674 LC  805.6 fps]  conv( 2ch 2b w4   +p)  →  conv( 4ch 3b w8 d1+p)  →  conv( 8ch 4b w8 d1+p)  →  conv(10ch 5b w8 d1  )
 822     0.8537  0.8300  [4674 LC  493.7 fps]  conv( 2ch 2b w4   +p)  →  conv( 6ch 3b w8 d1+p)  →  conv( 9ch 3b w8 d1+p)  →  conv(12ch 3b w8 d1  )
 823     0.7251  0.6700  [4674 LC  206.8 fps]  conv( 4ch 2b w4   +p)  →  conv( 8ch 2b w8 d1+p)  →  conv(10ch 2b w8 d1+p)  →  conv(12ch 5b w8 d1  )
 824     0.6171  0.7200  [4677 LC  450.2 fps]  conv( 2ch 2b w4   +p)  →  conv( 6ch 2b w8 d1+p)  →  conv(10ch 2b w8 d1+p)  →  conv(12ch 3b w8 d1+p)
 825     0.7746  0.6700  [4677 LC  805.6 fps]  conv( 2ch 3b w4   +p)  →  conv( 4ch 3b w8 d1+p)  →  conv( 6ch 3b w8 d1+p)  →  conv(10ch 4b w8 d1+p)
 826    aborted          [4680 LC  805.6 fps]  conv( 2ch 2b w4   +p)  →  conv( 4ch 2b w8 d1+p)  →  conv( 8ch 2b w8 d1+p)  →  conv( 9ch 2b w8 d1+p)  →  conv(10ch 3b w8 d1  )
 827    aborted          [4680 LC  805.6 fps]  conv( 2ch 2b w4   +p)  →  conv( 4ch 3b w8 d1+p)  →  conv( 6ch 4b w8 d1+p)  →  conv( 8ch 4b w8 d1+p)
 828     0.7442  0.7700  [4683 LC  805.6 fps]  conv( 2ch 2b w4   +p)  →  conv( 4ch 2b w8 d1+p)  →  conv( 6ch 4b w8 d1+p)  →  conv(10ch 4b w8 d1+p)
 829     0.7494  0.6700  [4683 LC  805.6 fps]  conv( 2ch 2b w4   +p)  →  conv( 4ch 3b w8 d1+p)  →  conv( 6ch 3b w8 d1+p)  →  conv( 9ch 5b w8 d1+p)
 830     0.8479  0.8200  [4683 LC  805.6 fps]  conv( 2ch 2b w4   +p)  →  conv( 4ch 3b w8 d1+p)  →  conv( 8ch 4b w8 d1+p)  →  conv(12ch 4b w8 d1  )
 831     0.8644  0.3900  [4683 LC  283.4 fps]  conv( 2ch 5b w4   +p)  →  conv( 8ch 5b w8 d1+p)  →  conv(12ch 5b w8 d1  )
 832     0.5771  0.6100  [4683 LC  273.3 fps]  conv( 4ch 2b w4   +p)  →  conv( 6ch 2b w8 d1+p)  →  conv( 8ch 2b w8 d1+p)  →  conv(12ch 3b w8 d1+p)
 833     0.4123  0.5300  [4685 LC  805.6 fps]  conv( 2ch 2b w4   +p)  →  conv( 4ch 2b w8 d1+p)  →  conv( 6ch 2b w8 d1+p)  →  conv( 9ch 2b w8 d1+p)  →  conv(12ch 5b w8 d1  )
 834     0.8618  0.8300  [4685 LC  665.5 fps]  conv( 2ch 2b w4   +p)  →  conv( 4ch 3b w8 d1+p)  →  conv(10ch 3b w8 d1+p)  →  conv(12ch 5b w8 d1  )
 835     0.8839  0.8400  [4685 LC  527.8 fps]  conv( 2ch 2b w4   +p)  →  conv( 6ch 3b w8 d1+p)  →  conv( 8ch 3b w8 d1+p)  →  conv(12ch 5b w8 d1  )
 836     0.7449  0.1600  [4685 LC  527.8 fps]  conv( 2ch 5b w4   +p)  →  conv( 6ch 5b w8 d1+p)  →  conv( 8ch 5b w8 d1+p)
 837     0.8547  0.7700  [4685 LC  206.8 fps]  conv( 4ch 3b w4   +p)  →  conv( 8ch 5b w8 d1+p)  →  conv( 9ch 5b w8 d1  )
 838     0.6783  0.6300  [4685 LC   74.7 fps]  conv( 9ch 2b w4   +p)  →  conv(10ch 2b w8 d1+p)  →  conv(12ch 3b w8 d1+p)
 839     0.8053  0.7000  [4688 LC  805.6 fps]  conv( 2ch 3b w4   +p)  →  conv( 4ch 3b w8 d1+p)  →  conv( 8ch 3b w8 d1+p)  →  conv( 9ch 3b w8 d1+p)
 840     0.8533  0.8600  [4688 LC  273.3 fps]  conv( 4ch 5b w4   +p)  →  conv( 6ch 5b w8 d1+p)  →  conv(12ch 5b w8 d1  )
 841     0.7445  0.8100  [4691 LC  765.3 fps]  conv( 2ch 2b w4   +p)  →  conv( 4ch 2b w8 d1+p)  →  conv( 9ch 4b w8 d1+p)  →  conv(10ch 5b w8 d1  )
 842     0.8437  0.7200  [4691 LC  283.4 fps]  conv( 2ch 3b w4   +p)  →  conv( 8ch 3b w8 d1+p)  →  conv(12ch 5b w8 d1+p)
 843     0.8852  0.6000  [4691 LC   93.3 fps]  conv( 8ch 3b w4   +p)  →  conv( 9ch 3b w8 d1+p)  →  conv(10ch 4b w8 d1  )
 844     0.8072  0.8300  [4694 LC  373.3 fps]  conv( 2ch 2b w4   +p)  →  conv( 8ch 2b w8 d1+p)  →  conv( 9ch 3b w8 d1+p)  →  conv(10ch 5b w8 d1  )
 845     0.6458  0.6100  [4696 LC  527.8 fps]  conv( 2ch 2b w4   +p)  →  conv( 6ch 2b w8 d1+p)  →  conv( 8ch 3b w8 d1+p)  →  conv(10ch 3b w8 d1+p)
 846     0.8092  0.7800  [4696 LC  273.3 fps]  conv( 4ch 3b w4   +p)  →  conv( 6ch 3b w8 d1+p)  →  conv(12ch 5b w8 d1+p)
 847     0.7787  0.7900  [4696 LC  139.1 fps]  conv( 6ch 2b w4   +p)  →  conv( 8ch 3b w8 d1+p)  →  conv( 9ch 5b w8 d1+p)
 848     0.7845  0.7900  [4699 LC  765.3 fps]  conv( 2ch 2b w4   +p)  →  conv( 4ch 2b w8 d1+p)  →  conv( 9ch 4b w8 d1+p)  →  conv(12ch 4b w8 d1  )
 849     0.8400  0.6600  [4699 LC  493.7 fps]  conv( 2ch 2b w4   +p)  →  conv( 6ch 3b w8 d1+p)  →  conv( 9ch 3b w8 d1+p)  →  conv(10ch 4b w8 d1  )
 850     0.8727  0.4500  [4699 LC  527.8 fps]  conv( 2ch 3b w4   +p)  →  conv( 6ch 3b w8 d1+p)  →  conv( 8ch 3b w8 d1+p)  →  conv(10ch 5b w8 d1  )
 851     0.7446  0.7600  [4699 LC  273.3 fps]  conv( 4ch 2b w4   +p)  →  conv( 6ch 2b w8 d1+p)  →  conv( 9ch 3b w8 d1+p)  →  conv(10ch 5b w8 d1  )
 852     0.6803  0.1600  [4699 LC   93.3 fps]  conv( 8ch 5b w4   +p)  →  conv( 9ch 5b w8 d1+p)
 853     0.8418  0.8300  [4702 LC  373.3 fps]  conv( 2ch 2b w4   +p)  →  conv( 8ch 2b w8 d1+p)  →  conv( 9ch 3b w8 d1+p)  →  conv(12ch 4b w8 d1  )
 854     0.7593  0.7800  [4705 LC  527.8 fps]  conv( 2ch 2b w4   +p)  →  conv( 6ch 2b w8 d1+p)  →  conv( 8ch 4b w8 d1+p)  →  conv(10ch 5b w8 d1  )
 855     0.7609  0.8100  [4705 LC  493.7 fps]  conv( 2ch 4b      +p)  →  conv( 6ch 5b w8 d1+p)  →  conv( 9ch 5b w8 d1+p)
 856     0.8566  0.8000  [4707 LC  805.6 fps]  conv( 2ch 3b w4   +p)  →  conv( 4ch 3b w8 d1+p)  →  conv( 8ch 4b w8 d1+p)  →  conv(10ch 4b w8 d1  )
 857     0.8900  0.7400  [4707 LC  665.5 fps]  conv( 2ch 3b w4   +p)  →  conv( 4ch 3b w8 d1+p)  →  conv(10ch 3b w8 d1+p)  →  conv(12ch 4b w8 d1  )
 858     0.9074  0.8400  [4707 LC  527.8 fps]  conv( 2ch 3b w4   +p)  →  conv( 6ch 3b w8 d1+p)  →  conv( 8ch 3b w8 d1+p)  →  conv(12ch 4b w8 d1  )
 859     0.8257  0.8200  [4707 LC  273.3 fps]  conv( 4ch 2b w4   +p)  →  conv( 6ch 2b w8 d1+p)  →  conv( 9ch 3b w8 d1+p)  →  conv(12ch 4b w8 d1  )
 860    aborted          [4710 LC  805.6 fps]  conv( 2ch 2b w4   +p)  →  conv( 4ch 2b w8 d1+p)  →  conv( 6ch 2b w8 d1+p)  →  conv( 8ch 3b w8 d1+p)  →  conv( 9ch 3b w8 d1  )
 861     0.7186  0.7300  [4710 LC  805.6 fps]  conv( 2ch 2b w4   +p)  →  conv( 4ch 2b w8 d1+p)  →  conv( 8ch 3b w8 d1+p)  →  conv(10ch 4b w8 d1+p)
 862     0.8135  0.8200  [4710 LC  805.6 fps]  conv( 2ch 2b w4   +p)  →  conv( 4ch 4b w8 d1+p)  →  conv( 6ch 5b w8 d1+p)  →  conv( 9ch 5b w8 d1  )
 863     0.7647  0.8100  [4713 LC  527.8 fps]  conv( 2ch 2b w4   +p)  →  conv( 6ch 2b w8 d1+p)  →  conv( 8ch 4b w8 d1+p)  →  conv(12ch 4b w8 d1  )
 864     0.5861  0.6300  [4713 LC  184.4 fps]  conv( 4ch 2b w4   +p)  →  conv( 9ch 2b w8 d1+p)  →  conv(10ch 2b w8 d1+p)  →  conv(12ch 4b w8 d1  )
 865     0.8014  0.7800  [4713 LC  273.3 fps]  conv( 4ch 4b      +p)  →  conv( 6ch 4b w8 d1+p)  →  conv( 8ch 5b w8 d1+p)
 866    aborted          [4713 LC  139.1 fps]  conv( 6ch 2b w4   +p)  →  conv( 8ch 2b w8 d1+p)  →  conv( 9ch 2b w8 d1+p)  →  conv(10ch 5b w8 d1  )
 867     0.7279  0.7700  [4716 LC  450.2 fps]  conv( 2ch 2b w4   +p)  →  conv( 6ch 2b w8 d1+p)  →  conv(10ch 3b w8 d1+p)  →  conv(12ch 5b w8 d1  )
 868     0.8481  0.8200  [4721 LC  184.4 fps]  conv( 4ch 3b w4   +p)  →  conv( 9ch 3b w8 d1+p)  →  conv(10ch 4b w8 d1+p)
 869     0.6259  0.6400  [4721 LC  139.1 fps]  conv( 6ch 2b w4   +p)  →  conv( 8ch 2b w8 d1+p)  →  conv( 9ch 2b w8 d1+p)  →  conv(12ch 4b w8 d1  )
 870     0.4063  0.4900  [4724 LC  805.6 fps]  conv( 2ch 2b w4   +p)  →  conv( 4ch 2b w8 d1+p)  →  conv( 6ch 2b w8 d1+p)  →  conv(10ch 2b w8 d1+p)  →  conv(12ch 4b w8 d1  )
 871     0.8001  0.7800  [4724 LC  184.4 fps]  conv( 4ch 2b w4   +p)  →  conv( 9ch 3b w8 d1+p)  →  conv(12ch 4b w8 d1+p)
 872     0.7848  0.7900  [4724 LC  139.1 fps]  conv( 6ch 2b w4   +p)  →  conv( 8ch 5b w8 d1+p)  →  conv( 9ch 5b w8 d1  )
 873     0.8634  0.8500  [4724 LC   74.7 fps]  conv( 9ch 2b w4   +p)  →  conv(10ch 3b w8 d1+p)  →  conv(12ch 5b w8 d1  )
 874     0.8148  0.7400  [4726 LC  450.2 fps]  conv( 2ch 3b w4   +p)  →  conv( 6ch 5b w8 d1+p)  →  conv(10ch 5b w8 d1+p)
 875     0.7699  0.7400  [4726 LC  340.1 fps]  conv( 2ch 4b      +p)  →  conv( 8ch 4b w8 d1+p)  →  conv(10ch 4b w8 d1+p)
 876     0.8039  0.8100  [4729 LC  283.4 fps]  conv( 2ch 2b w4   +p)  →  conv( 8ch 4b w8 d1+p)  →  conv(12ch 4b w8 d1+p)
 877     0.7689  0.7200  [4729 LC  373.3 fps]  conv( 2ch 3b w4   +p)  →  conv( 8ch 4b w8 d1+p)  →  conv( 9ch 5b w8 d1+p)
 878     0.8489  0.8500  [4729 LC  206.8 fps]  conv( 4ch 3b w4   +p)  →  conv( 8ch 5b w8 d1+p)  →  conv(10ch 5b w8 d1  )
 879     0.8355  0.6500  [4732 LC  805.6 fps]  conv( 2ch 3b w4   +p)  →  conv( 4ch 3b w8 d1+p)  →  conv( 8ch 4b w8 d1+p)  →  conv( 9ch 5b w8 d1  )
 880     0.8841  0.8300  [4732 LC  805.6 fps]  conv( 2ch 4b      +p)  →  conv( 4ch 4b w8 d1+p)  →  conv( 6ch 4b w8 d1+p)  →  conv(12ch 5b w8 d1  )
 881     0.8559  0.8300  [4732 LC  273.3 fps]  conv( 4ch 2b w4   +p)  →  conv( 6ch 3b w8 d1+p)  →  conv( 8ch 3b w8 d1+p)  →  conv( 9ch 4b w8 d1  )
 882     0.8571  0.7700  [4732 LC  273.3 fps]  conv( 4ch 3b w4   +p)  →  conv( 6ch 4b w8 d1+p)  →  conv(12ch 4b w8 d1+p)
 883     0.8319  0.8600  [4732 LC  273.3 fps]  conv( 4ch 4b      +p)  →  conv( 6ch 4b w8 d1+p)  →  conv(10ch 4b w8 d1+p)
 884     0.8759  0.7400  [4735 LC  805.6 fps]  conv( 2ch 3b w4   +p)  →  conv( 4ch 3b w8 d1+p)  →  conv( 6ch 5b w8 d1+p)  →  conv(12ch 5b w8 d1  )
 885     0.6225  0.6400  [4737 LC  139.1 fps]  conv( 6ch 2b w4   +p)  →  conv( 8ch 2b w8 d1+p)  →  conv(10ch 2b w8 d1+p)  →  conv(12ch 3b w8 d1  )
 886     0.4823  0.4600  [4740 LC  805.6 fps]  conv( 2ch 2b w4   +p)  →  conv( 4ch 2b w8 d1+p)  →  conv( 6ch 2b w8 d1+p)  →  conv( 8ch 3b w8 d1+p)  →  conv(10ch 3b w8 d1  )
 887     0.3399  0.4500  [4740 LC  805.6 fps]  conv( 2ch 2b w4   +p)  →  conv( 4ch 2b w8 d1+p)  →  conv( 8ch 2b w8 d1+p)  →  conv( 9ch 2b w8 d1+p)  →  conv(12ch 3b w8 d1  )
 888     0.6314  0.6400  [4740 LC  665.5 fps]  conv( 2ch 2b w4   +p)  →  conv( 4ch 2b w8 d1+p)  →  conv(10ch 2b w8 d1+p)  →  conv(12ch 4b w8 d1+p)
 889     0.6020  0.6300  [4740 LC  527.8 fps]  conv( 2ch 2b w4   +p)  →  conv( 6ch 2b w8 d1+p)  →  conv( 8ch 2b w8 d1+p)  →  conv(12ch 4b w8 d1+p)
 890     0.7544  0.7300  [4740 LC  273.3 fps]  conv( 4ch 2b w4   +p)  →  conv( 6ch 5b w8 d1+p)  →  conv( 9ch 5b w8 d1+p)
 891     0.8715  0.8400  [4740 LC  184.4 fps]  conv( 4ch 4b      +p)  →  conv( 9ch 4b w8 d1+p)  →  conv(10ch 5b w8 d1  )
 892     0.8079  0.8100  [4743 LC  300.1 fps]  conv( 2ch 2b w4   +p)  →  conv( 9ch 4b w8 d1+p)  →  conv(10ch 4b w8 d1+p)
 893     0.4772  0.2900  [4746 LC  250.9 fps]  conv( 2ch 3b w4   +p)  →  conv( 9ch 5b w8 d1+p)  →  conv(12ch 5b w8 d1  )
 894     0.8888  0.8000  [4746 LC  273.3 fps]  conv( 4ch 2b w4   +p)  →  conv( 6ch 3b w8 d1+p)  →  conv( 8ch 3b w8 d1+p)  →  conv(12ch 3b w8 d1  )
 895     0.8933  0.8400  [4746 LC  139.1 fps]  conv( 6ch 3b w4   +p)  →  conv( 8ch 4b w8 d1+p)  →  conv(12ch 5b w8 d1  )
 896     0.7298  0.7500  [4746 LC   93.3 fps]  conv( 8ch 2b w4   +p)  →  conv( 9ch 2b w8 d1+p)  →  conv(12ch 4b w8 d1+p)
 897     0.8660  0.9000  [4746 LC   93.3 fps]  conv( 8ch 2b w4   +p)  →  conv( 9ch 4b w8 d1+p)  →  conv(10ch 4b w8 d1  )
 898     0.5361  0.4200  [4748 LC  300.1 fps]  conv( 2ch 2b w4   +p)  →  conv( 9ch 2b w8 d1+p)  →  conv(10ch 2b w8 d1+p)  →  conv(12ch 2b w8 d1+p)
 899     0.8208  0.8000  [4748 LC  184.4 fps]  conv( 4ch 2b w4   +p)  →  conv( 9ch 3b w8 d1+p)  →  conv(10ch 5b w8 d1+p)
 900     0.8878  0.9000  [4748 LC  184.4 fps]  conv( 4ch 4b      +p)  →  conv( 9ch 4b w8 d1+p)  →  conv(12ch 4b w8 d1  )
 901     0.8393  0.8300  [4754 LC  805.6 fps]  conv( 2ch 2b w4   +p)  →  conv( 4ch 4b w8 d1+p)  →  conv( 6ch 5b w8 d1+p)  →  conv(10ch 5b w8 d1  )
 902     0.8277  0.7700  [4754 LC  340.1 fps]  conv( 2ch 2b w4   +p)  →  conv( 8ch 4b w8 d1+p)  →  conv(10ch 5b w8 d1+p)
 903     0.8617  0.8000  [4754 LC  225.1 fps]  conv( 2ch 3b w4   +p)  →  conv(10ch 3b w8 d1+p)  →  conv(12ch 4b w8 d1+p)
 904     0.4651  0.4100  [4754 LC  206.8 fps]  conv( 4ch 2b w4   +p)  →  conv( 8ch 2b w8 d1+p)  →  conv( 9ch 2b w8 d1+p)  →  conv(12ch 2b w8 d1+p)
 905     0.8527  0.8700  [4754 LC   93.3 fps]  conv( 8ch 2b w4   +p)  →  conv( 9ch 3b w8 d1+p)  →  conv(10ch 3b w8 d1+p)
 906     0.8064  0.7200  [4757 LC  273.3 fps]  conv( 4ch 3b w4   +p)  →  conv( 6ch 4b w8 d1+p)  →  conv(10ch 5b w8 d1+p)
 907     0.8127  0.7800  [4759 LC  250.9 fps]  conv( 2ch 2b w4   +p)  →  conv( 9ch 3b w8 d1+p)  →  conv(12ch 5b w8 d1+p)
 908     0.8183  0.7400  [4759 LC  206.8 fps]  conv( 4ch 3b w4   +p)  →  conv( 8ch 3b w8 d1+p)  →  conv(12ch 4b w8 d1+p)
 909     0.8353  0.7900  [4759 LC  123.4 fps]  conv( 6ch 2b w4   +p)  →  conv( 9ch 3b w8 d1+p)  →  conv(10ch 4b w8 d1+p)
 910     0.8572  0.5000  [4759 LC   93.3 fps]  conv( 8ch 3b w4   +p)  →  conv( 9ch 3b w8 d1+p)  →  conv(10ch 5b w8 d1  )
 911     0.8335  0.6600  [4762 LC  805.6 fps]  conv( 2ch 2b w4   +p)  →  conv( 4ch 3b w8 d1+p)  →  conv( 8ch 4b w8 d1+p)  →  conv(12ch 5b w8 d1  )
 912     0.8015  0.8100  [4762 LC  300.1 fps]  conv( 2ch 4b      +p)  →  conv( 9ch 5b w8 d1+p)  →  conv(10ch 5b w8 d1  )
 913     0.8426  0.8800  [4762 LC  206.8 fps]  conv( 4ch 2b w4   +p)  →  conv( 8ch 4b w8 d1+p)  →  conv(10ch 4b w8 d1+p)
 914     0.8700  0.8500  [4762 LC  164.6 fps]  conv( 4ch 3b w4   +p)  →  conv(10ch 4b w8 d1+p)  →  conv(12ch 4b w8 d1  )
 915     0.3977  0.4300  [4765 LC  805.6 fps]  conv( 2ch 2b w4   +p)  →  conv( 4ch 2b w8 d1+p)  →  conv( 8ch 2b w8 d1+p)  →  conv( 9ch 2b w8 d1+p)  →  conv(10ch 4b w8 d1  )
 916     0.5367  0.6500  [4765 LC  527.8 fps]  conv( 2ch 2b w4   +p)  →  conv( 6ch 2b w8 d1+p)  →  conv( 8ch 2b w8 d1+p)  →  conv(10ch 5b w8 d1+p)
 917     0.8662  0.8600  [4768 LC  493.7 fps]  conv( 2ch 2b w4   +p)  →  conv( 6ch 3b w8 d1+p)  →  conv( 9ch 3b w8 d1+p)  →  conv(10ch 5b w8 d1  )
 918     0.7902  0.4200  [4768 LC  805.6 fps]  conv( 2ch 3b w4   +p)  →  conv( 4ch 3b w8 d1+p)  →  conv( 8ch 3b w8 d1+p)  →  conv(10ch 3b w8 d1+p)
 919     0.8467  0.7700  [4768 LC  805.6 fps]  conv( 2ch 3b w4   +p)  →  conv( 4ch 4b w8 d1+p)  →  conv( 6ch 5b w8 d1+p)  →  conv( 8ch 5b w8 d1  )
 920     0.8569  0.7800  [4768 LC  373.3 fps]  conv( 2ch 4b      +p)  →  conv( 6ch 4b w8 d1+p)  →  conv(12ch 5b w8 d1+p)
 921     0.8095  0.8300  [4768 LC  139.1 fps]  conv( 6ch 2b w4   +p)  →  conv( 8ch 5b w8 d1+p)  →  conv(10ch 5b w8 d1  )
 922     0.9064  0.8200  [4768 LC   93.3 fps]  conv( 8ch 3b w4   +p)  →  conv( 9ch 3b w8 d1+p)  →  conv(12ch 4b w8 d1  )
 923     0.7849  0.7800  [4770 LC  340.1 fps]  conv( 2ch 2b w4   +p)  →  conv( 8ch 2b w8 d1+p)  →  conv(10ch 3b w8 d1+p)  →  conv(12ch 3b w8 d1  )
 924     0.8651  0.7800  [4770 LC  273.3 fps]  conv( 4ch 2b w4   +p)  →  conv( 6ch 3b w8 d1+p)  →  conv( 8ch 3b w8 d1+p)  →  conv(10ch 4b w8 d1  )
 925     0.5656  0.6100  [4770 LC   93.3 fps]  conv( 8ch 2b w4   +p)  →  conv( 9ch 2b w8 d1+p)  →  conv(10ch 5b w8 d1+p)
 926    aborted          [4773 LC  805.6 fps]  conv( 2ch 2b w4   +p)  →  conv( 4ch 2b w8 d1+p)  →  conv( 8ch 2b w8 d1+p)  →  conv(10ch 2b w8 d1+p)  →  conv(12ch 2b w8 d1  )
 927     0.6190  0.7000  [4773 LC  273.3 fps]  conv( 4ch 2b w4   +p)  →  conv( 6ch 2b w8 d1+p)  →  conv( 8ch 2b w8 d1+p)  →  conv(10ch 4b w8 d1+p)
 928     0.8056  0.8500  [4776 LC  805.6 fps]  conv( 2ch 2b w4   +p)  →  conv( 4ch 4b w8 d1+p)  →  conv( 8ch 4b w8 d1+p)  →  conv( 9ch 4b w8 d1  )
 929     0.8573  0.7800  [4776 LC  493.7 fps]  conv( 2ch 2b w4   +p)  →  conv( 6ch 3b w8 d1+p)  →  conv( 9ch 3b w8 d1+p)  →  conv(12ch 4b w8 d1  )
 930     0.8634  0.5900  [4776 LC  805.6 fps]  conv( 2ch 3b w4   +p)  →  conv( 4ch 3b w8 d1+p)  →  conv( 8ch 4b w8 d1+p)  →  conv(10ch 5b w8 d1  )
 931     0.8977  0.7900  [4776 LC  493.7 fps]  conv( 2ch 3b w4   +p)  →  conv( 6ch 3b w8 d1+p)  →  conv( 9ch 3b w8 d1+p)  →  conv(12ch 3b w8 d1  )
 932     0.8000  0.7600  [4776 LC  273.3 fps]  conv( 4ch 2b w4   +p)  →  conv( 6ch 2b w8 d1+p)  →  conv(10ch 3b w8 d1+p)  →  conv(12ch 3b w8 d1  )
 933     0.7650  0.8500  [4779 LC  765.3 fps]  conv( 2ch 2b w4   +p)  →  conv( 4ch 2b w8 d1+p)  →  conv( 9ch 4b w8 d1+p)  →  conv(12ch 5b w8 d1  )
 934     0.7519  0.8100  [4779 LC  123.4 fps]  conv( 6ch 2b w4   +p)  →  conv( 9ch 2b w8 d1+p)  →  conv(12ch 5b w8 d1+p)
 935     0.5833  0.5900  [4781 LC  805.6 fps]  conv( 2ch 2b w4   +p)  →  conv( 4ch 2b w8 d1+p)  →  conv( 8ch 2b w8 d1+p)  →  conv(12ch 5b w8 d1+p)
 936     0.8340  0.8400  [4781 LC  373.3 fps]  conv( 2ch 2b w4   +p)  →  conv( 8ch 2b w8 d1+p)  →  conv( 9ch 3b w8 d1+p)  →  conv(12ch 5b w8 d1  )
 937     0.8155  0.6100  [4781 LC  805.6 fps]  conv( 2ch 3b w4   +p)  →  conv( 4ch 3b w8 d1+p)  →  conv( 6ch 4b w8 d1+p)  →  conv( 8ch 4b w8 d1+p)
 938     0.7859  0.7500  [4781 LC  206.8 fps]  conv( 4ch 2b w4   +p)  →  conv( 8ch 2b w8 d1+p)  →  conv( 9ch 3b w8 d1+p)  →  conv(10ch 3b w8 d1  )
 939     0.8114  0.7700  [4784 LC  805.6 fps]  conv( 2ch 2b w4   +p)  →  conv( 4ch 3b w8 d1+p)  →  conv( 6ch 3b w8 d1+p)  →  conv(12ch 4b w8 d1+p)
 940     0.7556  0.7000  [4784 LC  805.6 fps]  conv( 2ch 2b w4   +p)  →  conv( 4ch 3b w8 d1+p)  →  conv( 6ch 4b w8 d1+p)  →  conv( 9ch 4b w8 d1+p)
 941     0.7721  0.5100  [4784 LC  805.6 fps]  conv( 2ch 3b w4   +p)  →  conv( 4ch 3b w8 d1+p)  →  conv( 6ch 3b w8 d1+p)  →  conv( 9ch 5b w8 d1+p)
 942     0.8606  0.7600  [4784 LC  805.6 fps]  conv( 2ch 3b w4   +p)  →  conv( 4ch 3b w8 d1+p)  →  conv( 8ch 4b w8 d1+p)  →  conv(12ch 4b w8 d1  )
 943     0.8352  0.7900  [4784 LC  206.8 fps]  conv( 4ch 3b w4   +p)  →  conv( 8ch 3b w8 d1+p)  →  conv(10ch 5b w8 d1+p)
 944     0.4763  0.5400  [4787 LC  805.6 fps]  conv( 2ch 2b w4   +p)  →  conv( 4ch 2b w8 d1+p)  →  conv( 6ch 2b w8 d1+p)  →  conv( 8ch 3b w8 d1+p)  →  conv( 9ch 4b w8 d1  )
 945     0.8936  0.8500  [4787 LC  665.5 fps]  conv( 2ch 3b w4   +p)  →  conv( 4ch 3b w8 d1+p)  →  conv(10ch 3b w8 d1+p)  →  conv(12ch 5b w8 d1  )
 946     0.8845  0.6300  [4787 LC  527.8 fps]  conv( 2ch 3b w4   +p)  →  conv( 6ch 3b w8 d1+p)  →  conv( 8ch 3b w8 d1+p)  →  conv(12ch 5b w8 d1  )
 947     0.8210  0.8100  [4787 LC  273.3 fps]  conv( 4ch 2b w4   +p)  →  conv( 6ch 2b w8 d1+p)  →  conv( 9ch 3b w8 d1+p)  →  conv(12ch 5b w8 d1  )
 948     0.6774  0.8200  [4790 LC  805.6 fps]  conv( 2ch 2b w4   +p)  →  conv( 4ch 2b w8 d1+p)  →  conv( 6ch 4b w8 d1+p)  →  conv( 9ch 5b w8 d1+p)
 949     0.7215  0.7400  [4790 LC  765.3 fps]  conv( 2ch 2b w4   +p)  →  conv( 4ch 2b w8 d1+p)  →  conv( 9ch 3b w8 d1+p)  →  conv(12ch 3b w8 d1+p)
 950     0.7960  0.8000  [4792 LC  527.8 fps]  conv( 2ch 2b w4   +p)  →  conv( 6ch 2b w8 d1+p)  →  conv( 8ch 4b w8 d1+p)  →  conv(12ch 5b w8 d1  )
 951     0.6952  0.7400  [4792 LC  184.4 fps]  conv( 4ch 2b w4   +p)  →  conv( 9ch 2b w8 d1+p)  →  conv(10ch 2b w8 d1+p)  →  conv(12ch 5b w8 d1  )
 952     0.6476  0.7000  [4795 LC  373.3 fps]  conv( 2ch 2b w4   +p)  →  conv( 8ch 2b w8 d1+p)  →  conv( 9ch 2b w8 d1+p)  →  conv(12ch 3b w8 d1+p)
 953     0.8642  0.6700  [4795 LC  273.3 fps]  conv( 4ch 2b w4   +p)  →  conv( 6ch 3b w8 d1+p)  →  conv( 8ch 3b w8 d1+p)  →  conv( 9ch 5b w8 d1  )
 954     0.8554  0.5200  [4795 LC  139.1 fps]  conv( 6ch 3b w4   +p)  →  conv( 8ch 3b w8 d1+p)  →  conv( 9ch 4b w8 d1+p)
 955     0.7978  0.8600  [4798 LC  184.4 fps]  conv( 4ch 2b w4   +p)  →  conv( 9ch 5b w8 d1+p)  →  conv(10ch 5b w8 d1  )
 956     0.8210  0.8400  [4798 LC  139.1 fps]  conv( 6ch 2b w4   +p)  →  conv( 8ch 3b w8 d1+p)  →  conv(12ch 4b w8 d1+p)
 957     0.5445  0.6100  [4801 LC  805.6 fps]  conv( 2ch 2b w4   +p)  →  conv( 4ch 2b w8 d1+p)  →  conv( 6ch 2b w8 d1+p)  →  conv( 8ch 3b w8 d1+p)  →  conv(12ch 3b w8 d1  )
 958     0.8505  0.5800  [4801 LC  493.7 fps]  conv( 2ch 3b w4   +p)  →  conv( 6ch 3b w8 d1+p)  →  conv( 9ch 3b w8 d1+p)  →  conv(10ch 4b w8 d1  )
 959     0.5062  0.4500  [4801 LC  273.3 fps]  conv( 4ch 2b w4   +p)  →  conv( 6ch 2b w8 d1+p)  →  conv( 9ch 2b w8 d1+p)  →  conv(12ch 3b w8 d1+p)
 960     0.8566  0.6600  [4801 LC  164.6 fps]  conv( 4ch 3b w4   +p)  →  conv(10ch 3b w8 d1+p)  →  conv(12ch 3b w8 d1+p)
 961     0.6323  0.6800  [4801 LC  139.1 fps]  conv( 6ch 2b w4   +p)  →  conv( 8ch 2b w8 d1+p)  →  conv( 9ch 2b w8 d1+p)  →  conv(12ch 5b w8 d1  )
 962     0.8785  0.9100  [4801 LC  110.9 fps]  conv( 6ch 2b w4   +p)  →  conv(10ch 4b w8 d1+p)  →  conv(12ch 4b w8 d1  )
 963    aborted          [4803 LC  805.6 fps]  conv( 2ch 2b w4   +p)  →  conv( 4ch 2b w8 d1+p)  →  conv( 6ch 2b w8 d1+p)  →  conv(10ch 2b w8 d1+p)  →  conv(12ch 5b w8 d1  )
 964     0.8607  0.8800  [4803 LC  273.3 fps]  conv( 4ch 2b w4   +p)  →  conv( 6ch 4b w8 d1+p)  →  conv(12ch 5b w8 d1+p)
