Brmanzo/esp-computer-vision/sim/unit_testing/classifier_layer/test_cases.csv

TermBits | TermCount | BusBits | InChannels | ClassCount | WeightBits | BiasBits | Unsigned | DSPCount | Seed
1 | 16 | 8 | 4 | 2 | 2 | 2 | 0 | 0 | 1234
1 | 32 | 8 | 8 | 10 | 2 | 2 | 1 | 0 | 1234
2 | 64 | 8 | 16 | 10 | 4 | 4 | 0 | 0 | 1234
4 | 128 | 8 | 24 | 10 | 5 | 8 | 1 | 0 | 1234
8 | 256 | 8 | 32 | 10 | 8 | 16 | 0 | 0 | 1234
8 | 32 | 8 | 4 | 2 | 8 | 16 | 0 | 0 | 1234
