Brmanzo/esp-computer-vision/sim/integration_testing/single_block_with_classifier/test_cases.csv

C0_LineWidthPx | C0_LineCountPx | C0_InBits | C0_WeightBits | C0_BiasBits | C0_KernelWidth | C0_InChannels | C0_OutChannels | C0_Stride | C0_Unsigned | C0_Padding | C0_OutBits | C0_ShiftBits | P0_KernelWidth | P0_Mode | C1_WeightBits | C1_BiasBits | C1_KernelWidth | C1_OutChannels | C1_Stride | C1_Padding | C1_OutBits | C1_ShiftBits | P1_KernelWidth | P1_Mode | ClassCount | BusBits | ClassWeightBits | ClassBiasBits
12 | 8 | 1 | 2 | 8 | 3 | 1 | 2 | 1 | 0 | 1 | AUTO | 0 | 2 | 0 | 2 | 8 | 3 | 4 | 1 | 1 | 4 | 2 | 2 | 0 | 10 | 8 | 2 | 8
24 | 18 | 1 | 2 | 8 | 3 | 1 | 4 | 1 | 1 | 1 | AUTO | 0 | 2 | 0 | 2 | 8 | 3 | 8 | 1 | 1 | 7 | 4 | 2 | 0 | 10 | 8 | 2 | 8
