Brmanzo/esp-computer-vision/sim/unit_testing/classifier_layer/test_cases_dsps.csv

TermBits | TermCount | BusBits | InChannels | ClassCount | WeightBits | BiasBits | Unsigned | DSPCount | Seed
1 | 16 | 8 | 4 | 2 | 2 | 2 | 0 | 1 | 1234
1 | 32 | 8 | 8 | 10 | 2 | 2 | 1 | 2 | 1234
2 | 64 | 8 | 16 | 12 | 4 | 4 | 0 | 4 | 1234
4 | 128 | 8 | 16 | 8 | 5 | 8 | 1 | 8 | 1234
