Brmanzo/esp-computer-vision/sim/integration_testing/single_block/test_cases.csv

C_LineWidthPx | C_LineCountPx | C_InBits | C_WeightBits | C_BiasBits | C_KernelWidth | C_InChannels | C_OutBits | C_ShiftBits | C_Unsigned | P_KernelWidth | C_OutChannels | C_Padding | P_Mode
12 | 8 | 2 | 2 | 8 | 3 | 1 | AUTO | 0 | 0 | 2 | 1 | 1 | 0
12 | 8 | 4 | 4 | 8 | 3 | 4 | 4 | 3 | 1 | 2 | 4 | 1 | 0
