Brmanzo/esp-computer-vision/sim/unit_testing/filter/test_cases.csv

InBits | WeightBits | BiasBits | KernelWidth | InChannels | Unsigned | AccBits | OutBits
1 | 2 | 8 | 1 | 1 | 0 | AUTO | AUTO
1 | 2 | 8 | 3 | 1 | 0 | AUTO | 1
1 | 2 | 8 | 2 | 2 | 0 | AUTO | AUTO
1 | 3 | 8 | 3 | 1 | 0 | AUTO | 1
4 | 2 | 8 | 1 | 1 | 1 | AUTO | AUTO
4 | 2 | 8 | 3 | 1 | 0 | AUTO | AUTO
8 | 2 | 8 | 4 | 1 | 1 | AUTO | AUTO
8 | 2 | 8 | 3 | 2 | 0 | AUTO | 1
8 | 2 | 8 | 3 | 16 | 1 | AUTO | 1
1 | 2 | 8 | 3 | 32 | 0 | AUTO | AUTO
8 | 8 | 8 | 3 | 4 | 1 | AUTO | 8
