Brmanzo/esp-computer-vision/sim/unit_testing/mac/test_cases.csv

InBits | WeightBits | TermCount | Unsigned | OutBits
1 | 1 | 4 | 0 | AUTO
1 | 2 | 1 | 1 | AUTO
1 | 2 | 2 | 1 | AUTO
1 | 2 | 3 | 0 | AUTO
1 | 3 | 32 | 0 | AUTO
8 | 2 | 5 | 0 | AUTO
8 | 2 | 16 | 1 | AUTO
8 | 2 | 32 | 0 | AUTO
8 | 8 | 16 | 0 | AUTO
