Brmanzo/esp-computer-vision/sim/unit_testing/pool_layer/test_cases_avg.csv

LineWidthPx | LineCountPx | KernelWidth | Unsigned | InBits | InChannels | PoolMode
16 | 16 | 2 | 0 | 1 | 8 | 1
16 | 16 | 2 | 0 | 8 | 4 | 1
16 | 16 | 4 | 1 | 1 | 9 | 1
