Brmanzo/esp-computer-vision/sim/unit_testing/pool_layer/test_cases_max.csv

LineWidthPx | LineCountPx | KernelWidth | InBits | Unsigned | InChannels | PoolMode
16 | 16 | 2 | 1 | 0 | 8 | 0
16 | 16 | 4 | 1 | 0 | 9 | 0
16 | 16 | 4 | 8 | 1 | 4 | 0
