Brmanzo/esp-computer-vision/sim/unit_testing/global_max/test_cases.csv

InBits | TermCount | InChannels | Unsigned
1 | 16 | 10 | 0
8 | 9 | 1 | 1
16 | 17 | 2 | 1
32 | 33 | 4 | 1
8 | 10 | 1 | 0
