Brmanzo/esp-computer-vision/sim/unit_testing/linear_layer/test_cases_dsps.csv

InBits | WeightBits | InChannels | OutBits | OutChannels | BiasBits | DSPCount | Unsigned
2 | 2 | 1 | AUTO | 2 | 2 | 1 | 0
2 | 2 | 1 | AUTO | 2 | 2 | 2 | 1
2 | 2 | 2 | 1 | 4 | 3 | 1 | 0
2 | 2 | 2 | 1 | 4 | 3 | 2 | 0
2 | 2 | 2 | 1 | 4 | 3 | 4 | 1
