Brmanzo/esp-computer-vision/sim/unit_testing/linear_layer/test_cases_width.csv

InBits | WeightBits | InChannels | OutBits | OutChannels | BiasBits | DSPCount | Unsigned
1 | 2 | 1 | AUTO | 2 | 2 | 0 | 0
2 | 3 | 1 | AUTO | 2 | 3 | 0 | 1
4 | 5 | 1 | AUTO | 2 | 5 | 0 | 0
8 | 8 | 1 | AUTO | 2 | 8 | 0 | 0
8 | 8 | 1 | 1 | 2 | 8 | 0 | 0
