Brmanzo/esp-computer-vision/sim/unit_testing/icestorm_rom/test_cases.csv

Width | Depth
8 | 8
8 | 256
1 | 8
11 | 17
