Brmanzo/esp-computer-vision/sim/unit_testing/neuron/test_cases_width.csv

InBits | WeightBits | InChannels | OutBits | BiasBits
1 | 2 | 1 | AUTO | 2
1 | 2 | 1 | 1 | 2
2 | 2 | 1 | 1 | 2
2 | 3 | 1 | 2 | 3
4 | 5 | 1 | AUTO | 5
8 | 8 | 1 | AUTO | 8
13 | 2 | 16 | AUTO | 32
