Brmanzo/esp-computer-vision/sim/unit_testing/adder_tree/test_cases.csv

InBits | AddendCount | OutBits
1 | 2 | AUTO
1 | 4 | AUTO
2 | 1 | AUTO
2 | 2 | AUTO
2 | 3 | AUTO
4 | 5 | AUTO
8 | 8 | AUTO
8 | 16 | AUTO
8 | 32 | AUTO
