Brmanzo/esp-computer-vision/sim/unit_testing/comparator_tree/test_cases.csv

InBits | ClassCount
1 | 2
1 | 8
2 | 1
2 | 2
2 | 3
4 | 5
8 | 8
8 | 16
8 | 32
