Brmanzo/esp-computer-vision/sim/unit_testing/deframer/test_cases.csv

UnpackedWidth | PackedNum | PacketLenElems
1 | 8 | 10
1 | 16 | 16
2 | 4 | 10
