Brmanzo/esp-computer-vision/sim/unit_testing/framer/test_cases.csv

UnpackedWidth | PackedNum | PacketLenElems
1 | 8 | 124
1 | 16 | 128
2 | 4 | 124
