Brmanzo/esp-computer-vision/sim/unit_testing/icestorm_ram/test_cases.csv

Width | Depth
1 | 8
8 | 8
8 | 256
11 | 17
