Brmanzo/esp-computer-vision/sim/unit_testing/packer/test_cases.csv

UnpackedWidth | PackedNum
1 | 8
1 | 16
2 | 4
4 | 4
