Brmanzo/esp-computer-vision/sim/unit_testing/skid_buffer/test_cases.csv

Width | Depth | HeadRoom
1 | 16 | 4
8 | 16 | 4
8 | 32 | 8
32 | 64 | 8
