Brmanzo/esp-computer-vision/sim/unit_testing/conv_layer/test_cases_channels.csv

InBits | WeightBits | OutBits | KernelWidth | LineWidthPx | LineCountPx | InChannels | OutChannels | BiasBits | Stride | Padding | DSPCount | Unsigned | ShiftBits
1 | 2 | 1 | 3 | 16 | 12 | 1 | 1 | 8 | 1 | 1 | 0 | 0 | 0
1 | 2 | 1 | 3 | 16 | 12 | 16 | 8 | 8 | 1 | 1 | 0 | 0 | 0
1 | 2 | 1 | 3 | 16 | 12 | 17 | 8 | 8 | 1 | 1 | 0 | 0 | 0
1 | 2 | 1 | 3 | 16 | 12 | 8 | 8 | 8 | 1 | 1 | 0 | 0 | 0
1 | 2 | AUTO | 3 | 16 | 12 | 4 | 16 | 8 | 1 | 1 | 0 | 0 | 0
4 | 5 | AUTO | 3 | 16 | 12 | 4 | 5 | 8 | 1 | 1 | 0 | 0 | 0
