Brmanzo/esp-computer-vision/sim/unit_testing/conv_layer/test_cases_out_act.csv

InBits | WeightBits | OutBits | KernelWidth | LineWidthPx | LineCountPx | InChannels | OutChannels | BiasBits | Stride | Padding | DSPCount | ShiftBits | Unsigned | TruncGuard
1 | 2 | 2 | 3 | 16 | 12 | 1 | 1 | 8 | 1 | 1 | 0 | 2 | 0 | 0
1 | 3 | 3 | 3 | 16 | 12 | 1 | 1 | 8 | 1 | 1 | 0 | 1 | 0 | 1
2 | 4 | 5 | 3 | 16 | 12 | 1 | 1 | 8 | 1 | 1 | 1 | 4 | 0 | 2
2 | 5 | 4 | 3 | 16 | 12 | 1 | 1 | 8 | 1 | 1 | 2 | 6 | 0 | 3
4 | 6 | 1 | 3 | 16 | 12 | 1 | 1 | 8 | 1 | 1 | 3 | 0 | 1 | 0
8 | 8 | 5 | 3 | 16 | 12 | 1 | 1 | 8 | 1 | 1 | 4 | 10 | 1 | 4
