Brmanzo/esp-computer-vision/sim/unit_testing/conv_layer/test_cases_stride.csv

InBits | WeightBits | OutBits | KernelWidth | LineWidthPx | LineCountPx | InChannels | OutChannels | BiasBits | Stride | Padding | DSPCount | Unsigned | ShiftBits
1 | 2 | AUTO | 2 | 16 | 12 | 1 | 1 | 8 | 2 | 1 | 0 | 0 | 0
1 | 2 | AUTO | 3 | 16 | 12 | 1 | 1 | 8 | 3 | 0 | 0 | 0 | 0
1 | 2 | AUTO | 4 | 16 | 12 | 1 | 1 | 8 | 4 | 1 | 0 | 0 | 0
1 | 2 | AUTO | 5 | 17 | 13 | 1 | 1 | 8 | 2 | 1 | 0 | 0 | 0
