Brmanzo/esp-computer-vision/sim/unit_testing/conv_layer/test_cases_width.csv

InBits | WeightBits | OutBits | KernelWidth | LineWidthPx | LineCountPx | InChannels | OutChannels | BiasBits | Stride | Padding | DSPCount | Unsigned | ShiftBits
1 | 2 | AUTO | 1 | 16 | 12 | 1 | 1 | 8 | 1 | 0 | 0 | 0 | 0
1 | 2 | 1 | 2 | 16 | 12 | 1 | 1 | 8 | 1 | 1 | 0 | 0 | 0
2 | 2 | AUTO | 2 | 16 | 12 | 1 | 1 | 8 | 1 | 1 | 0 | 0 | 0
2 | 2 | AUTO | 5 | 16 | 12 | 1 | 1 | 8 | 1 | 1 | 0 | 0 | 0
4 | 5 | AUTO | 3 | 16 | 12 | 1 | 1 | 8 | 1 | 1 | 0 | 0 | 0
8 | 8 | AUTO | 3 | 16 | 12 | 1 | 1 | 8 | 1 | 1 | 0 | 0 | 0
