Brmanzo/esp-computer-vision/rtl/top/top.sv

// top.sv
// Bradley Manzo, 2026

module top #(
)  (
   input [0:0] clk_12mhz_i
  ,input [0:0] reset_n_async_unsafe_i
  // ,input [3:1] button_async_unsafe_i

  ,input  [0:0] rx_serial_i
  ,output [0:0] tx_serial_o

  ,input  [0:0] esp_rx_i
  ,output [0:0] esp_tx_o
  ,input  [0:0] esp_rst_i

  ,output [0:0] uart_rts_o
  // ,output [5:1] led_o
);

  wire [0:0] clk_12mhz_o;
  wire [0:0] pll_lock;

  wire [0:0] reset_n_sync_q;
  wire [0:0] reset_sync_q;
  wire [0:0] rst_sync; // Use this as your reset_signal

  // wire [3:1] button_sync_q;
  // wire [3:1] button_q;

  wire [0:0] rts; // RTS to backpressure ESP UART
  assign uart_rts_o = rts;

  dff #(
  ) sync_a (
     .clk_i  (clk_12mhz_o)
    ,.reset_i(1'b0)
    ,.en_i   (1'b1)
    // When not targeting ESP, esp_rst_i (pin 45) is unconnected and floats.
    // Tie it to 1 so a floating pin can't hold the design in permanent reset.
`ifdef ESP
    ,.d_i    (reset_n_async_unsafe_i & esp_rst_i)
`else
    ,.d_i    (reset_n_async_unsafe_i)
`endif
    ,.q_o    (reset_n_sync_q)
  );

  inv #(
  ) inv (
     .a_i(reset_n_sync_q)
    ,.b_o(reset_sync_q)
  );

  dff #(
  ) sync_b (
     .clk_i  (clk_12mhz_o)
    ,.reset_i(1'b0)
    ,.en_i   (1'b1)
    ,.d_i    (reset_sync_q)
    ,.q_o    (rst_sync)
  );

  // // Synchronize and Debounce Buttons
  // generate
  //   for(genvar idx = 1; idx <= 3; idx++) begin : gen_sync
  //     dff #(
  //     ) sync_a ( 
  //        .clk_i  (clk_12mhz_o)
  //       ,.reset_i(1'b0)
  //       ,.en_i   (1'b1)
  //       ,.d_i    (button_async_unsafe_i[idx])
  //       ,.q_o    (button_sync_q[idx])
  //     );

  //     dff #(
  //     ) sync_b (
  //        .clk_i  (clk_12mhz_o)
  //       ,.reset_i(1'b0)
  //       ,.en_i   (1'b1)
  //       ,.d_i    (button_sync_q[idx])
  //       ,.q_o    (button_q[idx])
  //     );
  //   end
  // endgenerate
       
  (* blackbox *)
  SB_PLL40_2_PAD #(
     .FEEDBACK_PATH("SIMPLE")
    ,.DIVR        (4'b0000)
    ,.DIVF        (7'd63)   // Fout = 12 * 64 / 64 = 12 MHz  (VCO = 768 MHz)
    ,.DIVQ        (3'd6)
    ,.FILTER_RANGE(3'b001)
  ) pll_inst (
     .PACKAGEPIN   (clk_12mhz_i)
    ,.PLLOUTGLOBALA(clk_12mhz_o)
    ,.PLLOUTGLOBALB()
    ,.LOCK         (pll_lock)
    ,.RESETB       (1'b1)
    ,.BYPASS       (1'b0)
  );
  

wire [0:0] uart_rx;
wire [0:0] uart_tx;

// Either synthesize to GPIO for ESP32c3
`ifdef ESP
  assign uart_rx = esp_rx_i;
  assign uart_tx = esp_tx_o;

  assign tx_serial_o = 1'b1;
// or synthesize to USB-to-UART bridge for python demo
`else
  assign uart_rx = rx_serial_i;
  assign uart_tx = tx_serial_o;

  assign esp_tx_o = 1'b1;
`endif

  uart_cnn #(
     .WidthIn    (40)
    ,.HeightIn   (30)
    ,.BusBits    (8)
    ,.InBits     (1)
    ,.FileName_0    ("nn/data/roms/hex/layer_0_weights.hex")
    ,.FileName_1    ("nn/data/roms/hex/layer_1_weights.hex")
    ,.FileName_2    ("nn/data/roms/hex/layer_2_weights.hex")
    ,.FileName_3    ("nn/data/roms/hex/layer_3_weights.hex")
  ) uart_cnn_inst (
     .clk_i      (clk_12mhz_o)
    ,.rst_i      (rst_sync | ~pll_lock)  // hold reset until PLL locks

    ,.rx_serial_i(uart_rx)
    ,.tx_serial_o(uart_tx)

    ,.uart_rts_o (rts)
  );

endmodule
