Brmanzo/esp-computer-vision/nn/config.py

# nn.config.py
# Bradley Manzo 2026

import math
from   typing import List, Optional

from nn.quantize import QSchedule
from nn.constants import DSP_CAP, BUS_WIDTH

class InputDimensions:
    '''Organizes spatial input dimensions, as well as term_count for the classifier.'''
    def __init__(self, width: Optional[int], height: Optional[int]):
        self.width  = width
        self.height = height
        if width is not None and height is not None:
            self.term_count = width * height

class ConvConfig:
    '''Parameterizes a convolutional layer for pytorch training, hardware generation, and cocotb verification.'''
    def __init__(self, in_ch: int, in_bits: int, out_bits: int, kernels: List[List[int]], 
                 stride: int, padding: int, q_schedule: QSchedule, 
                 out_ch: int, layer_num: int, bias_bits: int, 
                 input_dims: InputDimensions, dsp_count: int = 0, shift: int = 0):
        self._shift       = shift
        self._dsp_count   = dsp_count
        self._in_bits     = in_bits
        self._out_bits    = out_bits
        self._bias_bits   = bias_bits
        self._kernels     = kernels
        self._stride      = stride
        self._padding     = padding
        self._q_schedule  = q_schedule
        self._in_ch       = in_ch
        self._out_ch      = out_ch
        self._layer_num   = layer_num
        self._input_dims  = input_dims
        self._kernel_width = kernels[layer_num][0]

        self._cycle_count = 1
        if self._dsp_count > 0:
            assert out_ch % self._dsp_count == 0, f"Layer {layer_num}: DSPCount ({self._dsp_count}) must divide OutChannels ({out_ch}) evenly!"
            effective_dsps = min(self._dsp_count, out_ch)
            neurons_per_dsp = (out_ch + effective_dsps - 1) // effective_dsps
            total_terms = self._kernel_width**2 * self._in_ch
            self._cycle_count = neurons_per_dsp * (total_terms + 1) + 2

        # Input logic
        if self._layer_num == 0:
            self._valid_i = "valid_i"
            self._data_i  = "data_i"
            self._ready_o = "ready_o"
        else: 
            self._ready_o = f"conv_{self._layer_num}_ready"
            if len(kernels[self._layer_num - 1]) == 1:
                self._valid_i = f"conv_{self._layer_num - 1}_valid"
                self._data_i  = f"conv_{self._layer_num - 1}_data"
            else:
                self._valid_i = f"pool_{self._layer_num - 1}_valid"
                self._data_i  = f"pool_{self._layer_num - 1}_data"

        self._valid_o = f"conv_{self._layer_num}_valid"
        self._data_o  = f"conv_{self._layer_num}_data"
        if len(kernels[self._layer_num]) > 1:
            self._ready_i = f"pool_{self._layer_num}_ready"
        elif self._layer_num == len(kernels) - 2:
            self._ready_i = f"classifier_ready"
        else:
            self._ready_i = f"conv_{self._layer_num + 1}_ready"

class PoolConfig:
    '''Parameterizes each pooling layer for pytorch training, hardware generation, and cocotb verification.'''
    def __init__(self, in_ch: int, in_bits: int, kernel: int, mode: str, layer_num: int, num_layers: int,
                 line_width_px: Optional[int] = None, line_count_px: Optional[int] = None, shift: int = 0):
        self._shift      = shift
        self._input_dims = InputDimensions(line_width_px, line_count_px)
        self._layer_num  = layer_num
        self._in_bits    = in_bits
        self._out_bits   = in_bits  # Pooling doesn't change bit-width
        self._kernel_width = kernel
        self._in_ch      = in_ch
        self._out_ch     = in_ch 
        self._mode       = 0 if mode == "max" else 1

        self._cycle_count = self._kernel_width**2

        self._valid_i = f"conv_{self._layer_num}_valid"
        self._data_i  = f"conv_{self._layer_num}_data"
        if self._layer_num == num_layers - 2:
            self._ready_i = f"classifier_ready"
        else:
            self._ready_i = f"conv_{self._layer_num + 1}_ready"
        self._ready_o = f"pool_{self._layer_num}_ready"
        self._valid_o = f"pool_{self._layer_num}_valid"
        self._data_o  = f"pool_{self._layer_num}_data"

class ClassifierConfig:
    '''Parameterizes the final classifier layer for pytorch training, hardware generation, and cocotb verification.'''
    def __init__(self, in_ch: int, in_bits: int, out_bits: int, num_classes: int, bias_bits: int,
                 q_schedule: QSchedule, layer_num: int, kernels: List[List[int]], 
                 dsp_count: int = 0, line_width_px: Optional[int] = None, 
                 line_count_px: Optional[int] = None, shift: int = 0):
        self._shift       = shift
        self._dsp_count   = dsp_count
        self._in_ch       = in_ch
        self._in_bits     = in_bits
        self._out_bits    = out_bits
        self._bias_bits   = bias_bits
        self._num_classes = num_classes
        self._q_schedule  = q_schedule
        self._layer_num   = layer_num
        self._line_width_px = line_width_px
        self._line_count_px = line_count_px
        self._kernels     = kernels

        self._term_count = InputDimensions(line_width_px, line_count_px).term_count  # Classifier doesn't have spatial dimensions
        
        linear_cycles = 1
        if dsp_count > 0:
            assert num_classes % dsp_count == 0, f"Classifier: DSPCount ({dsp_count}) must divide num_classes ({num_classes}) evenly!"
            effective_dsps = min(dsp_count, num_classes)
            neurons_per_dsp = (num_classes + effective_dsps - 1) // effective_dsps
            linear_cycles = neurons_per_dsp * self._in_ch + 1
        self._cycle_count = self._term_count + linear_cycles

        # Classifier layers are connected to the last feature block (either conv or pool)
        if len(kernels[self._layer_num - 1]) > 1:
            self._valid_i = f"pool_{self._layer_num - 1}_valid"
            self._data_i  = f"pool_{self._layer_num - 1}_data"
        else:
            self._valid_i = f"conv_{self._layer_num - 1}_valid"
            self._data_i  = f"conv_{self._layer_num - 1}_data"

        # Classifier layers are always followed by the next layer's conv block
        self._ready_i = f"ready_i"

        # Classifier layers are never at the immediate head or tail, so we don't need to
        # account for global input or output connections here.
        self._ready_o = f"classifier_ready"
        self._valid_o = f"valid_o"
        self._data_o  = f"data_o"

class LayerConfig:
    '''Each layer is comprised of a convolution layer and potentially a pooling layer.'''
    def __init__(self, ConvLayer: ConvConfig, PoolLayer: Optional[PoolConfig] = None):
        self.ConvLayer = ConvLayer
        self.PoolLayer = PoolLayer

class NNConfig:
    '''Accepts high-level network specs, and translates into detailed layer-by-layer configurations.'''
    def full_precision_acc_bits(self, in_channels, kernel_size, in_bits, weight_bits):
        '''Calculates full precision output width for convolution.'''
        term_count = in_channels * (kernel_size ** 2)
        acc_bits   = in_bits + weight_bits + math.ceil(math.log2(term_count))
        return acc_bits

    def __init__(self, input_dimensions: InputDimensions, in_channels: List[int], 
                 in_bits: List[int], kernels: List[List[int]], stride:  List[int] | int, 
                 padding: List[int] | int, bias_bits: List[int] | int,
                 num_classes: int,  q_schedule: List[QSchedule],
                 bus_width: int=BUS_WIDTH, use_dsp: Optional[List[int]] = None):
        
        self.num_classes = num_classes
        
        # In channels length defines the number of layers
        self.num_layers = len(in_channels)
        # Input dimensions of the first layer are provided and subsequent layers are inferred based on conv/pool parameters
        self.in_dims    = input_dimensions
        self._in_bits   = in_bits
        self._bus_width = bus_width
        self._bias_bits = bias_bits
        
        # Determine out_channels for all layers (including classifier)
        out_channels = in_channels[1:] + [num_classes]

        # The master list holding the structured layer objects
        self.layers: List[LayerConfig] = []

        # Quantization schedule for each layer, used in training, and also to determine bit-widths for weights and activations
        self.q_schedule = q_schedule
        self.dsp_count  = use_dsp or ([0] * self.num_layers)
        assert sum(self.dsp_count) <= DSP_CAP, f"Total DSPCount across all layers ({sum(self.dsp_count)}) cannot exceed DSP_CAP ({DSP_CAP})!"
        # --- Running State Variables ---
        # These track the dimensions and bit-widths as data flows through the network
        current_w = input_dimensions.width
        current_h = input_dimensions.height
        current_out_bits = None # Will be set at the end of each loop

        for i in range(self.num_layers):
            c_in_ch  = in_channels[i]
            c_out_ch = out_channels[i]
            c_kernel = kernels[i][0]
            
            # Stride and padding can be fixed for every layer, or layer-specific
            c_stride = stride[i]  if isinstance(stride, list) else stride
            c_pad    = padding[i] if isinstance(padding, list) else padding
            
            # Layer-specific bias bits
            c_bias_bits = bias_bits[i] if isinstance(bias_bits, list) else bias_bits

            # Weight bits are determined by the final quantized width, but full precision 
            # accumulation needs to account for the maximum possible width during training.
            c_weight_bits = q_schedule[i]._q_min_bits
            c_max_weight_bits = q_schedule[i]._q_max_bits
            
            # 1. Determine In Bits
            if i == 0:
                c_in_bits = in_bits[0]
            elif i < len(in_bits) and in_bits[i] != -1:
                c_in_bits = in_bits[i]
            else:
                assert current_out_bits is not None, "Input bit-width is undefined for this layer"
                c_in_bits = current_out_bits

            # 2. Check if this is the final layer (Classifier)
            if i == self.num_layers - 1:
                acc_bits = self.full_precision_acc_bits(c_in_ch, c_kernel, c_in_bits, c_max_weight_bits)
                c_out_bits = self._bus_width
                c_shift = acc_bits - c_out_bits

                self.classifier_config = ClassifierConfig(
                    in_ch=c_in_ch, 
                    in_bits=c_in_bits, 
                    out_bits=c_out_bits,
                    num_classes=num_classes, 
                    q_schedule=q_schedule[i], 
                    layer_num=i,
                    kernels=kernels,
                    dsp_count=self.dsp_count[i],
                    bias_bits=c_bias_bits,
                    line_width_px=current_w, 
                    line_count_px=current_h,
                    shift=c_shift
                )
                break # Classifier always concludes the nn construction

            # 3. Otherwise, determine Out Bits for standard Conv layer
            acc_bits = self.full_precision_acc_bits(c_in_ch, c_kernel, c_in_bits, c_max_weight_bits)
            if i < len(in_bits) - 1 and in_bits[i+1] != -1:
                c_out_bits = in_bits[i+1]
                c_shift = acc_bits - c_out_bits
            else:
                c_out_bits = acc_bits
                c_shift = 0

            # 4. Create ConvConfig
            conv_cfg = ConvConfig(
                in_ch=c_in_ch, in_bits=c_in_bits, out_bits=c_out_bits,
                kernels=kernels, stride=c_stride, padding=c_pad, bias_bits=c_bias_bits,
                q_schedule=q_schedule[i], out_ch=c_out_ch, layer_num=i,
                input_dims=InputDimensions(current_w, current_h),
                dsp_count=self.dsp_count[i],
                shift=c_shift
            )
    
            # 5. Update Spatial Dimensions (Post-Conv)
            # Next layer's input dimensions are reduced by kernel width - 1 if not padding
            if current_w is not None:
                current_w = ((current_w + 2 * c_pad - c_kernel) // c_stride) + 1
            if current_h is not None:
                current_h = ((current_h + 2 * c_pad - c_kernel) // c_stride) + 1

            # 6. Check for Pooling & Update Spatial Dimensions (Post-Pool)
            pool_cfg = None
            # If current layer kernel list specifies a second kernel width, then we construct a pooling layer
            if len(kernels[i]) > 1:
                p_kernel = kernels[i][1]
                pool_cfg = PoolConfig(
                    in_ch=c_out_ch, in_bits=c_out_bits, kernel=p_kernel, mode="max",
                    layer_num=i, num_layers=self.num_layers,
                    line_width_px=current_w, line_count_px=current_h
                )
                # Pooling divides next layer's input dimensions by kernel width
                if current_w is not None:
                    current_w = ((current_w - p_kernel) // p_kernel) + 1
                if current_h is not None:
                    current_h = ((current_h - p_kernel) // p_kernel) + 1

            # 7. Store Layer & Update State
            self.layers.append(LayerConfig(ConvLayer=conv_cfg, PoolLayer=pool_cfg))
            current_out_bits = c_out_bits

    def cycle_count(self) -> tuple[int, float]:
        """Return (total_pipeline_latency_cycles, bottleneck_cycles_per_input_pixel).

        Bottleneck is the maximum effective cycles/pixel across all pipeline stages,
        accounting for pixel decimation introduced by each pool layer.
        """
        total      = 0
        bottleneck = 0.0
        decimation = 1

        for layer in self.layers:
            c = layer.ConvLayer._cycle_count
            total     += c
            bottleneck = max(bottleneck, c / decimation)

            if layer.PoolLayer is not None:
                p = layer.PoolLayer._cycle_count
                total     += p
                bottleneck = max(bottleneck, p / decimation)
                decimation *= layer.PoolLayer._kernel_width ** 2

        cls_c      = self.classifier_config._cycle_count
        total     += cls_c
        bottleneck = max(bottleneck, cls_c / decimation)

        return total, bottleneck
