Brmanzo/esp-computer-vision/boards/icebreakerV1_1a/icebreaker.pcf

# Icebreaker Physical Constraints File (.pcf)
# 
# This file assigns inputs/outputs to physical pins numbers on the icebreaker board.
#
# This particular PCF is derived from:
# https://github.com/YosysHQ/icestorm/blob/master/examples/icebreaker/icebreaker.pcf
# and adapted to use naming mechanisms consistent with the BSG style
# guide

# RS232
set_io -nowarn rx_serial_i          6
set_io -nowarn tx_serial_o          9

## Board Clock: 12 MHz
set_frequency  clk_12mhz_i             12
set_io -nowarn clk_12mhz_i             35

## Buttons
set_io -nowarn reset_n_async_unsafe_i  10

set_io -nowarn button_async_unsafe_i[1]   20
set_io -nowarn button_async_unsafe_i[2]   19
set_io -nowarn button_async_unsafe_i[3]   18

# LEDs and Buttons (PMOD 2)
set_io -nowarn led_o[1]                26 # L1
set_io -nowarn led_o[2]                27 # L2
set_io -nowarn led_o[3]                25 # L3
set_io -nowarn led_o[4]                23 # L4
set_io -nowarn led_o[5]                21 # L5

# PMOD 1A
set_io -nowarn esp_rx_i                 4
set_io -nowarn esp_tx_o                 2
set_io -nowarn uart_rts_o              47
set_io -nowarn esp_rst_i               45
set_io -nowarn ssd_o[4]                 3
set_io -nowarn ssd_o[5]                48
set_io -nowarn ssd_o[6]                46
set_io -nowarn ssd_o[7]                44

# PMOD 1B
set_io -nowarn tx_main_clk_o           43 
set_io -nowarn tx_lr_clk_o             38
set_io -nowarn tx_data_clk_o           34
set_io -nowarn tx_data_o               31
set_io -nowarn rx_main_clk_o           42
set_io -nowarn rx_lr_clk_o             36
set_io -nowarn rx_data_clk_o           32
set_io -nowarn rx_data_i               28
