Brmanzo/esp-computer-vision/firmware/main/capture.c

// capture.c
// Bradley Manzo 2026
#include "driver/gpio.h"
#include "driver/uart.h"

#include "includes/arducam.h"
#include "includes/capture.h"
#include "includes/globals.h"
#include "includes/gpio.h"
#include "includes/spi.h"
#include "includes/uart.h"
#include "includes/wifi_cam.h"

#define KERNEL_W 3

/* -------------------------------------- Packet Encoding
 * -------------------------------------- */
enum packet_contents {
  HEADER_START_H,
  HEADER_START_L,
  IMAGE_HEIGHT_H,
  IMAGE_HEIGHT_L,
  IMAGE_WIDTH_H,
  IMAGE_WIDTH_L,
  PACKET_LEN_H,
  PACKET_LEN_L,
  HEADER_END_H,
  HEADER_END_L,
  DATA_START
};

void encapsulate(uint8_t *packet, uint16_t packet_len, char *mode, uint16_t w,
                 uint16_t h, uint8_t decision, uint8_t threshold) {
  if (strcmp(mode, "header") == 0) {
    packet[HEADER_START_H] = 0xFF;
    packet[HEADER_START_L] = 0x01;
    packet[IMAGE_HEIGHT_H] = (uint8_t)(h >> 8);
    packet[IMAGE_HEIGHT_L] = (uint8_t)(h & 0xFF);
    packet[IMAGE_WIDTH_H] = (uint8_t)(w >> 8);
    packet[IMAGE_WIDTH_L] = (uint8_t)(w & 0xFF);
    packet[HEADER_END_H] = 0xFF;
    packet[HEADER_END_L] = 0x02;
  } else if (strcmp(mode, "data len") == 0) {
    packet[PACKET_LEN_H] = (packet_len) >> 8;
    packet[PACKET_LEN_L] = (packet_len) & 0xFF;
  } else if (strcmp(mode, "footer") == 0) {
    packet[DATA_START + packet_len + 0] = decision;
    packet[DATA_START + packet_len + 1] = threshold;
    packet[DATA_START + packet_len + 2] = 0xFF;
    packet[DATA_START + packet_len + 3] = 0xFD;
  }
}

/* -------------------------------------- UART RX Task
 * -------------------------------------- */

typedef struct {
  uint8_t *dst; // destination buffer
  size_t cap;   // total buffer capacity
  size_t got;   // bytes received so far
  bool done;
  bool error;
} rx_ctx_t;

static void uart_rx_task(void *arg) {
  rx_ctx_t *ctx = (rx_ctx_t *)arg;

  const TickType_t deadline = xTaskGetTickCount() + pdMS_TO_TICKS(2000);

  bool saw_0d = false;

  while (true) {
    int r = uart_read_bytes(UART_NUM_1, ctx->dst + ctx->got,
                            ctx->cap - ctx->got, // capacity, not expected
                            pdMS_TO_TICKS(20));
    if (r < 0) {
      ctx->error = true;
      break;
    }
    if (r > 0) {
      for (int i = 0; i < r; i++) {
        uint8_t b = ctx->dst[ctx->got + i];
        if (saw_0d) {
          if (b == 0x5A) {
            ctx->got += i + 1; // include tail
            ctx->done = true;
            vTaskDelete(NULL);
            return;
          }
          saw_0d = false;
        }
        if (b == 0xA5) {
          saw_0d = true;
        }
      }
      ctx->got += (size_t)r;
    }

    if (xTaskGetTickCount() > deadline) {
      ctx->error = true;
      break;
    }

    if (ctx->got >= ctx->cap) {
      ctx->error = true; // overflow protection
      break;
    }
  }
  ctx->done = true;
  vTaskDelete(NULL);
}

bool singleCapture(void) {

  static uint8_t capture_num = 0;
  static uint8_t adaptive_th = 0;
  uint8_t downsample_factor = 4; // Produces a 40x30 image from QVGA (160x120)

  const uint16_t W = QVGA_WIDTH / downsample_factor;
  const uint16_t H = QVGA_HEIGHT / downsample_factor;
  const size_t tx_bytes = (((size_t)W * H + 7) / 8) + HEADER_SIZE;

  // Received output activation is smaller
  const size_t rx_bytes = 1 + FOOTER_SIZE; // For FPGA decision

  arducam_camlock_take();

  /* -------------------- Start Arducam Capture Sequence -------------------- */
  arducam_set_capture();
  arducam_reset_fifo();
  arducam_start_capture();

  static bool last_push = false;
  static bool last_boot = false;
  
  bool push_pressed = (gpio_get_level(GPIO_PUSH_BTN) == 1);
  bool boot_pressed = (gpio_get_level(GPIO_BOOT_BTN) == 0);

  if (push_pressed && boot_pressed) {
      capture_num = RECALIBRATE_INTERVAL;
  } else {
      if (push_pressed && !last_push) {
          int new_th = adaptive_th + 5;
          adaptive_th = (new_th > 255) ? 255 : new_th;
          ESP_LOGI("cam", "Manual TH up: %u", adaptive_th);
      }
      if (boot_pressed && !last_boot) {
          int new_th = adaptive_th - 5;
          adaptive_th = (new_th < 0) ? 0 : new_th;
          ESP_LOGI("cam", "Manual TH down: %u", adaptive_th);
      }
  }
  
  last_push = push_pressed;
  last_boot = boot_pressed;

  const TickType_t t0 = xTaskGetTickCount();
  while (!spi_get_bit(ARDUCHIP_TRIG, CAP_DONE_MASK)) {
    // Spin without sleep for precision, or very short sleep
    // vTaskDelay(1);
    if ((xTaskGetTickCount() - t0) > pdMS_TO_TICKS(1000)) {
      ESP_LOGE("cam", "Timeout waiting for CAP_DONE");
      spi_write_reg(ARDUCHIP_FIFO, 0x00); // Stop
      arducam_camlock_give();
      return false;
    }
  }
  arducam_stop_capture();

  /* ------------- Stream and Compress YUV422 Data from Arducam ------------- */
  uint8_t *gray_q_tx = heap_caps_malloc(tx_bytes, MALLOC_CAP_8BIT);
  if (!gray_q_tx) {
    ESP_LOGE("cam", "OOM gray_q_tx %u", (unsigned)tx_bytes);
    arducam_camlock_give();
    return false;
  }
  // Reads Raw YUV422 from fifo and packs to 1bpp grayscale
  esp_err_t re = arducam_read_and_pack_stream(gray_q_tx, tx_bytes, &adaptive_th,
                                              capture_num, downsample_factor);

  arducam_camlock_give();

  if (re != ESP_OK) {
    ESP_LOGE("cam", "read/pack failed: %s", esp_err_to_name(re));
    free(gray_q_tx);
    return false;
  }

  /* -------- Transmit Packed 1bpp Data to FPGA for Image Processing-------- */

  // Skip fpga and publish if sampling for adaptive threshold only
  if (capture_num >= RECALIBRATE_INTERVAL) {
    free(gray_q_tx);
    ESP_LOGI("cam", "Recalibration capture #%u: adaptive_th=%u",
             (unsigned)capture_num, (unsigned)adaptive_th);
    capture_num = 0;
    return true;
  }

  uint8_t *gray_q_rx = (uint8_t *)heap_caps_malloc(rx_bytes, MALLOC_CAP_8BIT);
  if (!gray_q_rx) {
    ESP_LOGE("main", "OOM gray_q_rx");
    free(gray_q_tx);
    return false;
  }
  // Create FPGA rx task and transmit over uart
  rx_ctx_t rx = {.dst = gray_q_rx,
                 .cap = rx_bytes,
                 .got = 0,
                 .done = false,
                 .error = false};
  uart_flush_input(UART_NUM_1);
  xTaskCreatePinnedToCore(uart_rx_task, "uart_rx", 4096, &rx, 10, NULL, 0);

  // Necessary for proper image alignment on UART
  const size_t CHUNK_SIZE = 128;
  size_t sent = 0;
  while (sent < tx_bytes) {
    size_t n = tx_bytes - sent;
    if (n > CHUNK_SIZE)
      n = CHUNK_SIZE;

    uart_write_bytes(UART_NUM_1, (const char *)(gray_q_tx + sent), n);
    sent += n;

    // Tiny delay to let FPGA drain its FIFO
    // Even 1 tick or a simple busy-wait might be enough
    esp_rom_delay_us(100);
  }

  // Wait for RX to finish
  while (!rx.done)
    vTaskDelay(pdMS_TO_TICKS(10));

  if (rx.error) {
    ESP_LOGE("uart", "rx failed: got %u/%u bytes", (unsigned)rx.got,
             (unsigned)rx.cap);
    free(gray_q_tx);
    free(gray_q_rx);
    return false;
  }
  /* ---------------------- Package and Publish Frame ---------------------- */
  const size_t raw_bytes = tx_bytes - HEADER_SIZE;
  const size_t payload_bytes =
      raw_bytes + 2; // Raw image data + 1 decision byte + 1 threshold byte

  size_t packet_len =
      DATA_START + payload_bytes + 2; // header + payload + 0xFF + 0xFD
  uint8_t *packet = heap_caps_malloc(packet_len, MALLOC_CAP_8BIT);
  if (!packet) {
    ESP_LOGE("main", "packet malloc failed");
    free(gray_q_tx);
    free(gray_q_rx);
    return false;
  }

  uint8_t decision = gray_q_rx[0];

  // Encode Image dimensions in header
  encapsulate(packet, 0, "header", W, H, 0, 0);
  // Encode Data length in header
  encapsulate(packet, (uint16_t)payload_bytes, "data len", W, H, 0, 0);

  // Package raw 1bpp data within packet body (always send raw image data)
  memcpy(packet + DATA_START, gray_q_tx + HEADER_SIZE, raw_bytes);

  // Encode footer with decision byte, threshold byte, and packet end markers
  encapsulate(packet, (uint16_t)raw_bytes, "footer", W, H, decision, adaptive_th);

  free(gray_q_tx);
  free(gray_q_rx);

  esp_err_t rc = publish_frame(packet, packet_len);
  if (rc == ESP_OK)
    ESP_LOGI("main", "published %u bytes", (unsigned)packet_len);
  else
    ESP_LOGW("main", "publish failed: %d", rc);

  free(packet);
  vTaskDelay(pdMS_TO_TICKS(1));
  return true;
}
