Brmanzo/esp-computer-vision/rtl/blocks/conv2d.sv

/* verilator lint_off PINCONNECTEMPTY */
`timescale 1ns / 1ps
module conv2d #(
   parameter  int unsigned LineWidthPx = 160
  ,parameter  int unsigned LineCountPx = 120
  ,parameter  int unsigned WidthIn     = 1
  ,parameter  int unsigned WidthOut    = 32
  ,parameter  int unsigned KernelWidth = 3
  ,parameter  int unsigned WeightWidth = 2
  ,localparam int unsigned KernelArea  = KernelWidth * KernelWidth
)  (
   input  [0:0] clk_i
  ,input  [0:0] rst_i

  ,input  [0:0]         valid_i
  ,output [0:0]         ready_o
  ,input  [WidthIn-1:0] data_i

  ,output [0:0] valid_o
  ,input  [0:0] ready_i

  ,output logic signed [WidthOut-1:0] data_o
  ,input  logic signed [KernelArea-1:0][WeightWidth-1:0] weights_i
);

  /* ---------------------------------------- Kernel Validation ---------------------------------------- */
  wire [0:0] in_fire = valid_i & ready_o;

  localparam int XWidth = (LineWidthPx <= 1) ? 1 : $clog2(LineWidthPx);
  localparam int YWidth = (LineCountPx <= 1) ? 1 : $clog2(LineCountPx);

  logic [XWidth-1:0] x_pos;
  logic [YWidth-1:0] y_pos;

  wire [0:0] last_col = (x_pos == XWidth'(LineWidthPx - 1));
  wire [0:0] last_row = (y_pos == YWidth'(LineCountPx - 1));

  always_ff @(posedge clk_i) begin
    // Update x and y position counters
    if (rst_i) begin
      x_pos <= '0;
      y_pos <= '0;
    end else if (in_fire) begin
      if (last_col) begin
        x_pos <= '0;
        y_pos <= (last_row) ? '0 : (y_pos + 1);
      end else begin
        x_pos <= x_pos + 1;
      end
    end
  end

  wire [0:0] valid_x_pos = (x_pos >= (XWidth'(KernelWidth - 1)));
  wire [0:0] valid_y_pos = (y_pos >= (YWidth'(KernelWidth - 1)));

  wire [0:0] valid_kernel_pos = valid_x_pos && valid_y_pos;

  wire [0:0] produce = valid_kernel_pos & in_fire;

  /* ------------------------------------ Elastic Handshaking Logic ------------------------------------ */
  // Provided Elastic State Machine Logic
  logic [0:0] valid_r;

  always_ff @(posedge clk_i) begin
    if (rst_i)        valid_r <= 1'b0;
    else if (ready_o) valid_r <= produce;
  end

  assign valid_o =  valid_r;
  assign ready_o = ~valid_r | ready_i;

  /* ------------------------------------ FIFO RAM Instantiations ------------------------------------ */
  // Both RAMs step forward with each new pixel input (in_fire) so that delay is exactly one row each.
  // RAM 1 produces a delay of one row. Reads off of data_i as the bottom row of the kernel receives new data.
  // Unpacked array of vectors to hold each row buffer
  logic [KernelWidth-1:0][WidthIn-1:0] row_buffers;
  assign row_buffers[0] = data_i; // Row buffer 0 is current data input

  multi_delay_buffer #(
     .Width    (WidthIn)
    ,.Delay    (LineWidthPx - 1)
    ,.BufferCnt(KernelWidth - 1)
  ) multi_delay_buffer_inst (
    .clk_i   (clk_i)
    ,.rst_i  (rst_i)

    ,.data_i (data_i)
    ,.valid_i(in_fire)
    ,.ready_o()

    ,.data_o (row_buffers[KernelWidth-1:1]) // Row buffers >= 1 read from delay buffer
    ,.valid_o()
    ,.ready_i(1'b1)
  );

  /* ------------------------------------ Window Register Logic ------------------------------------ */
  // Row major Order(window[row][col])
  logic [WidthIn-1:0] window [KernelWidth][KernelWidth];

  always_ff @(posedge clk_i) begin
    if (rst_i) begin
        for (int i = 0; i < KernelWidth; i++) begin
          for (int j = 0; j < KernelWidth; j++) begin
              window[i][j] <= '0;
          end
        end
    end else if (in_fire) begin
      /* ------------------------------- Internal Connections ------------------------------- */
      // Line feeds from right to left within window
      // Bottom line
      for (int r = 0; r < KernelWidth; r++) begin
        for (int c = 0; c < KernelWidth - 1; c++) begin
            window[r][c] <= window[r][c+1];
        end
      end
      /* -------------------------------- Input Connections -------------------------------- */
      // Load new data into the rightmost column of the window
      // Top line <- Twice seen data from second RAM
      for (int r = 0; r < KernelWidth; r++) begin
        window[r][KernelWidth-1] <= row_buffers[KernelWidth-1 - r];
      end
    end
  end
  /* ------------------------------------ Output Logic ------------------------------------ */
  mac #(
     .KernelWidth (KernelWidth)
    ,.WidthIn     (WidthIn)
    ,.WidthOut    (WidthOut)
    ,.WeightWidth (WeightWidth)
  ) mac_inst (
     .window   (window)
    ,.weights_i(weights_i)
    ,.data_o   (data_o)
  );

endmodule
