Brmanzo/esp-computer-vision/nn/constants.py

# nn.constants.py — iCE40 Icebreaker V1.1a board constraints
# Kept separate from nn.globals to avoid circular imports with nn.config.

import math


BRAM_CAP    = 30 - 1   # subtract 1 for deframer skid buffer BRAM
DSP_CAP     = 8
LC_CAP      = 5280
MAX_LC_ERR  = 0.09
LC_HEADROOM = math.ceil(5280*MAX_LC_ERR)   # 528 LCs to absorb max underprediction error
BUS_WIDTH   = 8

BAUD        = 115200       # 12 MHz / (prescale=13 * 8) ≈ 115385 baud (0.16% error)
CLK_FREQ_HZ = 12_000_000
