Brmanzo/esp-computer-vision/sim/integration_testing/single_block/test_single_block.py

import numpy as np
import os
from   pathlib import Path
import pytest

from util.utilities  import runner, clock_start_sequence, reset_sequence, auto_unpack, inject_weights_and_biases, load_tests_from_csv
from util.bitwise    import unpack_kernel_weights, pack_terms, unpack_biases
from util.gen_inputs import gen_biases, gen_kernels, gen_input_channels
from util.components import ModelRunner, RateGenerator, InputModel, OutputModel
from functional_models.conv_layer import output_width, calc_acc_bits
from functional_models.single_block import SingleBlockModel
from util.torch_ref import torch_single_block_ref
tbpath = Path(__file__).parent

import cocotb
from   cocotb.triggers import RisingEdge, FallingEdge, with_timeout
from   cocotb.result import SimTimeoutError
   
import random
random.seed(50)

timescale = "1ps/1ps"

timescale = "1ps/1ps"
tests = ['reset_test'
        ,'single_test'
        ,'inout_fuzz_test'
        ,'in_fuzz_test'
        ,'out_fuzz_test'
        ,'full_bw_test']

auto_rules = [
    ("C_OutBits", "C_OutBits", lambda C_InBits, C_WeightBits, C_KernelWidth, C_InChannels, C_BiasBits, C_Unsigned: output_width(C_InBits, C_WeightBits, C_KernelWidth, C_InChannels, C_BiasBits, C_Unsigned))
]

gen_rules = [
    ("C_Weights", lambda C_WeightBits, C_OutChannels, C_InChannels, C_KernelWidth: gen_kernels(C_WeightBits, C_OutChannels, C_InChannels, C_KernelWidth, seed=1234)),
    ("C_Biases", lambda C_BiasBits, C_OutChannels: gen_biases(C_BiasBits, C_OutChannels, seed=1234))
]

TEST_CASES = load_tests_from_csv(os.path.join(tbpath, "test_cases.csv"), auto_rules, gen_rules)
@pytest.mark.parametrize("test_name", tests)
@pytest.mark.parametrize("simulator", ["verilator", "icarus"])
@pytest.mark.parametrize("C_DSPCount", [0,1])
@auto_unpack(TEST_CASES)
def test_each(test_name, simulator, 
              C_LineWidthPx, C_LineCountPx, C_InBits, C_OutBits, C_KernelWidth,
              P_KernelWidth, C_WeightBits, C_BiasBits, C_InChannels,
              C_Weights, C_Biases, C_OutChannels, C_Padding, P_Mode, C_ShiftBits, C_DSPCount, C_Unsigned):
    parameters = dict(locals())
    parameters.pop('C_Biases', None)
    parameters.pop('C_Weights', None)
    param_str = f"InBits_{C_InBits}_WeightBits_{C_WeightBits}_OutBits_{C_OutBits}_DSP_{C_DSPCount}_test_{test_name}"

    total_weight_bits = C_OutChannels * C_InChannels * (C_KernelWidth**2) * C_WeightBits
    total_bias_bits   = C_OutChannels * C_BiasBits

    # inject_weights_and_biases uses C{layer}_X key naming; add aliases for the layer-0 lookup
    parameters["C0_OutChannels"] = C_OutChannels
    parameters["C0_InChannels"]  = C_InChannels
    parameters["C0_KernelWidth"] = C_KernelWidth

    if simulator == "icarus" and int(C_DSPCount) > 0:
        pytest.skip("Icarus Verilog has issues with ROM initialization in sequential configurations")

    custom_work_dir = inject_weights_and_biases(
        simulator=simulator, parameters=parameters, param_str=param_str,
        tbpath=tbpath, test_class="each", Weights=C_Weights, Biases=C_Biases,
        weight_bits=C_WeightBits, bias_bits=total_bias_bits,
        weight_count=C_OutChannels * C_InChannels * (C_KernelWidth**2),
        layer=0, dsp_count=int(C_DSPCount))

    parameters.pop("C0_OutChannels", None)
    parameters.pop("C0_InChannels",  None)
    parameters.pop("C0_KernelWidth", None)

    runner(
        simulator=simulator, timescale=timescale, tbpath=tbpath, params=parameters,
        pymodule="test_single_block", testname=test_name, work_dir=custom_work_dir,
        sim_build=custom_work_dir, includes=[custom_work_dir], toplevel_override="tb_single_block",
        jsonname=str(tbpath / "single_block.json")
    )

class RandomDataGenerator:
    def __init__(self, dut):
        self._width_p = int(dut.C_InBits.value)
        self._InChannels = int(dut.C_InChannels.value)
        unsigned_obj = getattr(dut, "C_Unsigned", None)
        self._Unsigned = int(unsigned_obj.value) if unsigned_obj is not None else 0

    def generate(self):
        if self._Unsigned:
             from util.gen_inputs import gen_random_unsigned
             import random
             rng = random.Random(None)
             raw_din = [gen_random_unsigned(self._width_p, rng) for _ in range(self._InChannels)]
        else:
             raw_din = gen_input_channels(self._width_p, self._InChannels)
        packed_din = pack_terms(raw_din, self._width_p)
        return (packed_din, raw_din)

@cocotb.test
async def reset_test(dut):
    """Test for Initialization"""
    print("DUT objects:", dir(dut))
    clk_i = dut.clk_i
    rst_i = dut.rst_i
    await clock_start_sequence(clk_i)
    await reset_sequence(clk_i, rst_i, 10)

@cocotb.test
async def single_test(dut):
    """Drive pixels until the first VALID integrated output position, then expect 1 output."""
    
    # 1. Read DUT parameters
    C_W  = int(dut.C_LineWidthPx.value)
    C_H  = int(dut.C_LineCountPx.value)
    C_K  = int(dut.C_KernelWidth.value)
    C_IC = int(dut.C_InChannels.value)
    C_OC = int(dut.C_OutChannels.value)
    C_WW = int(dut.C_WeightBits.value)
    C_BW = int(dut.C_BiasBits.value)
    C_InBits  = int(dut.C_InBits.value)
    C_OutBits = int(dut.C_OutBits.value)
    P_K  = int(dut.P_KernelWidth.value)
    P_M  = int(dut.P_Mode.value)
    C_P  = int(dut.C_Padding.value)
    C_ShiftBits = int(dut.C_ShiftBits.value)
    unsigned_obj = getattr(dut, "C_Unsigned", None)
    C_Unsigned = int(unsigned_obj.value) if unsigned_obj is not None else 0

    N_in = C_W * C_H
    
    # We assume default strides if not exposed as top-level parameters
    C_S = 1 
    P_S = P_K # Standard max pooling stride equals kernel size

    # 2. Setup configuration dictionaries
    packed_weights = int(os.environ["INJECTED_WEIGHTS_0_INT"], 0)
    packed_biases  = int(os.environ["INJECTED_BIASES_0_INT"], 0)
    kernels_4d = unpack_kernel_weights(packed_weights, C_WW, C_OC, C_IC, C_K)
    biases_1d  = unpack_biases(packed_biases, C_BW, C_OC)

    conv_params = {
        "KernelWidth": C_K,
        "LineWidthPx": C_W,
        "LineCountPx": C_H,
        "InBits":      C_InBits,
        "OutBits":     C_OutBits,
        "WeightBits":  C_WW,
        "BiasBits":    C_BW,
        "InChannels":  C_IC,
        "OutChannels": C_OC,
        "Stride":      C_S,
        "Padding":     C_P,
        "ShiftBits":   C_ShiftBits,
        "Unsigned":    C_Unsigned,
        "weights":     kernels_4d,
        "biases":      biases_1d
    }

    # Calculate the intermediate dimension (Output of Conv -> Input of Pool)
    P_W = ((C_W + 2 * C_P - C_K) // C_S) + 1
    P_H = ((C_H + 2 * C_P - C_K) // C_S) + 1

    pool_params = {
        "KernelWidth": P_K,
        "LineWidthPx": P_W,
        "LineCountPx": P_H,
        "InBits":      C_OutBits,
        "OutBits":     C_OutBits, # Pooling generally doesn't change bit width
        "InChannels":  C_OC,
        "OutChannels": C_OC,      # Pooling doesn't change channels
        "Stride":      P_S,
        "PoolMode":    P_M          # Max pooling
    }

    model = SingleBlockModel(dut, conv_params, pool_params)
    m = ModelRunner(dut, model)

    om = OutputModel(dut, RateGenerator(dut, 1), 1)                       
    im = InputModel(dut, RandomDataGenerator(dut), RateGenerator(dut, 1), N_in) 

    dut.ready_i.value = 0
    dut.valid_i.value = 0
    dut.data_i.value = 0

    await clock_start_sequence(dut.clk_i)
    await reset_sequence(dut.clk_i, dut.rst_i, 10)
    await FallingEdge(dut.clk_i)

    m.start()
    om.start()
    im.start()

    tmo_ns = (N_in * 5000) + 100000
    try:
        await om.wait(tmo_ns)
    except SimTimeoutError:
        assert False, f"Timed out waiting for first valid output. Expected after ~{N_in} inputs."

    dut.valid_i.value = 0
    dut.ready_i.value = 0

async def rate_tests(dut, in_rate, out_rate):
    # 1. Read DUT parameters
    C_W  = int(dut.C_LineWidthPx.value)
    C_H  = int(dut.C_LineCountPx.value)
    C_K  = int(dut.C_KernelWidth.value)
    C_IC = int(dut.C_InChannels.value)
    C_OC = int(dut.C_OutChannels.value)
    C_WW = int(dut.C_WeightBits.value)
    C_BW = int(dut.C_BiasBits.value)
    C_InBits  = int(dut.C_InBits.value)
    C_OutBits = int(dut.C_OutBits.value)
    P_K  = int(dut.P_KernelWidth.value)
    P_M  = int(dut.P_Mode.value)
    C_P  = int(dut.C_Padding.value)
    C_ShiftBits = int(dut.C_ShiftBits.value)
    unsigned_obj = getattr(dut, "C_Unsigned", None)
    C_Unsigned = int(unsigned_obj.value) if unsigned_obj is not None else 0
    C_S = 1 
    P_S = P_K 

    # 2. Calculate dimensions for BOTH layers
    # Conv dimensions
    C_W_out = ((C_W + 2 * C_P - C_K) // C_S) + 1
    C_H_out = ((C_H + 2 * C_P - C_K) // C_S) + 1
    
    # Pool dimensions (Final Output)
    P_W_out = ((C_W_out - P_K) // P_S) + 1
    P_H_out = ((C_H_out - P_K) // P_S) + 1
    
    N_in = C_W * C_H
    l_out = P_W_out * P_H_out   

    input_activation  = [[[0 for _ in range(C_W)] for _ in range(C_H)] for _ in range(C_IC)]
    output_activation = [[[0 for _ in range(P_W_out)] for _ in range(P_H_out)] for _ in range(C_OC)]

    # 3. Setup configuration dictionaries
    packed_weights = int(os.environ["INJECTED_WEIGHTS_0_INT"], 0)
    kernels_4d = unpack_kernel_weights(packed_weights, C_WW, C_OC, C_IC, C_K)
    packed_biases  = int(os.environ["INJECTED_BIASES_0_INT"], 0)
    biases_1d  = unpack_biases(packed_biases, C_BW, C_OC)

    conv_params = {
        "KernelWidth": C_K, "LineWidthPx": C_W, "LineCountPx": C_H,
        "InBits": C_InBits, "OutBits": C_OutBits,
        "WeightBits": C_WW, "BiasBits": C_BW,
        "InChannels": C_IC, "OutChannels": C_OC, "Stride": C_S,
        "Padding": C_P, "ShiftBits": C_ShiftBits, "Unsigned": C_Unsigned,
        "weights": kernels_4d,
        "biases":  biases_1d,
        "input_activation": input_activation # Let Conv record inputs
    }

    pool_params = {
        "KernelWidth": P_K, "LineWidthPx": C_W_out, "LineCountPx": C_H_out,
        "InBits": C_OutBits, "OutBits": C_OutBits,
        "InChannels": C_OC, "OutChannels": C_OC, "Stride": P_S,
        "PoolMode": P_M,
        "output_activation": output_activation # Let Pool record final outputs
    }

    model = SingleBlockModel(dut, conv_params, pool_params)
    m = ModelRunner(dut, model)

    slow = min(in_rate, out_rate)
    slow = max(slow, 0.05) 

    first_out_wait_ns = int((N_in * 200 + 50000) / slow)
    timeout_ns        = int((N_in * 5000 + 100000) / slow)

    om = OutputModel(dut, RateGenerator(dut, out_rate), l_out)
    im = InputModel(dut, RandomDataGenerator(dut), RateGenerator(dut, in_rate), N_in)

    dut.ready_i.value = 0
    dut.valid_i.value = 0

    await clock_start_sequence(dut.clk_i)
    await reset_sequence(dut.clk_i, dut.rst_i, 10)
    await FallingEdge(dut.clk_i)

    m.start()
    om.start()
    im.start()

    try:
        await with_timeout(RisingEdge(dut.valid_o), first_out_wait_ns, 'ns')
    except SimTimeoutError:
        assert False, "Timed out waiting for valid_o high."

    try:
        await om.wait(timeout_ns)
        
        # 4. Verify against PyTorch reference
        C_AccBits = calc_acc_bits(C_K, C_InBits, C_WW, C_IC, C_BW, C_Unsigned)
        final_ref = torch_single_block_ref(input_activation, kernels_4d, C_S, in_bits=C_InBits, out_bits=C_OutBits, mode=P_M, pool_kernel_size=P_K, padding=C_P, biases=biases_1d, shift_bits=C_ShiftBits, acc_bits=C_AccBits, unsigned=C_Unsigned)        

        assert np.allclose(output_activation, final_ref.numpy()), "Output activation does not match..."
        print("Test passed! PyTorch matches integrated model.")

    except SimTimeoutError:
        assert False, f"Timed out. Expected {l_out} handshakes. Got {om.nproduced()}"

@cocotb.test
async def out_fuzz_test(dut):
    await rate_tests(dut, in_rate=1.0, out_rate=0.5)

@cocotb.test
async def in_fuzz_test(dut):
    await rate_tests(dut, in_rate=0.5, out_rate=1.0)

@cocotb.test
async def inout_fuzz_test(dut):
    await rate_tests(dut, in_rate=0.5, out_rate=0.5)

@cocotb.test
async def full_bw_test(dut):
    await rate_tests(dut, in_rate=1.0, out_rate=1.0)
