Brmanzo/esp-computer-vision/(commit log)

2025-09-13 Converted Raspberry Pi Pico code into esp-idf for esp32c3. Displays output image to MCU network.
2025-09-17 Added semaphors to prevent WDT stack dumps
    [arducam.c, arducam_demo.c]
2025-09-17 Corrected SPI reads to yield to WDT, stabilizing system
    [arducam.c, arducam.h, arducam_demo.c]
2025-09-18 Added 3x3 convolutional kernel with Sobel filters to verify output
2025-09-18 Added motion tracking using the difference of two frames
2025-12-19 Integrated 2D Convolution Circuit into pipeline so that posted image is the magnitude of the camera feed
2025-12-21 Implemented 8b:2b unpacker circuit and verified with cocotb
2025-12-21 Implemented and verified 2:8 packer circuit
2026-01-08 Added blur filter in hardware to reduce grain
2026-01-08 Calculates average gray val per frame to dynamically threshold between 0 and 1 independent of lighting conditions
2026-01-10 Configured buttons to select which output activation (blur, gx, gy, default:mag) to transmit to ESP
2026-01-14 GPIO_3 Button to publish raw camera data, bypassing FPGA while pressed
2026-01-15 Fixed UART tx dummy byte offset, SPI FIFO dummy bit offset, added UART RTS line for UART FIFO overflow, 1:1 image from tx to FPGA
    [arducam.c, capture.c, icebreaker.pcf, packer.sv, python_demo.py, skid_buffer.sv, top.sv]
2026-01-15 restored original verilog-uart, replaced verilog-axis with custom skid buffer
2026-01-16 Parameterized Sobel filter for variable kernel sizes
2026-01-19 Verified Skid Buffer, added clean all rule for unit tests, linted python errors
    [icebreaker.pcf, skid_buffer.sv]
2026-01-20 Encapsulated Packer with Framer to mark end of the frame with footer 0d, 0a
2026-01-20 Integrated framer into top, adjusted capture rx_task to wait for footer
2026-01-22 Linted Mag and Framer and dependencies to Low Risc Style Guide
2026-01-23 Linted uart_axis, top, and dependencies to Low Risc Style Guide
2026-01-23 Linted Yosys Warnings, formalized esp/usb-uart bridge in top level, restored and siloed vendor files, added clean-all and test-all rules
2026-01-29 conv2d no longer stores padded bits in ram, only padded when performing signed mult. Modified test for random data
    [conv2d.sv, uart_axis.sv]
2026-02-06 Copyright, renaming uart_axis->uart_cnn, and removing unused rtl
2026-02-06 Framer now sends wakeup byte on power or reset, ESP blocks until woken up
    [framer.sv, main.c, uart.c, uart.h]
2026-02-06 Upon rx fail, ESP flushes UART buffer and waits for next wakeup byte
    [arducam.c, capture.c, capture.h, main.c]
2026-02-06 Refactored GPIO, ESP will poll FPGA on timeout via rst, recovering on a silent crash
    [arducam.h, capture.c, gpio.c, gpio.h, i2c.c, icebreaker.pcf, main.c, spi.c]
2026-02-12 Parameterized window logic per group of macs via filter.sv, rm delay_buffer(old)
2026-02-20 Added download button to html for compiling dataset, added ReLU mux
2026-02-26 Verified fully connected (linear) layer against PyTorch, fixed test-all rule
    [fc_layer.sv, tb_fc_layer.sv, test_fc_layer.py, test_neuron.py]
2026-03-04 Corrected Framer in_fuzz fragility, elaborated framer and packer testbenches
    [framer.sv]
2026-04-11 Added unit tests for balanced_add and mac, currently debugging the broken conv_layer stride tests
    [conv_layer.sv, test_conv_layer.py]
2026-04-11 Unit tested filter and multi_delay_ram for mapping to 1 BRAM and real 32 channel mapping
2026-04-12 Resolved failing conv_layer, strengthened filter tests
    [pool_layer.sv, test_conv_layer.py, test_filter.py]
2026-04-16 Inserted register within filter.
2026-04-16 Inserted register between window and filter
2026-04-16 32 channel wide cnn now supported via final register following the final accumulation in filter
2026-04-22 Designed and tested classifier_layer, integrating global_max and comparator tree, renamed bitwidths to prevent truncation
    [classifier_layer.sv, test_classifier_layer.py]
2026-04-23 Model now renders classifier, swapped the order of forward to classifier, global max, then flatten to match hardware
    [classifier_layer.sv, train.py]
2026-04-24 Corrected filter test for sequential behavior, implementing signed input on mac and filter
    [test_filter.py]
2026-04-24 Implemented signed logic, and binary {-1,1} encoding case across suite
2026-04-30 Method to load testcases from csv, updated gitignore
    [test_cases.csv]
2026-05-03 Generalized loading test cases from csv
    [test_cases.csv]
2026-05-03 Corrected degenerate min edge cases, standardized csv test_case format across design suite
    [test_cases.csv, test_cases_avg.csv, test_cases_channels.csv, test_cases_max.csv, test_cases_padding.csv, test_cases_stride.csv, test_cases_width.csv]
2026-05-03 Added methods to sample from dataset and perform inference
2026-05-04 Verified integration of convolution layer and classifier layer
    [test_cases.csv]
2026-05-04 Updated ModelConfig to specify full precision input widths, corrected faulty deframer out_fuzz behavior
    [config.py, deframer.sv, export.py, globals.py, quantize.py]
2026-05-05 Simplified Framer to transmit single byte classification
2026-05-05 Optionally targetting DSPs in conv or classifier, updated training with OneCycleLr Scheduling and Kaiming Weight Initialization
    [test_cases_width.csv]
2026-05-06 Designed and verified sequential neuron to target Icestorm's 8 SB_MAC16 DSP Blocks. For use in conv_layer, linear_layer, and classifier_layer
    [test_cases_width.csv]
2026-05-06 UseDSP=2 in Classifier schedules all neuron accumulations on one Fully Sequential DSP Block.
    [test_cases.csv]
2026-05-06 Saving model source, fixed test_pool_layer
    [hardware_weights.csv]
2026-05-06 running model.model reports hardware accurate BRAM and DSP utilization as well as displaying the pytorch architecture.
    [hardware_weights.csv, test_cases.csv]
2026-05-06 Reconfigured full integration testbench, corrected quantized activation truncation
    [export.py, filter_dsp.sv]
2026-05-07 Refactored Neuron to utilize MAC, generalized output encoding across library
    [test_cases.csv]
2026-05-08 Formalized the sequential implementation, now allocating any number of SB_MAC16s, 0-8 where each (DSP) is allocated an equal amount of out_channels to produce
    [test_cases_channels.csv, test_cases_dsps.csv, test_cases_width.csv]
2026-05-08 Integrated generic counter_roll, resolved issues with modelrunner and affected tests
    [filter_dsp.sv, neuron_dsp.sv, test_filter.py, unpacker.sv]
2026-05-09 Sequentialized convolution layer, upgraded classifier layer, fully verified design suite.
    [hardware_weights.csv, test_cases_avg.csv, test_cases_channels.csv, test_cases_dsps.csv, test_cases_max.csv, test_cases_padding.csv, test_cases_stride.csv, test_cases_width.csv]
2026-05-10 Neuron and Filter DSP now load weights from ROM instead of from parameters. Tested rom and counter_roll.
    [test_cases.csv]
2026-05-11 Updated integration test weight loading, corrected filename type for synthesis
    [classifier_layer.sv, conv_layer.sv, export.py, icestorm_rom.sv, linear_layer.sv, neuron_dsp.sv]
2026-05-12 Deferred RAM instantiation to Yosys, deleted MultiDelayRam, optimized delay stages, linted dsp hardware, upgraded counter_roll
    [test_cases.csv]
2026-05-13 Quantized activations now learn sweet spot, rather than strictly MSB or LSB
    [hardware_weights.csv, test_cases.csv, test_cases_channels.csv, test_cases_dsps.csv, test_cases_out_act.csv, test_cases_padding.csv, test_cases_stride.csv, test_cases_width.csv]
2026-05-14 Propagated unsigned input throughout design datapath
    [test_cases.csv, test_cases_avg.csv, test_cases_max.csv, test_cases_out_act.csv]
2026-05-15 Functional Model and Hardware match pytorch model prediction
    [hardware_weights.csv]
2026-05-15 Updated top and demo for testing with USB serial
    [hardware_weights.csv]
2026-05-17 ROM now loaded in 4kB chunks, and in separate halves if exceeding ram width
    [test_cases.csv, test_cases_dsps.csv]
2026-05-17 Corrected full cnn simulation
    [inference.py]
2026-05-17 Confirmed BRAM contents, corrected PLL frequency, testing framed cnn
    [python_demo.py, tb_cnn_framed.sv, test_cnn_framed.py, top.sv, uart_cnn.sv]
2026-05-17 Tested uart loopback interface with cnn
2026-05-18 Integrating pipeline commands, updated bram util calculation, added hw inference accuracy report
    [hardware_weights.csv]
2026-05-19 Renamed model to nn, abbreviated python calls to cnn.py
    [hardware_weights.csv]
2026-05-20 Corrected filter and neuron dsp tests, relocated filelists to respective unit test directories
    [arch.py, bram.py, config.py, export.py, fpga.py]
2026-05-21 82% hw accuracy after correcting bias decay and learning rate
    [arch.py, export.py, fpga.py, globals.py, inference.py, preprocess.py, quantize.py]
2026-05-22 Corrected CNN Functional Model
    [test_cases_out_act.csv]
2026-05-22 Fixed FPGA test, was missing proper dimensions in top.sv
    [test_cnn_uart.py, top.sv]
2026-05-22 Renamed render.py to verilog.py, and protocol.py to uart.py
2026-05-23 make stat-design now estimates LC and DFF independent of top level, formalized design flow
2026-05-24 Profiled conv_layer for DSPCount=0 over complete design space, then sampled a representative subset for DSPCount > 0 cases
    [profile_coeffs.csv, sweep_conv_dsp_0.csv, sweep_conv_dsp_1-8.csv]
2026-05-25 Predicting a missing corner will dynamically sample and refit the profile
    [profile_coeffs.csv, sweep_conv_dsp_1-8.csv]
2026-05-26 Profiled classifier with same dspcount handling as conv layer
    [test_cases.csv]
2026-05-26 Profiled overhead (uart + skid_buffer + deframer + class_framer)
2026-05-29 Now factors in dsp_count when optimizing, and displays feasible models between 75% and 96.5% LC util
    [profile_coeffs.csv, sweep_conv_dsp_1-8.csv]
2026-05-29 Corrected pytorch input from {0,1} to {-1,1}, enforcing 2^n scaling for weight quantization during training and export,hw_accuracy now closer to float_accuracy and matches FPGA
    [arch.py, export.py, inference.py, preprocess.py, quantize.py]
2026-05-30 Corrected 1x1 kernel edge case, updated testbenches for additional layer filenames
    [conv_layer.sv, tb_cnn_framed.sv, test_cnn_framed.py, test_cnn_uart.py]
2026-05-30 Redefined misattributed LC as true LUT4 measurement
    [classifier_coeffs.csv, profile_coeffs.csv, sweep_classifier_dsp_0.csv, sweep_classifier_dsp_1_8.csv, sweep_conv_dsp_0.csv, sweep_conv_dsp_1-8.csv, sweep_deframer.csv]
2026-05-31 LUT4 is a poor predictor of total_LC for dsp>0 case, since LUT4 are directed at coordinating FF logic rather than raw multiplication. Total LC can be accurately predicted from predicted FF, since fea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
2026-06-01 Refactored profiling into hardware and accuracy dirs. Generalized generate and sweep nn for any task
    [classifier_coeffs.csv, profile_coeffs.csv, sweep_classifier_dsp_0.csv, sweep_classifier_dsp_1_8.csv, sweep_conv_dsp_0.csv, sweep_conv_dsp_1-8.csv, sweep_deframer.csv]
2026-06-01 Fixing DSP=0 layer weight bits to 4, to determine if wb or ob is the true predictor of nn accuracy
    [constants.py, plot.py, train.py]
2026-06-03 Decreased ESP resolution to 160x120, down-sample to 40x30, padded MNIST from 28x28, retrained, and validated
2026-06-03 Boot button now manually steps down the lighting threshold while push button steps it up. Pushing both activates original calibration
2026-06-17 Updated documentation, corrected off-by-two gen-network error
    [arch.py, export.py, globals.py, plot.py, preprocess.py]
